EHash/Open-Hardware-Canaan-A851-A3210M/A851_HASH/README.txt

A851_HASH                                   	Software Version

BOM hash851-x26_V1_0_2_180625_BOM.csv

SCH	hash8-X26_V1.0.pdf			PDF

	A3210.SchDoc				Altium Designer 14.3.15

	CONNECTOR.SchDoc			Altium Designer 14.3.15

	total.SchDoc				Altium Designer 14.3.15

PCB	hash851-X26_V1_0_180425.brd		Allegro PCB Designer 16.6
