EHash/Open-Hardware-Canaan-A851-A3210M/A851_MM/README.txt

A851_MM                             		Software Version    

BOM	MM851_V1_0_2_180723_BOM.csv

SCH	MM851_SCH_V1_0_190311.pdf		PDF

	MM851_SCH_V1_0_190311.DSN		OrCAD Capture CIS 16.6

PCB	MM851_V1.0_180330.brd			Allegro PCB Designer 16.6
