EHash/Open-Hardware-Canaan-A851-A3210M/A851_mechanical/Structural drawing/README.txt

	Software

stp	creo

dxf	auto cad

pdf	pdf
