EHash/Open-Hardware-Canaan-A851-A3210M/A851_FC/V1_1/README.txt

A851FC	V1_1					Software Version

Bom	FC7_BOM_V1.1_160929.csv

SCH	fc.PDF				        PDF
	FC.SchDoc				Altium Designer 14.3.15

PCB	FC7_V1.1_160929.PcbDoc			Altium Designer 14.3.15
