EHash/Open-Hardware-Canaan-A851-A3210M/A851_PMU/ISL8120/README.txt

ISL8120 Right_board                                          			Software Version
BOM	PMU851_ISL8120_R_V1_0_4_190311_BOM (NTMFS4C05NT1G).csv
SCH	PMU851_ISL8120_R_SCH_V1_0_1_190311.pdf				        PDF
	pmu851_isl8120_r_sch_v1_0_1_190311.DSN					OrCAD Capture CIS 16.6
PCB	PMU851_IS_R_V1_0_180330.brd					       	Allegro PCB Designer 16.6
ISL8120 Left_Board
BOM	PMU851_ISL8120_L_V1_0_4_190311_BOM (NTMFS4C022NT1G).csv
SCH	PMU851_ISL8120_L_SCH_V1_0_1_190311.pdf				        PDF
	PMU851_ISL8120_L_SCH_V1_0_1_190311.DSN					OrCAD Capture CIS 16.6
PCB	PMU851_IS_L_V1_0_180330.brd					       	Allegro PCB Designer 16.6
