EHash/Open-Hardware-Canaan-A851-A3210M/A851_mechanical/Structural drawing/bah0103v2_0/bah0103v2_0.pdf

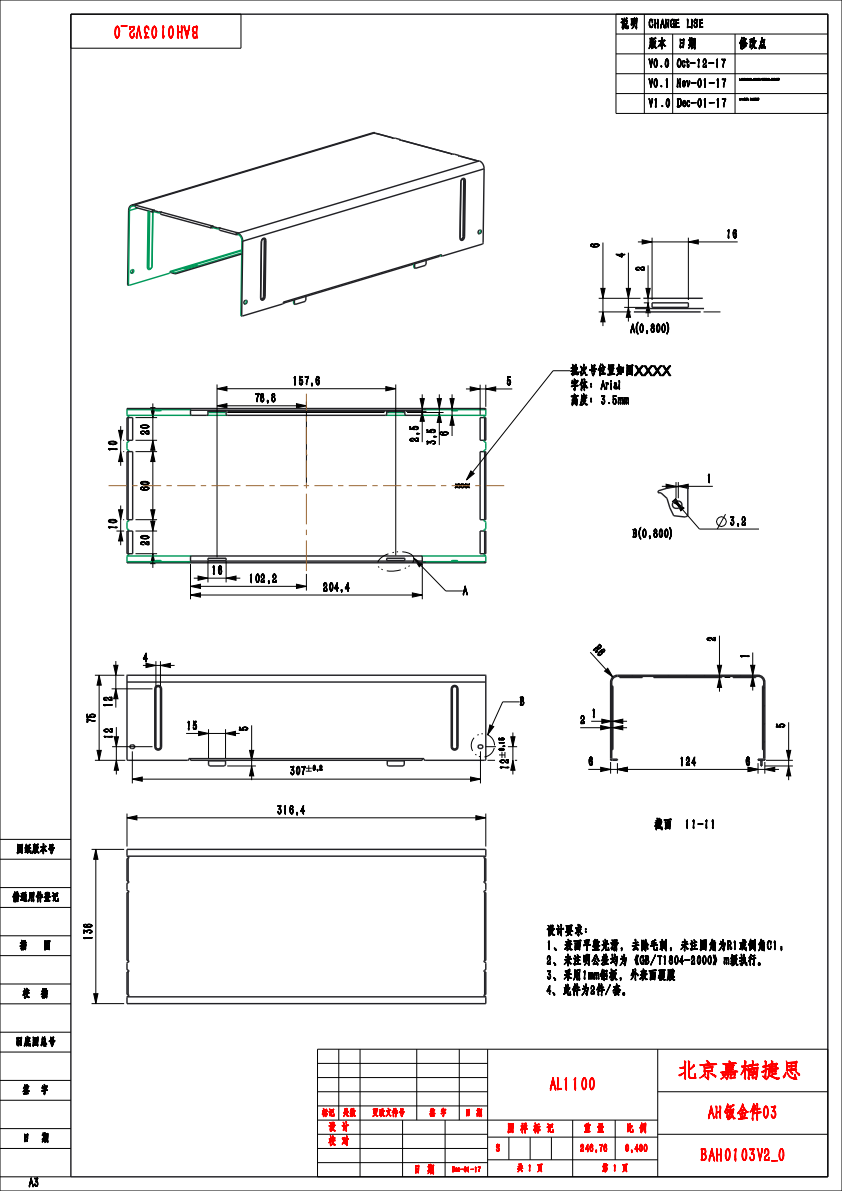
[picture p2: page 1]
图纸版本号; 借通用件登记; 旧底图总号; 北京嘉楠捷思; 更改文件号; AH钣金件03; BAH0103V2_0 S; Dec-01-17; 修改点; V1.0 Dec-01-17 1,V0.1转量产。（无图纸修改）; 设计要求： 1、表面平整光滑，去除毛刺，未注圆角为R1或倒角C1； 2、未注明公差均为《GB/T1804-2000》m级执行。 3、采用1mm铝板，外表面覆膜 4、此件为2件/套。; XXXX; 批次号位置如图XXXX 字体：Arial 高度：3.5mm

说明 CHANGE LISE
V0.0 Oct-12-17

V0.1 Nov-01-17 1,之前由于图纸问题，两侧加强筋，没有做成对称，本次做了调整
