EHash/Open-Hardware-Canaan-A851-A3210M/A851_mechanical/Structural drawing/bah0104v1_1/bah0104v1_1.pdf

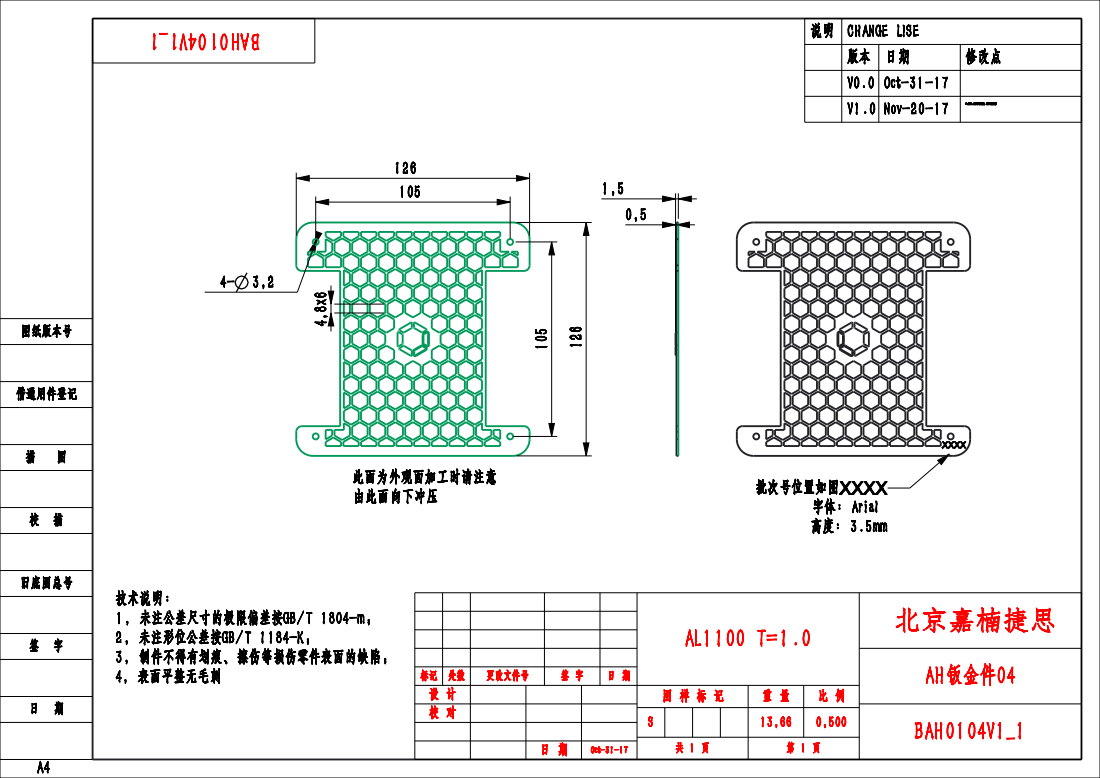
[picture p3: page 1]
图纸版本号; 借通用件登记; 旧底图总号; 北京嘉楠捷思; AH钣金件04 标记 处数; 更改文件号; BAH0104V1_1 S; Oct-31-17; 修改点; 技术说明： 1，未注公差尺寸的极限偏差按GB/T 1804-m； 2，未注形位公差按GB/T 1184-K； 3，制件不得有划痕、擦伤等损伤零件表面的缺陷； 4，表面平整无毛刺; XXXX; 此面为外观面加工时请注意; 由此面向下冲压; 批次号位置如图XXXX; 字体：Arial 高度：3.5mm

说明 CHANGE LISE
V0.0 Oct-31-17

V1.0 Nov-20-17 1,草绘，图层没有隐藏，本次隐藏起来
