EHash/Open-Hardware-Canaan-A851-A3210M/A851_mechanical/Structural drawing/bah0104v2_0/bah0104v2_0.pdf

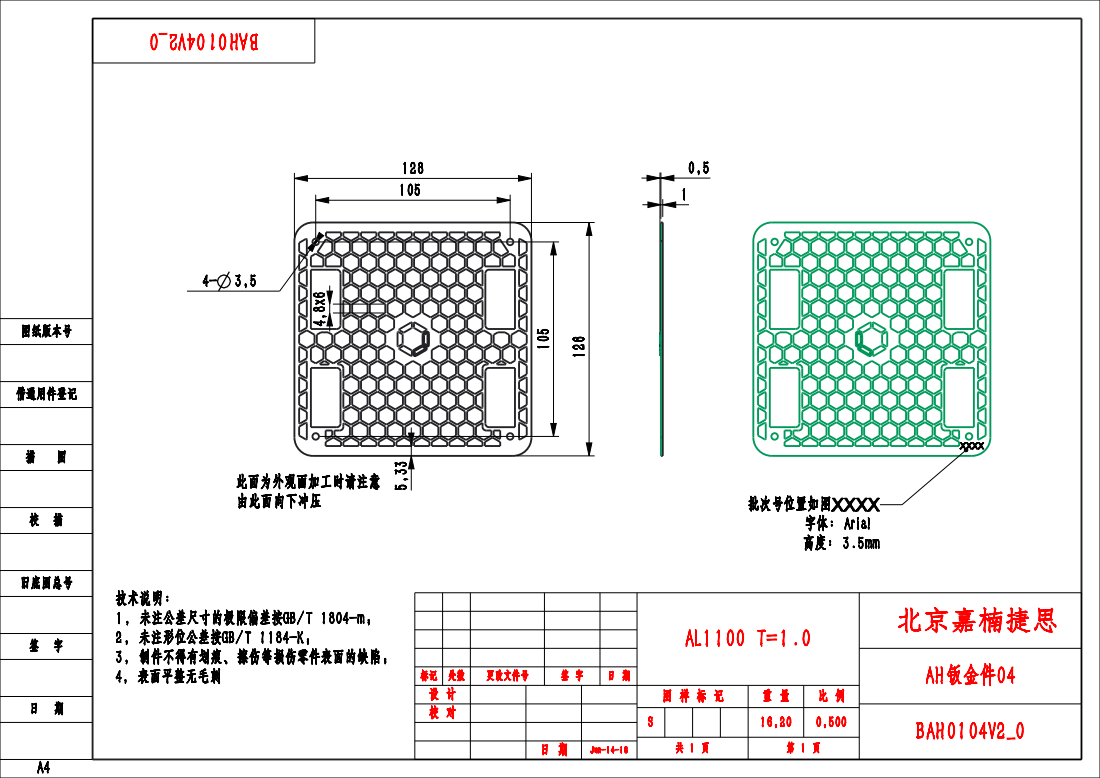
[picture p4: page 1]
图纸版本号; 借通用件登记; 旧底图总号; 北京嘉楠捷思; AH钣金件04 标记 处数; 更改文件号; BAH0104V2_0 S; Jun-14-18; 技术说明： 1，未注公差尺寸的极限偏差按GB/T 1804-m； 2，未注形位公差按GB/T 1184-K； 3，制件不得有划痕、擦伤等损伤零件表面的缺陷； 4，表面平整无毛刺; XXXX; 此面为外观面加工时请注意; 由此面向下冲压; 批次号位置如图XXXX; 字体：Arial 高度：3.5mm
