EHash/Open-Hardware-Canaan-A851-A3210M/A851_mechanical/Structural drawing/bah0201v3_2/bah0201v3_2.pdf

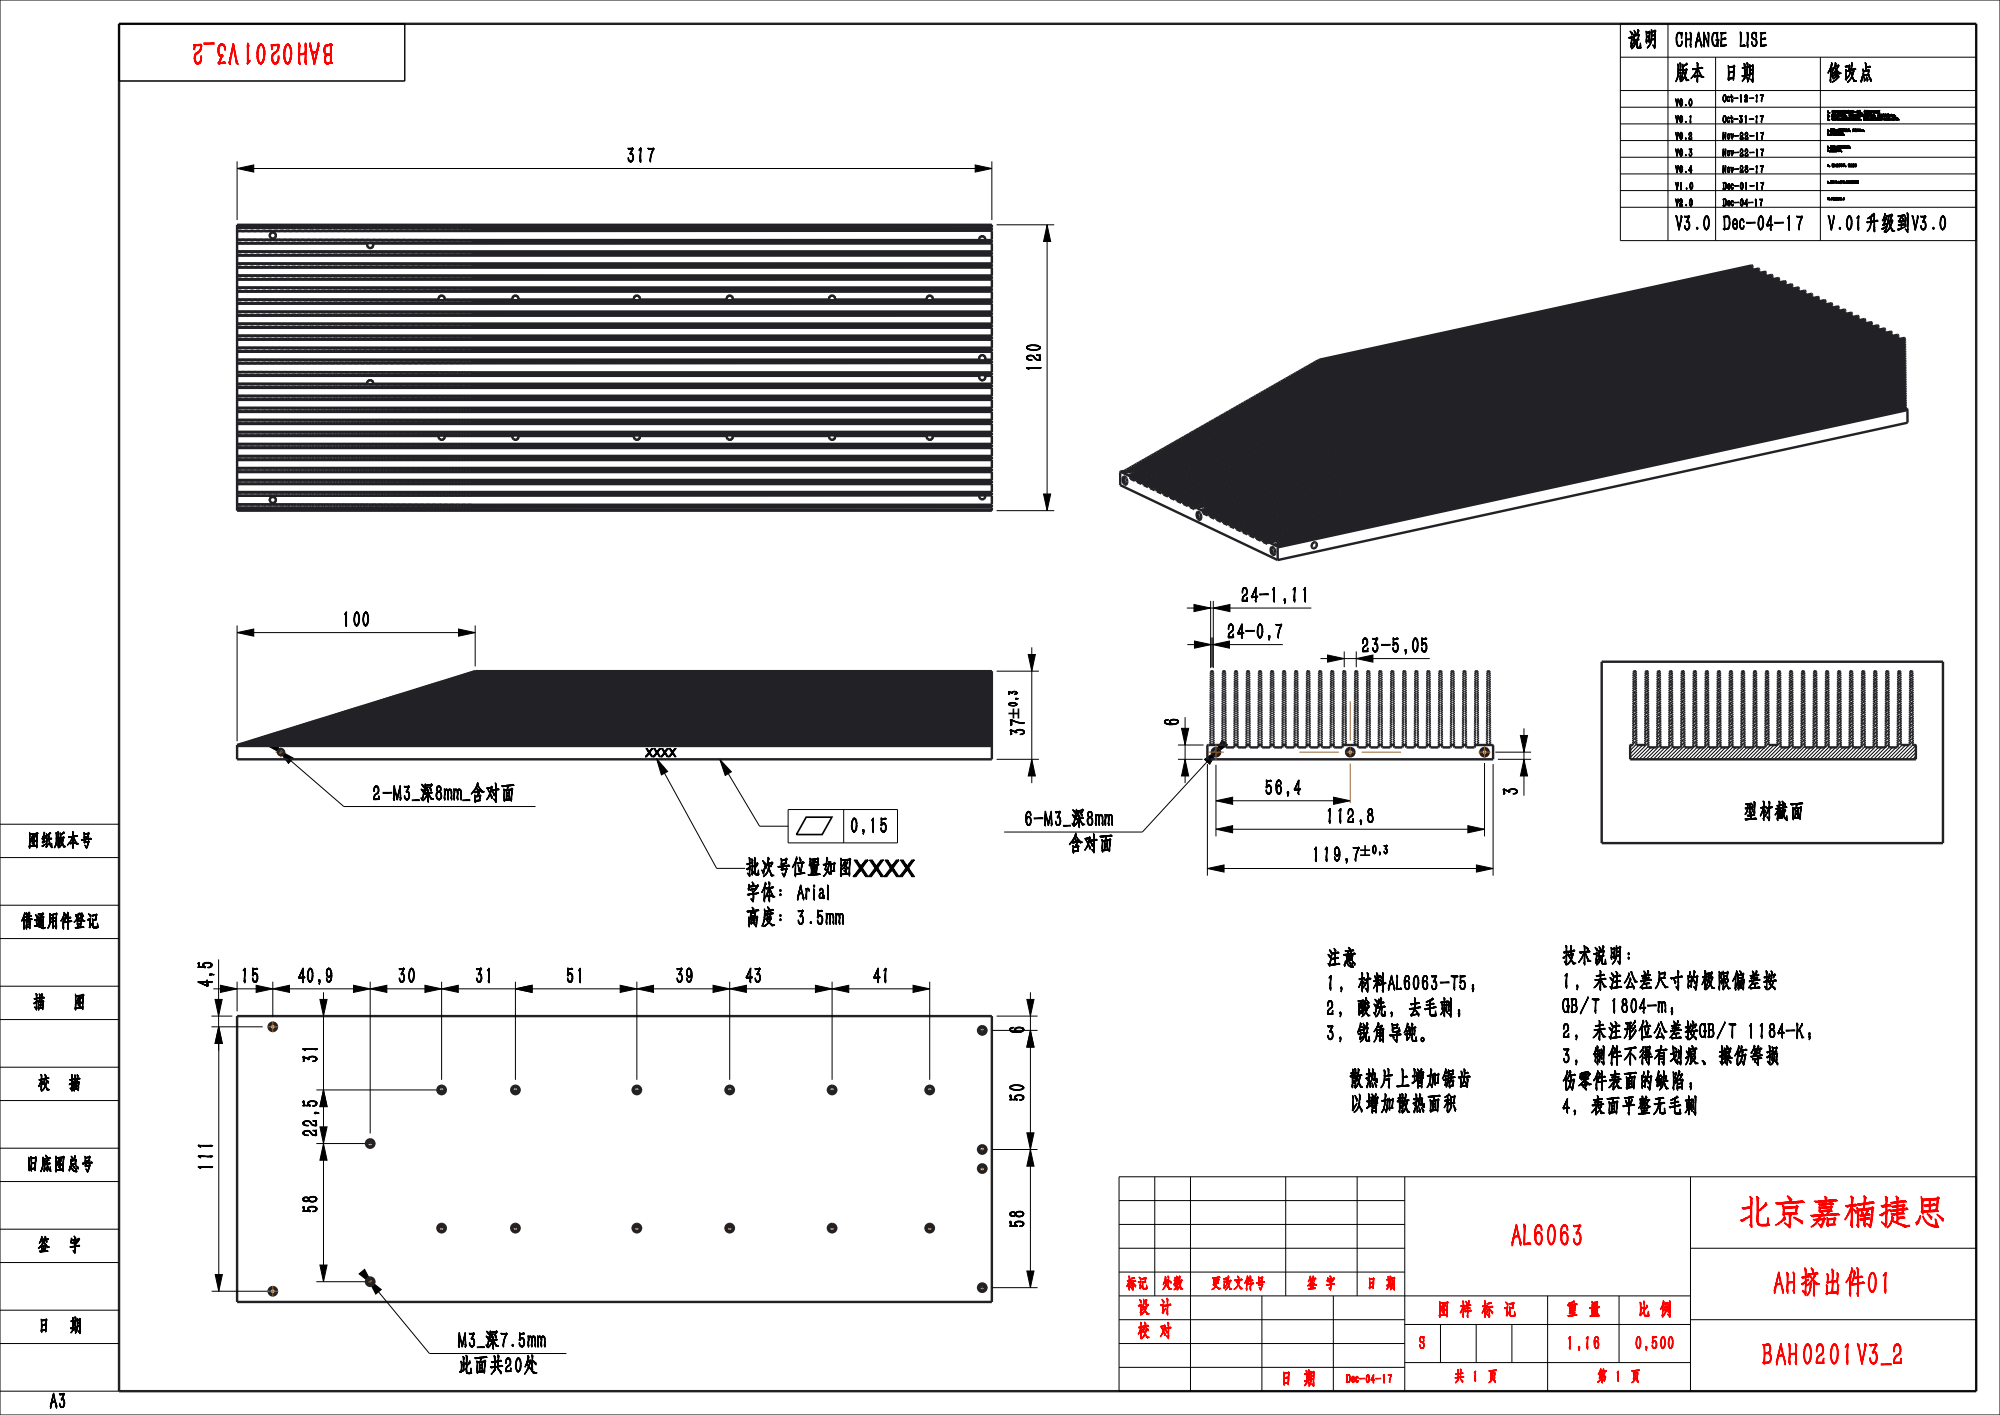
[picture p5: page 1]
图纸版本号; 借通用件登记; 旧底图总号; 6-M _深8mm 含对面; 2-M3_深8mm_含对面; M _深7.5mm 此面共20处; 修改点; Oct-12-17; Oct-31-17; 1，型材中间固定孔增加多一条筋，变成和A741相同 2，HASH板修改了，靠近PMU侧最边上的固定孔，向内移动了13mm； 3，增加了hash与散热片的固定孔，距离上面修改空的尺寸为22.5和30.; Nov-22-17; 1,根据hash板调整长度，变为260mm；; 2,修改固定孔位。; 1,根据hash板调整孔位；; 2,长度为317。; Nov-28-17; 1，增加热管位置，实验样品; Dec-01-17; 1,综合V0.1和V0.2的开孔位置; Dec-04-17; V0.3升级到V2.0; V3.0 Dec-04-17 V.01升级到V3.0; 北京嘉楠捷思; 更改文件号; AH挤出件01; BAH0201V3_2 S; 散热片上增加锯齿 以增加散热面积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
