EHash/Open-Hardware-Canaan-A851-A3210M/A851_mechanical/Structural drawing/bah0301v1_0/bah0301v1_0.pdf

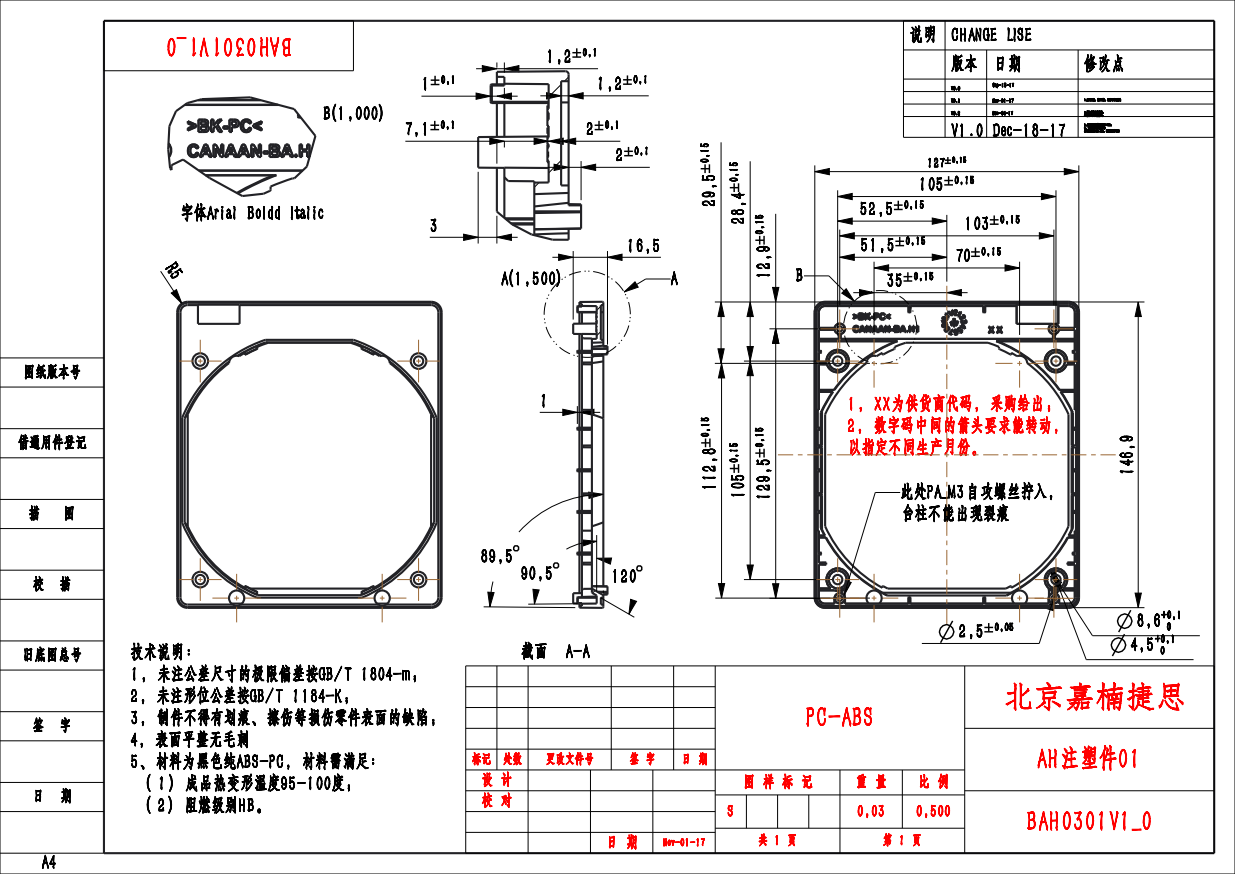
[picture p6: page 1]
图纸版本号; 借通用件登记; 旧底图总号; PC-ABS; 北京嘉楠捷思; 更改文件号; AH注塑件01; BAH0301V1_0 S; Nov-01-17; 修改点; Sep-15-17; 1,图纸细化，增加公差，去掉了草绘轨迹; Nov-04-17; 1,增加厂家识别代码；; 2,增加生产月份标识；; V1.0 Dec-18-17 1,自攻钉孔直径修改为2.5mm；; 2，将与bah0302固定的 柱子直径增加到4.9mm，避免安装后错位; 技术说明： 1，未注公差尺寸的极限偏差按GB/T 1804-m； 2，未注形位公差按GB/T 1184-K； 3，制件不得有划痕、擦伤等损伤零件表面的缺陷； 4，表面平整无毛刺 5、材料为黑色纯ABS-PC，材料需满足： （1）成品热变形温度95-100度； （2）阻燃级别HB。; 1，XX为供货商代码，采购给出； 2，数字码中间的箭头要求能转动， 以指定不同生产月份。; 此处PA_M3自攻螺丝拧入， 台柱不能出现裂痕

说明 CHANGE LISE

字体Arial Boldd Italic
