EHash/Open-Hardware-Canaan-A851-A3210M/A851_mechanical/Structural drawing/bah0303v1_0/bah0303v1_0.pdf

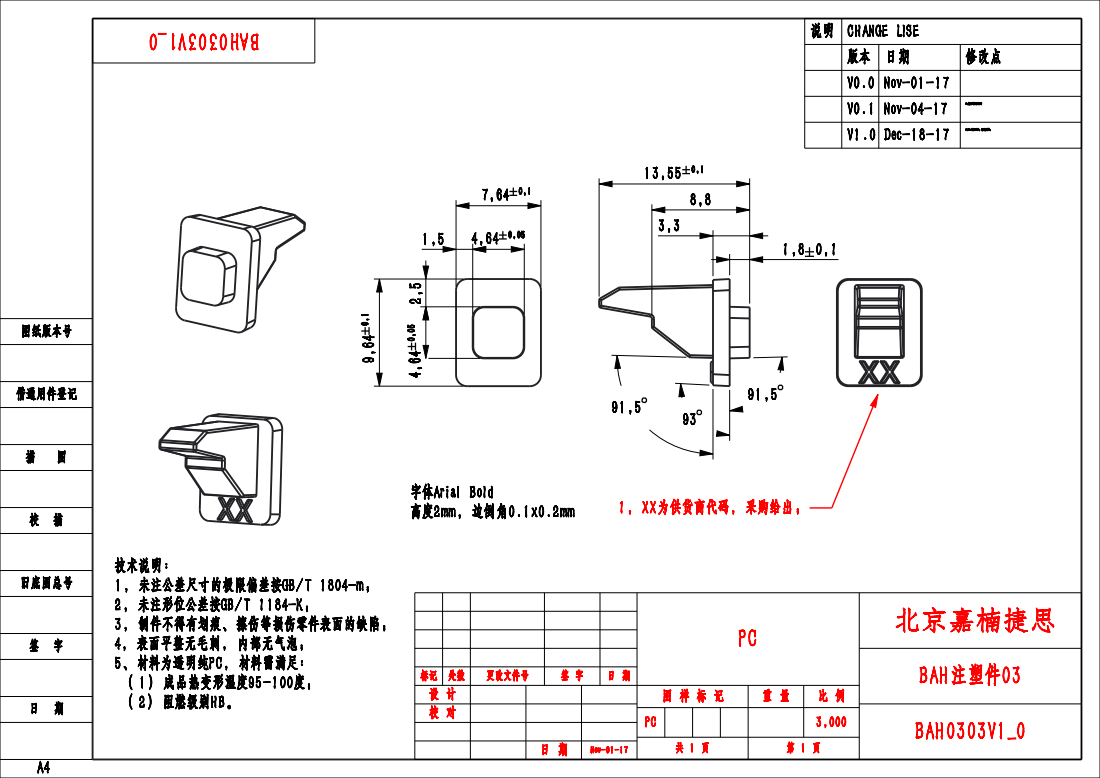
[picture p7: page 1]
图纸版本号; 借通用件登记; 旧底图总号; 北京嘉楠捷思; 更改文件号; BAH注塑件03; BAH0303V1_0 PC; Nov-01-17; 修改点; V1.0 Dec-18-17 1,V0.1转入量产，材质作调整。; 技术说明： 1，未注公差尺寸的极限偏差按GB/T 1804-m； 2，未注形位公差按GB/T 1184-K； 3，制件不得有划痕、擦伤等损伤零件表面的缺陷； 4，表面平整无毛刺, 内部无气泡； 5、材料为透明纯PC，材料需满足： （1）成品热变形温度95-100度； （2）阻燃级别HB。

说明 CHANGE LISE
V0.0 Nov-01-17
V0.1 Nov-04-17 1,增加厂家识别代码

1，XX为供货商代码，采购给出； 字体Arial Bold
高度2mm，边倒角0.1x0.2mm
