EHash/Open-Hardware-Canaan-A851-A3210M/A851_mechanical/Structural drawing/BO131001132V1_0/bo131001132v1_0.pdf

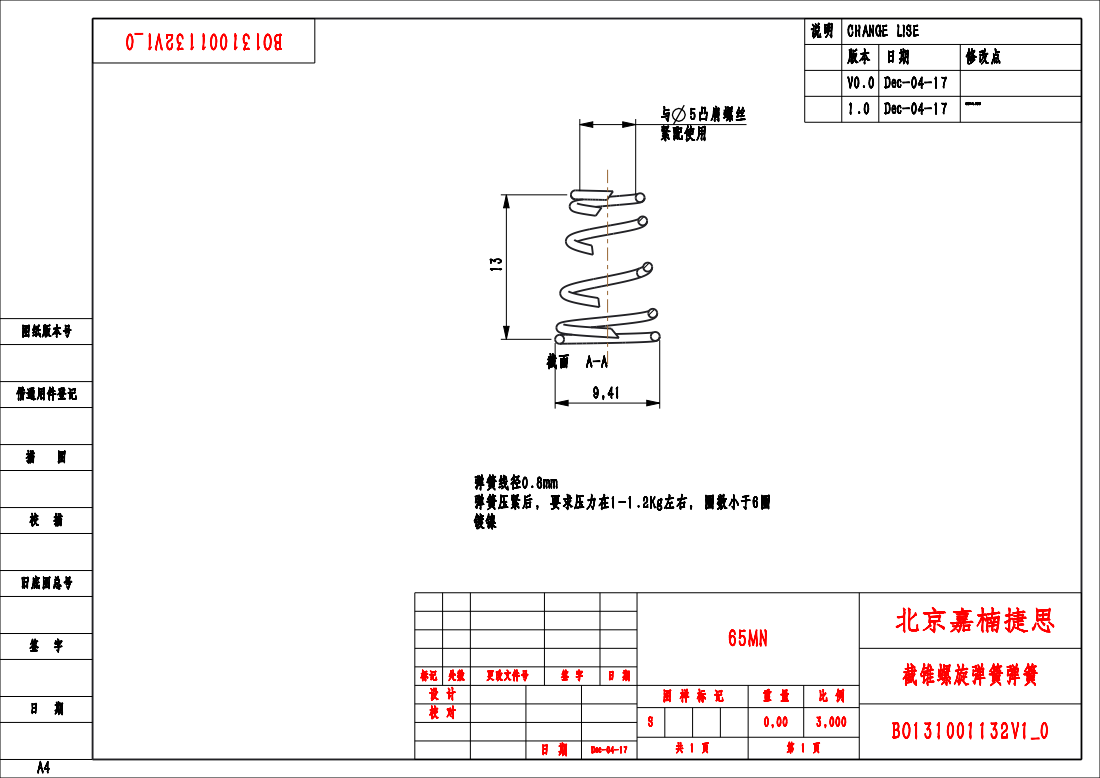
[picture p9: page 1]
图纸版本号; 借通用件登记; 旧底图总号; 凸肩螺丝; 紧配使用; 北京嘉楠捷思; 更改文件号; 截锥螺旋弹簧弹簧; Dec-04-17; 修改点; 弹簧线径0.8mm 弹簧压紧后，要求压力在1-1.2Kg左右，圈数小于6圈 镀镍

说明 CHANGE LISE
V0.0 Dec-04-17
1.0 Dec-04-17 沿用V0.0，无修改
