EHash/Open-Hardware-Canaan-A851-A3210M/A851_mechanical/Structural drawing/bah0102v2_0/bah0102v2_0.pdf

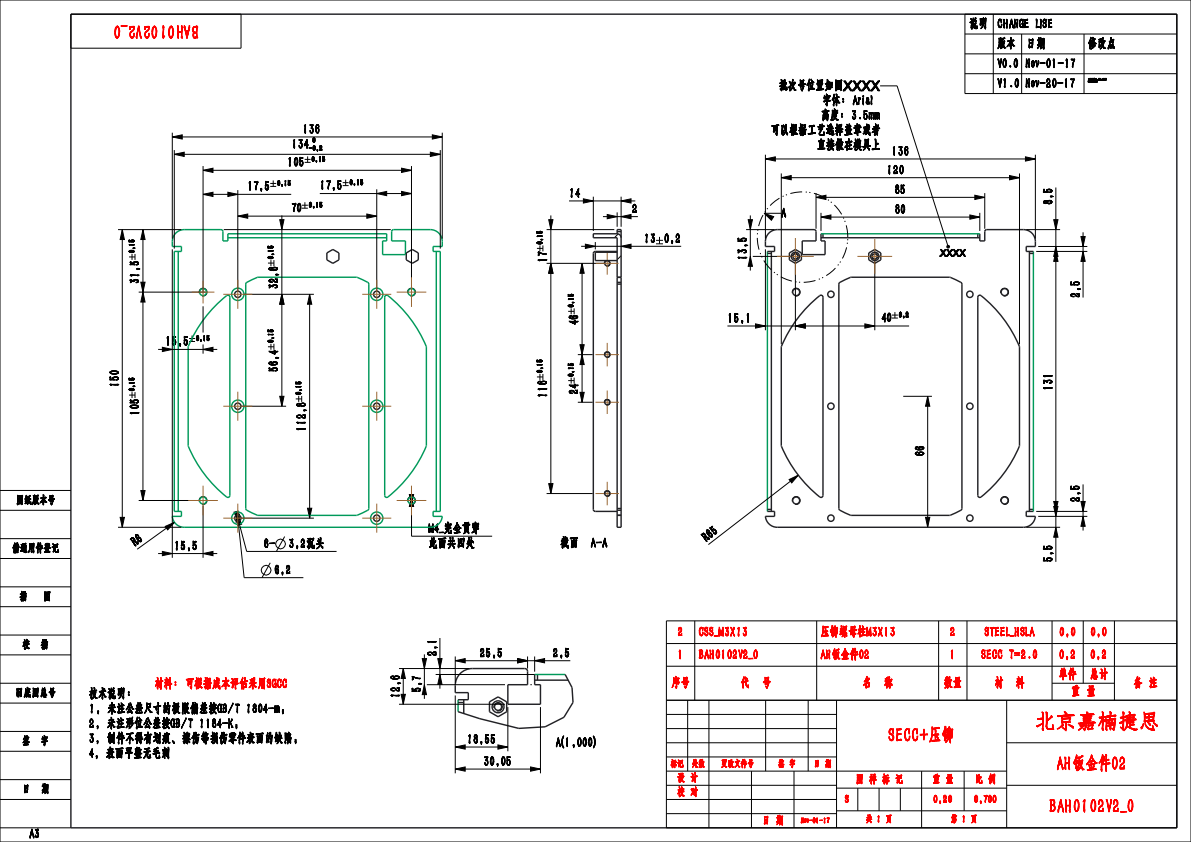
[picture p10: page 1]
图纸版本号; 借通用件登记; 旧底图总号; M _完全贯穿 此面共四处; SECC+压铆; 北京嘉楠捷思; 更改文件号; AH钣金件02; BAH0102V2_0 S; Nov-01-17; 1 BAH0102V2_0; SECC T=2.0; CSS_M3X13; 压铆螺母柱M3X13; STEEL_HSLA; 修改点; 2，高度未标注; 技术说明： 1，未注公差尺寸的极限偏差按GB/T 1804-m； 2，未注形位公差按GB/T 1184-K； 3，制件不得有划痕、擦伤等损伤零件表面的缺陷； 4，表面平整无毛刺; 材料：可根据成本评估采用SGCC; XXXX; 批次号位置如图XXXX 字体：Arial 高度：3.5mm 可以根据工艺选择盖章或者 直接做在模具上

说明 CHANGE LISE
V0.0 Nov-01-17

V1.0 Nov-20-17 1,螺柱参数以、名称、未修改
