EHash/Open-Hardware-Canaan-A851-A3210M/A851_mechanical/Structural drawing/bah0202v3_1/bah0202v3_1.pdf

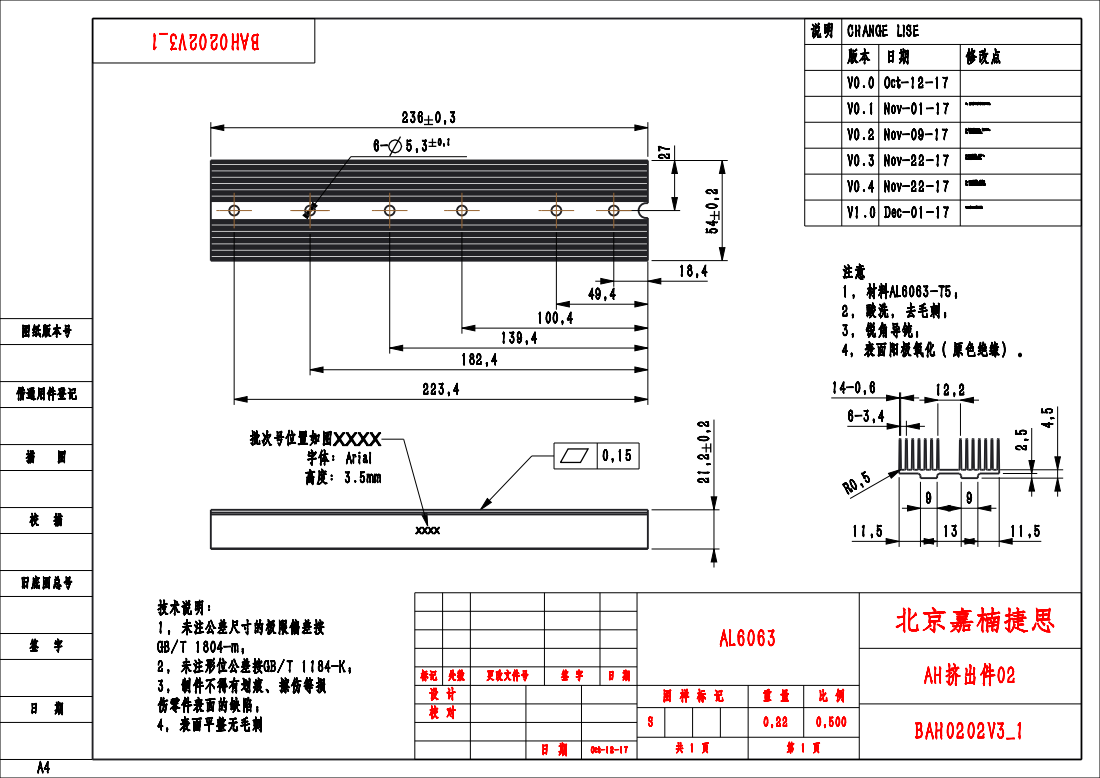
[picture p11: page 1]
图纸版本号; 借通用件登记; 旧底图总号; 北京嘉楠捷思; 更改文件号; AH挤出件02; BAH0202V3_1 S; Oct-12-17; 修改点; V0.1 Nov-01-17 1，箭头旁边的空移动了11mm。; V0.2 Nov-09-17 1,散热片变短9mm，增加缺口；; 2，并去掉冲压三角。; 2,散热片减少57mm。; 2，散热片长度增加57mm; 注意 1，材料AL6063-T5; 2，酸洗，去毛刺； 3，锐角导钝； 4，表面阳极氧化（原色绝缘）。; 技术说明： 1，未注公差尺寸的极限偏差按 GB/T 1804-m； 2，未注形位公差按GB/T 1184-K； 3，制件不得有划痕、擦伤等损 伤零件表面的缺陷； 4，表面平整无毛刺; XXXX; 批次号位置如图XXXX 字体：Arial 高度：3.5mm

说明 CHANGE LISE
V0.0 Oct-12-17

V0.3 Nov-22-17 1,hash板调整。方案一；
V0.4 Nov-22-17 1，hash板调整，方案二
V1.0 Dec-01-17 V0.2和V0.3综合开孔
