EHash/Open-Hardware-Canaan-A851-A3210M/A851_mechanical/Structural drawing/bah0203v1_0/bah0203v1_0.pdf

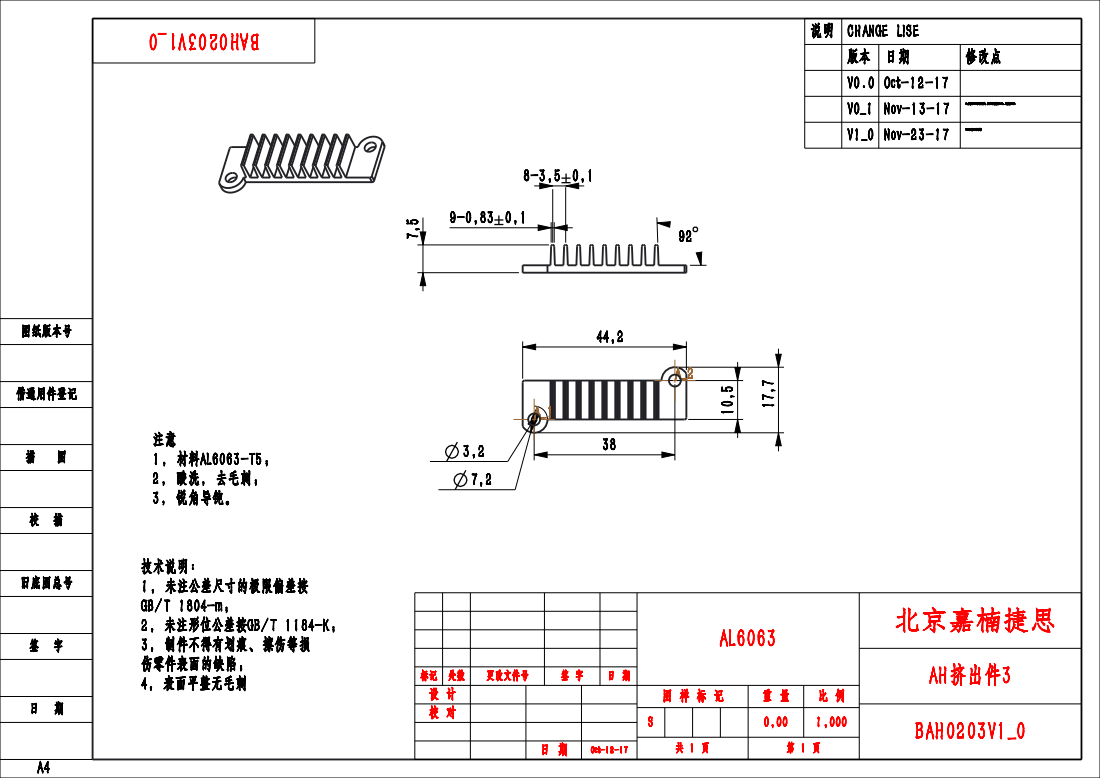
[picture p12: page 1]
图纸版本号; 借通用件登记; 旧底图总号; 北京嘉楠捷思; 更改文件号; AH挤出件3; BAH0203V1_0 S; Oct-12-17; 修改点; V0_1 Nov-13-17 1,根据加工工艺进行调整，孔距边右侧增加0.5；上侧增加1mm; V1_0 Nov-23-17 V0_1更新至量产版本; 技术说明： 1，未注公差尺寸的极限偏差按 GB/T 1804-m； 2，未注形位公差按GB/T 1184-K； 3，制件不得有划痕、擦伤等损 伤零件表面的缺陷； 4，表面平整无毛刺; 注意 1，材料AL6063-T5; 2，酸洗，去毛刺； 3，锐角导钝。

说明 CHANGE LISE
V0.0 Oct-12-17
