EHash/Open-Hardware-Canaan-A851-A3210M/A851_mechanical/Structural drawing/bah0302v1_0/bah0302v1_0.pdf

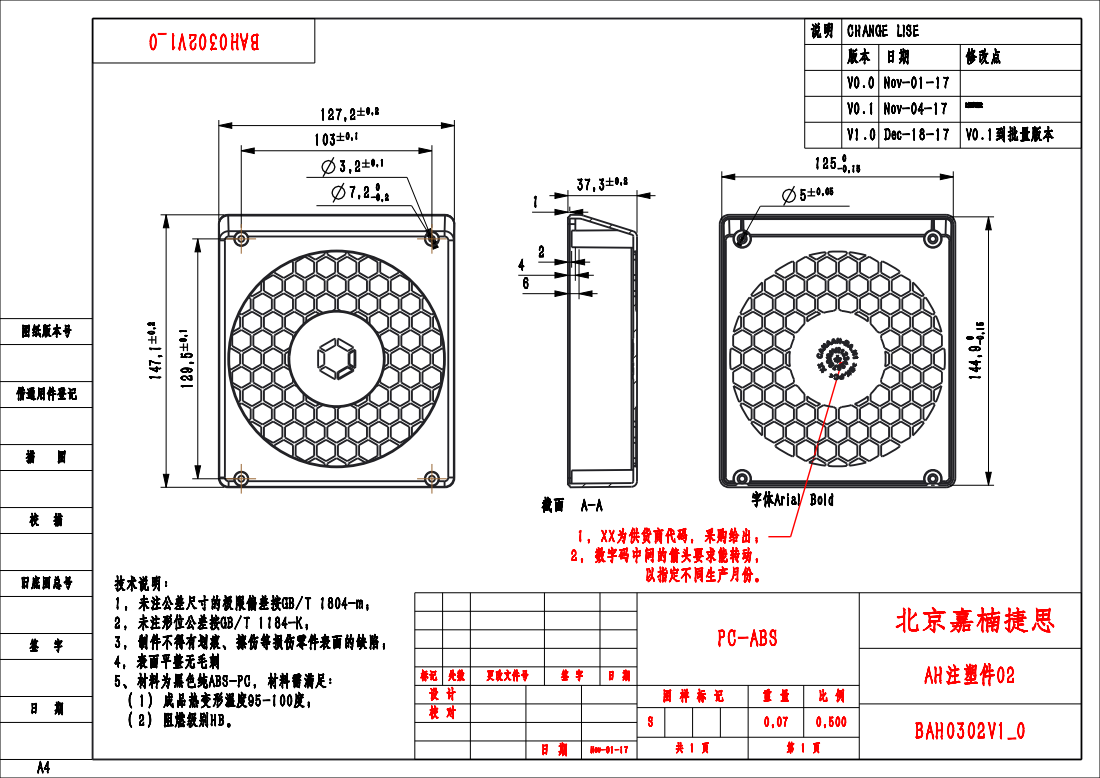
[picture p13: page 1]
图纸版本号; 借通用件登记; 旧底图总号; PC-ABS; 北京嘉楠捷思; 更改文件号; AH注塑件02; BAH0302V1_0 S; Nov-01-17; 说明 CHANGE LISE; 修改点; V0.0 Nov-01-17; V0.1 Nov-04-17 1,增加厂家识别代码；; 2,增加生产月份标识； V1.0 Dec-18-17 V0.1到批量版本; 技术说明： 1，未注公差尺寸的极限偏差按GB/T 1804-m； 2，未注形位公差按GB/T 1184-K； 3，制件不得有划痕、擦伤等损伤零件表面的缺陷； 4，表面平整无毛刺 5、材料为黑色纯ABS-PC，材料需满足： （1）成品热变形温度95-100度； （2）阻燃级别HB。; 字体Arial Bold A-A; 1，XX为供货商代码，采购给出； 2，数字码中间的箭头要求能转动， 以指定不同生产月份。
