EHash/Open-Hardware-Canaan-A851-A3210M/A851_HASH/BOM/HASH851-x26_V1.0.2_BOM.xls

hash851-x26_V1.0.2
Notes;
1) 电阻默认5%精度
2) 小于100nF的电容默认是25V/50V, COG/X7R类型; 大于100nF的电容默认是6.3V, X7R/X5R类型
序号 | 类型 | 位号 | 描述 | 值 | 厂家编号 | 厂家 | 封装 | 数量 | 备注
1 | 贴片电容 | C1_A0, C1_A1, C1_A2, C1_A3, C1_A4, C1_A5, C1_A6, C1_A7, C1_A8, C1_A9, C1_A10, C1_A11, C1_A12, C1_A13, C1_A14, C1_A15, C1_A16, C1_A17, C1_A18, C1_A19, C1_A20, C1_A21, C1_A22, C1_A23, C1_A24, C1_A25, C5, C6, C9 | MLCC,2.2uF,±20%,6.3V,X5R,C0402 | 2.2uF/6.3V_C0402 | CL05A225MQ | Samsung | C0402 | 29
2 | 贴片电容 | C2_A0, C2_A1, C2_A2, C2_A3, C2_A4, C2_A5, C2_A6, C2_A7, C2_A8, C2_A9, C2_A10, C2_A11, C2_A12, C2_A13, C2_A14, C2_A15, C2_A16, C2_A17, C2_A18, C2_A19, C2_A20, C2_A21, C2_A22, C2_A23, C2_A24, C2_A25 | MLCC,22uF,±20%,6.3V,X5R,C0603 | 22uF/6.3V_C0603 | CL10A226MQ | Samsung | C0603 | 26
3 | 贴片电容 | C7_A0, C7_A1, C7_A2, C7_A3, C7_A4, C7_A5, C7_A6, C7_A7, C7_A8, C7_A9, C7_A10, C7_A11, C7_A12, C7_A13, C7_A14, C7_A15, C7_A16, C7_A17, C7_A18, C7_A19, C7_A20, C7_A21, C7_A22, C7_A23, C7_A24, C7_A25, C8_A0, C8_A1, C8_A2, C8_A3, C8_A4, C8_A5, C8_A6, C8_A7, C8_A8, C8_A9, C8_A10, C8_A11, C8_A12, C8_A13, C8_A14, C8_A15, C8_A16, C8_A17, C8_A18, C8_A19, C8_A20, C8_A21, C8_A22, C8_A23, C8_A24, C8_A25 | MLCC,100nF,±20%,6.3V,X5R,C0402 | 100nF/6.3V_C0402 | CL05A104MQ | Samsung | C0402 | 52
4 | 贴片固态电容 | C4 | Surface Soild Cap,270uF,±20%,16V,ESR:8mΩ,6.3x9.9MM | 270uF/16V | 16SVPG270M | 松下 | C6666-100 | 1
5 | 贴片电阻 | R3_A0, R3_A1, R3_A2, R3_A3, R3_A4, R3_A5, R3_A6, R3_A7, R3_A8, R3_A9, R3_A10, R3_A11, R3_A12, R3_A13, R3_A14, R3_A15, R3_A16, R3_A17, R3_A18, R3_A19, R3_A20, R3_A21, R3_A22, R3_A23, R3_A24, R3_A25 | Resistor,0Ω,±5%,1/10W,R0603 | 0R | RC1608J000CS | Samsung | R0603 | 26
6 | 贴片电阻 | RJ1, RJ2, RJ3, RJ4, RJ5 | Resistor,0Ω,±5%,1/4W,R1206 | 0R | RC3216J000CS | Samsung | R1206 | 5
7 | 贴片电阻 | R1_A0, R1_A1, R1_A2, R1_A3, R1_A4, R1_A5, R1_A6, R1_A7, R1_A8, R1_A9, R1_A10, R1_A11, R1_A12, R1_A13, R1_A14, R1_A15, R1_A16, R1_A17, R1_A18, R1_A19, R1_A20, R1_A21, R1_A22, R1_A23, R1_A24, R1_A25 | Resistor,470Ω,±5%,1/16W,R0402 | 470R_R0402 | RC1005J471CS | Samsung | R0402 | 26
8 | 排阻 | RN1_A0, RN1_A1, RN1_A2, RN1_A3, RN1_A4, RN1_A5, RN1_A6, RN1_A7, RN1_A8, RN1_A9, RN1_A10, RN1_A11, RN1_A12, RN1_A13, RN1_A14, RN1_A15, RN1_A16, RN1_A17, RN1_A18, RN1_A19, RN1_A20, RN1_A21, RN1_A22, RN1_A23, RN1_A24, RN1_A25 | Resistor Array,10P8R,2K,±5%,1/16W,R0402 | 2K | CAV10P8RL202JT | SUP | RN0402-8-A | 26
9 | 铜台柱 | GND1，VCORE | 铜台柱，底座直径为10MM，高度15MM，内径3.5MM | BAH0501V2_0 | BAH0501V2_0 |  | PILLAR-10_2MM | 2 | 订制物料
10 | 表贴排母连接器 | J1 | 表贴排母连接器 2x7pin，2.0mm，SMD，双排带柱 | Header 7X2-2.0mm |  |  | head-idc-14-80-275-p2-smd | 1
11 | 有源晶振 | OSC | MEMS oscillators,25MHz,±25PPM,1.8V,2.5x2.0MM | SiT1602BI-12-18E-25MHz | SiT1602BI-12-18E-25MHz | SiTime | X4-2520-010 | 1
12 | 芯片 | U1_A0, U1_A1, U1_A2, U1_A3, U1_A4, U1_A5, U1_A6, U1_A7, U1_A8, U1_A9, U1_A10, U1_A11, U1_A12, U1_A13, U1_A14, U1_A15, U1_A16, U1_A17, U1_A18, U1_A19, U1_A20, U1_A21, U1_A22, U1_A23, U1_A24, U1_A25 | LDO,Vin:1.7-5.5V;Iout:300mA,Vout:0.75V,Vdrop:245mV/@1.85V,UTDFN-1x1 | NCP114AMX075TCG | NCP114AMX075TCG | ON | DFN4-065-0101-006-N | 26
13 | 芯片 | U2_A0, U2_A1, U2_A2, U2_A3, U2_A4, U2_A5, U2_A6, U2_A7, U2_A8, U2_A9, U2_A10, U2_A11, U2_A12, U2_A13, U2_A14, U2_A15, U2_A16, U2_A17, U2_A18, U2_A19, U2_A20, U2_A21, U2_A22, U2_A23, U2_A24, U2_A25 | LDO,Vin:1.6-5.5V;Iout:300mA,Vout:1.8V,Vdrop:320mV/@1.8V,UTDFN-1x1 | SGM2036-1.8YUDH4G/TR | SGM2036-1.8YUDH4G/TR | SGMICRO | DFN4-065-0101-006-N | 26
14 | 芯片 | U3 | Digital Isolators,3 groups 1.8V-5V translation,SOIC16 | ADUM130E0BRZ | ADUM130E0BRZ-RL7 | ADI | SOP16-50-157-69 | 1
15 | 芯片 | A8_A0,A8_A1,A8_A2,A8_A3,A8_A4,A8_A5,A8_A6,A8_A7,A8_A8,A8_A9,A8_A10,A8_A11,A8_A12,A8_A13,A8_A14,A8_A15,A8_A16,A8_A17,A8_A18,A8_A19,A8_A20,A8_A21,A8_A22,A8_A23,A8_A24,A8_A25 | A3210 | A3210 | A3210 | 嘉楠捷思 | DFN-A8-007 | 26
以下不焊接
1 | 贴片电容 | C3_A0, C3_A1, C3_A2, C3_A3, C3_A4, C3_A5, C3_A6, C3_A7, C3_A8, C3_A9, C3_A10, C3_A11, C3_A12, C3_A13, C3_A14, C3_A15, C3_A16, C3_A17, C3_A18, C3_A19, C3_A20, C3_A21, C3_A22, C3_A23, C3_A24, C3_A25 | 贴片电阻 0805封装 22uF/6.3V | 22uF/6.3V_C0805_NL |  |  | C0805 | 26
2 | 贴片电阻 | R2_A0, R2_A1, R2_A2, R2_A3, R2_A4, R2_A5, R2_A6, R2_A7, R2_A8, R2_A9, R2_A10, R2_A11, R2_A12, R2_A13, R2_A14, R2_A15, R2_A16, R2_A17, R2_A18, R2_A19, R2_A20, R2_A21, R2_A22, R2_A23, R2_A24, R2_A25 | 贴片电阻 0603封装 1K | NL_1K |  |  | R0603 | 26
3 | 贴片电阻 | R4_A0, R4_A1, R4_A2, R4_A3, R4_A4, R4_A5, R4_A6, R4_A7, R4_A8, R4_A9, R4_A10, R4_A11, R4_A12, R4_A13, R4_A14, R4_A15, R4_A16, R4_A17, R4_A18, R4_A19, R4_A20, R4_A21, R4_A22, R4_A23, R4_A24, R4_A25 | 贴片电阻 0402封装 1K | NL_1K |  |  | R0402 | 26
