EHash/Open-Hardware-Canaan-A851-A3210M/A851_MM/BOM/MM851_V1.0.2_BOM.xls

MM851_V1.0.2_BOM
Notes;
1) 电阻默认5%精度
2) 小于100nF的电容默认是25V/50V, COG/X7R类型; 大于100nF的电容默认是6.3V, X7R/X5R类型
序号 | 类型 | 位号 | 描述 | 值 | 厂家编号 | 厂家 | 封装 | 数量 | 备注
1 | 贴片陶瓷电容 | C1,C2,C3,C6,C7,C9,C11,C12,C13,C14,C15,C16,C17,C18,C22,C23,C24,C25,C26,C27,C28,C30,C32,C33,C35,C36,C39,C42,C43,C49,C50,C55,C56 | MLCC,100nF,±10%,25V,X5R,C0402 | 100nF/25V | CL05A104KA | Samsung | C0402 | 33
2 | 贴片陶瓷电容 | C4,C5,C8,C10,C19,C20,C21 | MLCC,4.7uF,±20%,6.3V,X5R,C0603 | 4.7uF/6.3V | CL10A475MQ | Samsung | C0603 | 7
3 | 贴片陶瓷电容 | C31,C38 | MLCC,22uF,±20%,16V,X5R,C1206 | 22uF/16V | CL31A226MO | Samsung | C1206 | 2
4 | 贴片陶瓷电容 | C34 | MLCC,330pF,±5%,50V,C0G,0402 | 330pF/50V | CL05C331JB | Samsung | C0402 | 1
5 | 贴片陶瓷电容 | C46,C47,C53,C59 | MLCC,22uF,±20%,6.3V,X5R,C0603 | 22uF/6.3V | CL10A226MQ | Samsung | C0603 | 4
6 | 贴片陶瓷电容 | C48,C54 | MLCC,10pF,±5%,50V,C0G,0402 | 10pF/50V | CL05C100JB | Samsung | C0402 | 2
7 | 贴片陶瓷电容 | C51,C57 | MLCC,10uF,±20%,16V,X5R,C0805 | 10uF/16V | CL21A106MO | Samsung | C0805 | 2
8 | 双排2.0直插针 | DATA1,DATA2 | 双排直插针，2.0mm | CON16x2 |  |  | HEAD2X16-79 | 2
9 | 贴片双二极管 | D1,D2 | Series-pair Switching Diodes,VR:70V,IF:200mA,PD:350mW,SOT23 | BAV99 | BAV99 | Nexperia | SOT23-3-43 | 2
10 | 肖特基二极管 | D4,D6 | Schottky Rectifier Diodes,VR:40V,IF:3.0A,VF:0.5V,IR:0.5mA,DO-214AC | APD340VR | APD340VRTR-G1 | DIODES | D2010-89 | 2
11 | 贴片肖特基二极管 | D7 | Schottky diode,VR:20V,IF:500mA,IR:0.03@VR=10V,SOD523 | PMEG2005EB | PMEG2005EB,115 | Nexperia | SOD523-2-28 | 1
12 | 风扇插座 | FAN1 | 4pin 插座， 直角安装，2.5mm | CON4 | 25003-4WAP | 红星 | HEAD4-98-240-H | 1
13 | 贴片磁珠 | FB1 | 0402 磁珠 600R@100MHz,300mA | BLM15AG601SN1 | BLM15AG601SN1 | MURATA | FB0402 | 1
14 | 贴片磁珠 | FB2,FB3 | 1206 磁珠 120R@100MHz,3A | BLM31PG121SN1 | BLM31PG121SN1 | MURATA | FB1206 | 2
15 | 自恢复保险丝 | F2 | 1812 自恢复保险丝 | MF-MSMF110-2 | MF-MSMF110-2 | BOURNS | F1812 | 1
16 | 直角插座 | IIC1,IIC2 | 5PIN带壳直角插座 | CON5 | A2547-WR-5P | CJTCONN | head5-100 | 2
17 | 三色发光二极管 | LED1 | 共阳极三色LED | LED RGB SMD |  | 科达 | LED3528RGB | 1
18 | 贴片发光二极管 | LED2,LED4 | 0603 贴片发光二极管 绿色 | GREEN | LTST-C193KGKT-5A | LITEON | LED0603 | 2
19 | 贴片发光二极管 | LED3 | 0603 贴片发光二极管 黄色 | YELLOW | LTST-C193KSKT-5A | LITEON | LED0603 | 1
20 | 贴片电感 | L1 | Power?Choke?Coil,4.7uH,±20%,DRC:35mΩ,Idc:5.5A,6.95x6.6x2.8MM | 4.7uH | PCMB063T-4R7MS | CYNTEC | PL0606-027 | 1
21 | 贴片电感 | L2,L3 | Metal Composite Inductor,2.2uH,±20%,2.5A,80mΩ,2.5x2.0x1.0MM | 2.2uH | CIGT252010LM2R2MNE | Samsung | pl0303-017 | 2
22 | 自恢复保险丝 | PS1,PS2 | 0805，自恢复保险丝 | MF-PSMF010X-2 | MF-PSMF010X-2 | BOURNS | F0805 | 2
23 | 贴片三极管 | Q1 | 贴片NPN三极管，SOT-23 | NMBT3904 | NMBT3904LT1 | NXP | SOT23-3-43 | 1
24 | 贴片电阻 | R1,R8,R9,R10,R11,R21,R26,R31,R34 | Resistor,4.7KΩ,±5%,1/16W,R0402 | 4.7K | RC1005J472CS | Samsung | R0402 | 9
25 | 贴片电阻 | R4,R6,R7,R12,R42 | Resistor,220Ω,±5%,1/16W,R0402 | 220R | RC1005J221CS | Samsung | R0402 | 5
26 | 贴片电阻 | R5,R19,R25,R29,R30,R35,R36,R37,R38 | Resistor,100Ω,±5%,1/16W,R0402 | 100R | RC1005J101CS | Samsung | R0402 | 9
27 | 贴片电阻 | R13 | Resistor,51Ω,±5%,1/16W,R0402 | 51R | RC1005J510CS | Samsung | R0402 | 1
28 | 贴片电阻 | R14,R15,R16,R17 | Resistor,2KΩ,±5%,1/16W,R0402 | 2K | RC1005J202CS | Samsung | R0402 | 4
29 | 贴片电阻 | R18,R27,R28 | Resistor,1.8KΩ,±5%,1/16W,R0402 | 1.8K | RC1005J182CS | Samsung | R0402 | 3
30 | 贴片电阻 | R22 | Resistor,1KΩ,±5%,1/16W,R0402 | 1K | RC1005J102CS | Samsung | R0402 | 1
31 | 贴片电阻 | R23,R33 | Resistor,270Ω,±5%,1/16W,R0402 | 270R | RC1005J271CS | Samsung | R0402 | 2
32 | 贴片电阻 | R24,R43,R46,R49 | Resistor,10KΩ,±5%,1/16W,R0402 | 10K | RC1005J103CS | Samsung | R0402 | 4
33 | 贴片电阻 | R32 | Resistor,510Ω,±5%,1/16W,R0402 | 510R | RC1005J511CS | Samsung | R0402 | 1
34 | 贴片电阻 | R39 | Resistor,0Ω,±5%,1/16W,R0402 | 0R | RC1005J000CS | Samsung | R0402 | 1
35 | 贴片电阻 | R44 | Resistor,75KΩ,±1%,1/16W,R0402 | 75K/1% | RC1005F753CS | Samsung | R0402 | 1
36 | 贴片电阻 | R45,R48,R51 | Resistor,24KΩ,±1%,1/16W,R0402 | 24K/1% | RC1005F243CS | Samsung | R0402 | 3
37 | 贴片电阻 | R47 | Resistor,30KΩ,±1%,1/16W,R0402 | 30K/1% | RC1005F303CS | Samsung | R0402 | 1
38 | 贴片电阻 | R50 | Resistor,12KΩ,±1%,1/16W,R0402 | 12K/1% | RC1005F123CS | Samsung | R0402 | 1
39 | 瞬间稳态二极管 | TVS1,TVS3 | TVS,Uni-Directional,VRWM:5V,VC:9.2V,IPPM:43.5A,SMA | SMAJ5.0A | SMAJ5.0A | Diodes | D2010-89 | 2
40 | 瞬间稳态二极管 | TVS2 | TVS,Uni-Directional,VRWM:15V,VC:24.4V,IPPM:16.4A,SMA | SMAJ15A | SMAJ15A | Diodes | D2010-89 | 1
41 | 集成电路 | U1 | FPGA, Spartan-6,LAB:1879,RAM:958464,LFBGA484 | XC6SLX25-2FTG256C | XC6SLX25-2FTG256C | XILINX | BGA256-100-1717-021 | 1
42 | 集成电路 | U2 | Digital Temperature Sensor,I2C/SMBus,SOT563 | TMP102AIDRLR | TMP102AIDRLR | TI | SOT563-6-24 | 1
43 | 集成电路 | U4 | Bidirectional I2C Isolators,SOIC8 | ISO1540DR | ISO1540DR | TI | SOP8-50-157-70 | 1
44 | 集成电路 | U5 | Serial Flash,16M-bit,133MHz,SPI,SOIC8 | W25Q16JVSSIQ | W25Q16JVSSIQ | Winbond | SOP8-50-210-85 | 1
45 | 集成电路 | U6,U7,U8 | RT6212A/B, 2A, 4.5V-18V, 500kHz, Buck | RT6212AHGJ6F | RT6212AHGJ6F | RICHTEK | SOT23-6-49 | 3
46 | 贴片晶振 | Y1 | MEMS oscillators,25MHz,±25PPM,1.8V,2.5x2.0MM | SiT1602BI-12-18E-25MHz | SiT1602BI-12-18E-25MHz | SiTime | X4-2520-010 | 1
以下器件不焊接
1 | 直插单排针 | CON1 | 2.54mm 2pin 直插单排针 | +12VIN_NL |  |  | head2-100 | 1
2 | 贴片陶瓷电容 | C37 | 贴片陶瓷电容 | 100nF/16V_NL |  |  | C0402 | 1
3 | 贴片陶瓷电容 | C45,C52,C58 | 贴片陶瓷电容 | 100nF/25V/NL |  |  | C0402 | 3
4 | 贴片陶瓷电容 | C29,C40,C41,C44 | MLCC,22uF,±20%,16V,X5R,C1206 | 22uF/16V | CL31A226MO | Samsung | C1206 | 4
5 | 直插单排针 | DEBUGPORT1 | 2.54mm 10pin 直插单排针 | CON10_NL |  |  | HEAD10-100 | 1
6 | 肖特基二极管 | D3,D5 | 肖特基二极管 | SS34_NL | SS34 | FAIRCHILD | D3224-105 | 2
7 | ESD Pattern | E1,E2 | ESD Pattern | ESD Pattern |  |  | ESD | 2
8 | 自恢复保险丝 | F1 | 1206 自恢复保险丝 | 200mA_NL | MF-NSMF020-2 | BOURNS | F1206 | 1
9 | 直插单排针 | JTAG1 | 2.54mm 6pin 直插单排针 | head6-100_NL |  |  | head6-100 | 1
10 | 直插单排针 | LCD1 | 2.54mm 4pin 直插单排针 | CON4_NL |  |  | head4-100 | 1
11 | 贴片电阻 | R2,R3 | 贴片电阻 | NC |  |  | R0402 | 2
12 | 贴片电阻 | R20 | 贴片电阻 | 0R/NL |  |  | R1206 | 1
13 | 贴片电阻 | R40,R41 | 贴片电阻 | 820R_NL |  |  | R0402 | 2
14 | 贴片按键 | SW1 | 2 Pin 按钮,4.3mm | KEY_NL | DTSM-31N | 圆达实业 | sw2-0635-x-v | 1
