EHash/Open-Hardware-Canaan-A851-A3210M/A851_FC/V1_1/BOM/FC7_V1.1_BOM.xls

FC7_BOM_V1.1
Notes:
元器件总数3种
序号 | 类型 | 位号 | 描述 | 值 | 厂家编号 | 厂家 | 封装 | 数量 | 备注
1 | 风扇插头 | FAN_OUT | 4pin插头直插安装 | A2543UV0-4P-DL | A2543WV0-4P-DL(1) |  | FAN | 1
2 | 风扇插座 | FAN_IN | 4pin插座，插头直插安装 | CI224P1VK0 | CI224P1VK0(2) | CviLux | XH-4AW | 1
