EHash/Open-Hardware-Canaan-A851-A3210M/A851_PMU/ISL8120/BOM/Left_board/PMU851_ISL8120_L_V1.0.4_BOM.xls

PMU851_ISL8120_L_V1.0.4_BOM
Notes;
1) 电阻默认5%精度
2) 小于100nF的电容默认是25V/50V, COG/X7R类型; 大于100nF的电容默认是6.3V, X7R/X5R类型
序号 | 类型 | 位号 | 描述 | 值 | 厂家编号 | 厂家 | 封装 | 数量 | 备注
1 | 直插固态电容 | C1,C2,C4,C15,C16,C34,C35,C40,C41,C42,C53,C54,C72,C73 | Solid Cap,270uF,±20%,16V,ESR:10mΩ,8x8MM | 270uF/16V | ORZ271M1CCC0808-JC | Lelon | ce-138-315-315 | 14
2 | 陶瓷电容 | C8,C10,C11,C17,C20,C28,C29,C31,C36,C37,C46,C47,C48,C55,C56,C67,C68,C69,C74,C75,C207 | MLCC,22uF,±20%,16V,X5R,C1206 | 22uF/16V | CL31A226MO | Samsung | C1206 | 21
3 | 陶瓷电容 | C12,C33,C50,C71 | MLCC,470nF,±10%,16V,X5R,C0402 | 470nF/16V | CL05A474KO | Samsung | C0402 | 4
4 | 陶瓷电容 | C13,C51,C78 | MLCC,2.2uF,±20%,10V,X5R,C0603 | 2.2uF/10V | CL10A225MP | Samsung | C0603 | 3
5 | 陶瓷电容 | C14,C52,C88,C94,C96 | MLCC,10uF,±20%,10V,X5R,C0603 | 10uF/10V | CL10A106MP | Samsung | C0603 | 5
6 | 陶瓷电容 | C19,C59 | MLCC,10nF,±10%,16V,X7R,C0402 | 10nF/16V | CL05B103KO | Samsung | C0402 | 2
7 | 陶瓷电容 | C21,C57 | MLCC,4.7uF,±20%,16V,X5R,C0603 | 4.7uF/16V | CL10A475MO | Samsung | C0603 | 2
8 | 陶瓷电容 | C22,C25,C60,C63 | MLCC,1nF,±10%,50V,X7R,C0402 | 1nF/50V | CL05B102KB | Samsung | C0402 | 4
9 | 陶瓷电容 | C23,C61 | MLCC,150pF,±5%,50V,C0G,C0402 | 150pF/50V | CL05C151JB | Samsung | C0402 | 2
10 | 陶瓷电容 | C24,C62 | MLCC,2.2nF,±5%,50V,X7R,C0402 | 2.2nF/50V | CL05B222JB | Samsung | C0402 | 2
11 | 陶瓷电容 | C26,C64 | MLCC,15nF,±10%,50V,X7R,C0603 | 15nF/25V | CL10B153KA | Samsung | C0603 | 2
12 | 陶瓷电容 | C27,C65,C205 | MLCC,100pF,±5%,50V,C0G,C0402 | 100pF/50V | CL05C101JB | Samsung | C0402 | 3
13 | 陶瓷电容 | C32,C70,C77,C79,C80,C81,C82,C83,C84,C85,C86 | MLCC,100nF,±10%,25V,X5R,C0402 | 100nF/25V | CL05A104KA | Samsung | C0402 | 11
14 | 陶瓷电容 | C93,C95 | MLCC,1uF,±20%,25V,X5R,C0603 | 1uF/25V | CL10A105MA | Samsung | C0603 | 2
15 | 直插铝电解电容 | C208 | Aluminum Electrolytic Cap,100uF,±20%,25V,ESR:400mΩ,6.3x11MM | 100uF/25V | 25YXF100MEFC6.3x11 | Rubycon | DCC-98-248-236 | 1
16 | 贴片发光二极管 | D1,D2 | LED with bi-Color,RED&GREEN双色LED | LTST-S326KGJRKT | LTST-S326KGJRKT | LITEON | LED_S326KGJRKT_P03 | 2
17 | 肖特基二极管 | D28,D29,D30 | Schottky Diodes,VR:20V,IF:1A,PD:200mW,SOD-323 | NSR1020MW2 | NSR1020MW2 | ON | SOD323-2-43S | 3
18 | PCIe电源插座 | J1,J2,J3,J4 | 6Pin PCIe电源插座 | HDR3x2 | CP-01406150 | CvLux | HDR_3x2_P | 4
19 | 双排双塑直插针 | J5,J6 | 插针,2.0mm，双排双塑2X7 | CON14A |  |  | head2x7-79b | 2
20 | 双排弯角插座 | J7 | 90度插座,2.0mm，双排2X16 | CON_2X16 |  |  | head2x16-79b | 1
21 | 线圈电感 | L1,L2,L3,L4 | Inductor,0.68±20%uH,1.6±7%mΩ,Isat:33A,11.15x10x3.8mm | PIME104T-R68MS1R607 | PIME104T-R68MS1R607 | Cyntec | ind_10x10_4 | 4
22 | 贴片电感 | L6 | Inductor,33uH±20%,DCRmax:244mΩ,Isat:1.5A,5x5x4.0mm | SWPA5040S330MT | SWPA5040S330MT | Sunlord | PL0505-045 | 1
23 | 贴片MOS管 | Q3,Q6,Q9,Q12 | Power N MOS,VDS:30V,ID:60A,RDS:1.7mΩ,VSON-CLIP | NTMFS4C022NT1G | NTMFS4C022NT1G | ON | SOT669_TOSHIBA | 4
24 | 贴片MOS管 | Q1,Q2,Q4,Q5,Q7,Q8,Q10,Q11 | Power N MOS,VDS:30V,ID:30A,RDS:2.4mΩ,VSON-CLIP | CSD17576Q5B | CSD17576Q5B | TI | SON-CSD16321Q5-39 | 8
25 | 贴片MOS管 | Q13,Q14 | N MOS,VDS:30V,ID:560mA,RDS:1Ω@4.0V,SOT23 | NTR4003NT1G | NTR4003NT1G | ON | SOT23-3-43 | 2
26 | 贴片热敏电阻 | RT1,RT2 | NTC Resistor,10KΩ,±5%,B=3500,R0603 | CMFA103J3500HANT | CMFA103J3500HANT | 风华 | R0603 | 2
27 | 贴片电阻 | R1,R26 | Resistor,2.2Ω,±5%,1/10W,R0603 | 2.2R | RC1608J2R2CS | Samsung | R0603 | 2
28 | 贴片电阻 | R2,R6,R27,R30,R87,R88,R89,R92,R93,R94 | Resistor,0Ω,±5%,1/16W,R0402 | 0R | RC1005J000CS | Samsung | R0402 | 10
29 | 贴片电阻 | R3,R23,R28,R48 | Resistor,732Ω,±1%,1/16W,R0402 | 732R/1% | RC1005F7320CS | Samsung | R0402 | 4
30 | 贴片电阻 | R5,R31 | Resistor,15KΩ,±1%,1/16W,R0402 | 15K/1% | RC1005F153CS | Samsung | R0402 | 2
31 | 贴片电阻 | R7,R25,R33,R50 | Resistor,2KΩ,±5%,1/16W,R0402 | 2K | RC1005J202CS | Samsung | R0402 | 4
32 | 贴片电阻 | R8,R10,R19,R21,R34,R35,R44,R46 | Resistor,0Ω,±5%,1/10W,R0603 | 0R | RC1608J000CS | Samsung | R0603 | 8
33 | 贴片电阻 | R9,R32 | Resistor,5.23KΩ,±1%,1/16W,R0402 | 5.23K/1% | RC1005F5231CS | Samsung | R0402 | 2
34 | 贴片电阻 | R12,R37 | Resistor,10KΩ,±1%,1/16W,R0402 | 10K/1% | RC1005F103CS | Samsung | R0402 | 2
35 | 贴片电阻 | R14,R39 | Resistor,45.3Ω,±1%,1/16W,R0402 | 45.3R/1% | RC1005F45R3CS | Samsung | R0402 | 2
36 | 贴片电阻 | R15,R40 | Resistor,1KΩ,±1%,1/16W,R0402 | 1K/1% | RC1005F102CS | Samsung | R0402 | 2
37 | 贴片电阻 | R16,R41 | Resistor,1.24KΩ,±1%,1/10W,R0603 | 1.24K/1% | RC1608F1241CS | Samsung | R0603 | 2
38 | 贴片电阻 | R17,R42 | Resistor,82.5Ω,±1%,1/16W,R0402 | 82.5R/1% | RC1005F82R5CS | Samsung | R0402 | 2
39 | 贴片电阻 | R18,R81 | Resistor,187KΩ,±1%,1/16W,R0402 | 187K/1% | RC1005F1873CS | Samsung | R0402 | 2
40 | 贴片电阻 | R24,R49,R67,R68 | Resistor,10KΩ,±5%,1/16W,R0402 | 10K | RC1005J103CS | Samsung | R0402 | 4
41 | 贴片电阻 | R11,R13,R36,R38 | Resistor,13.7KΩ,±1%,1/16W,R0402 | 13.7K/1% | RC1005F1372CS | Samsung | R0402 | 4
42 | 贴片电阻 | R51,R52 | Resistor,4.7KΩ,±5%,1/16W,R0402 | 4.7K | RC1005J472CS | Samsung | R0402 | 2
43 | 贴片电阻 | R53,R54,R55,R56 | Resistor,220Ω,±5%,1/16W,R0402 | 220R | RC1005J221CS | Samsung | R0402 | 4
44 | 贴片电阻 | R57,R58 | Resistor,4.53KΩ,±1%,1/16W,R0402 | 4.53K/1% | RC1005F4531CS | Samsung | R0402 | 2
45 | 贴片电阻 | R61 | Resistor,4.7KΩ,±1%,1/16W,R0402 | 4.7K/1% | RC1005F472CS | Samsung | R0402 | 1
46 | 贴片电阻 | R62 | Resistor,2.8KΩ,±1%,1/16W,R0402 | 2.8K/1% | RC1005F2801CS | Samsung | R0402 | 1
47 | 贴片电阻 | R65,R66 | Resistor,820Ω,±1%,1/16W,R0402 | 820R/1% | RC1005F821CS | Samsung | R0402 | 2
48 | 贴片电阻 | R69,R73,R74 | Resistor,20KΩ,±1%,1/16W,R0402 | 20K/1% | RC1005F203CS | Samsung | R0402 | 3
49 | 贴片电阻 | R70 | Resistor,5.62KΩ,±1%,1/16W,R0402 | 5.62K/1% | RC1005F5621CS | Samsung | R0402 | 1
50 | 贴片电阻 | R71,R72 | Resistor,52.3KΩ,±1%,1/16W,R0402 | 52.3K/1% | RC1005F5232CS | Samsung | R0402 | 2
51 | 贴片电阻 | R75,R76 | Resistor,47KΩ,±5%,1/16W,R0402 | 47K | RC1005J473CS | Samsung | R0402 | 2
52 | 贴片电阻 | R198 | Resistor,180Ω,±5%,1/16W,R0402 | 180R | RC1005J181CS | Samsung | R0402 | 1
53 | 贴片电阻 | R201 | Resistor,0.33Ω,±5%,1/3W,R1206 | 0.33R | RUT3216JR330CS | Samsung | R1206 | 1
54 | 贴片电阻 | R203 | Resistor,75KΩ,±1%,1/16W,R0402 | 75K/1% | RC1005F753CS | Samsung | R0402 | 1
55 | 贴片电阻 | R204 | Resistor,6.65KΩ,±1%,1/16W,R0402 | 6.65K/1% | RC1005F6651CS | Samsung | R0402 | 1
56 | 瞬间稳态二极管 | TVS1 | TVS,Uni-Directional,VRWM:16V,VC:26V,IPPM:57.7A,SMC | SMCJ16A | SMCJ16A | Diodes | D3224-105 | 1
57 | 瞬间稳态二极管 | TVS5,TVS8 | TVS,Uni-Directional,VRWM:5V,VC:9.2V,IPPM:43.5A,SMA | SMAJ5.0A | SMAJ5.0A | Diodes | D2010-89 | 2
58 | 集成电路 | U1,U2 | Dual/n-Phase Buck PWM Controller with Integrated | ISL8120IRZ-TR5779 | ISL8120IRZ-TR5779 | intersil | QFN32-050-0505-010-N | 2
59 | 集成电路 | U3 | Dual-Channel, I2C Adjustable,Sink/Source Current DAC, 8 uSOP | DS4412U+ | DS4412U+ | MAXIM | SOP8-26-120-43 | 1
60 | 集成电路 | U4 | LDO,Vin: 24V,Iout 150mA,Vdrop:100mV,SOT23-5 | AP2204K-ADJTRG1 | AP2204K-ADJTRG1 | BCD Semiconductor Manufacturing Limited | SOT25-5-57 | 1
61 | 集成电路 | U7 | MCU, 32-bit M0+,32KB Flash,8KB SRAM,QFN32 | LPC824M201JHI33 | LPC824M201JHI33 | NXP | QFN32-050-0505-010-N | 1
62 | 集成电路 | U9,U10 | LDO,Vin: 20V,Vout: 2.5V,Iout 1A,Vdrop: 1.2V,SOT-223 | NCP1117ST25T3G | NCP1117ST25T3G | ON | SOT223-4-71 | 2
63 | 集成电路 | U15 | Boost/Buck DCDC,Vin:40V,Iout:1.5A,100KHz, | MC34063AD | MC34063AD | MOTOROLA/ON Semi | SO-8 | 1
以下物料不焊接
1 |  | C18,C38,C58,C76 |  | 4.7nF/50V/NL |  |  | C0603 | 4
2 | 贴片电阻 | R4,R22,R29 |  | 1R/NL |  |  | R0603 | 3
3 | 贴片电阻 | R20 |  | 0R/NL |  |  | R0402 | 1
4 | 贴片电阻 | R47 |  | 1R/NL |  | Samsung | R0603 | 1
5 | 贴片电阻 | R63,R64,R77,R78,R205,R206,R207,R208 | Resister | 10K/NL |  | Samsung | R0402 | 8
6 | 贴片电阻 | R79,R80 |  | 0R/NL |  | Samsung | R0402 | 2
7 | 陶瓷电容 | C5,C6,C7,C9,C30,C43,C44,C45,C49,C66 | MLCC,22uF,±20%,16V,X5R,C1206 | 22uF/16V | CL31A226MO | Samsung | C1206 | 10
