EHash/Open-Hardware-Canaan-A851-A3210M/A851_mechanical/Structural drawing/bah0102v2_0/bah0102v2_0_asm.stp

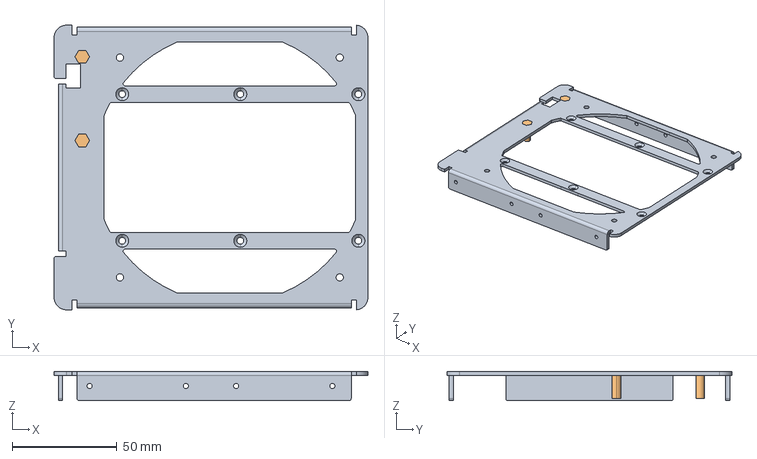
[picture p14: CAD file, 2019-05-07]
A851_mechanical/Structural drawing/bah0102v2_0/bah0102v2_0_asm.stp
150.0 x 136.0 x 14.0 mm
BAH0102V2_0
CSS_M3X13 x 2
