EHash/Open-Hardware-Canaan-A851-A3210M/A851_mechanical/Structural drawing/bah0103v2_0/bah0103v2_0.stp

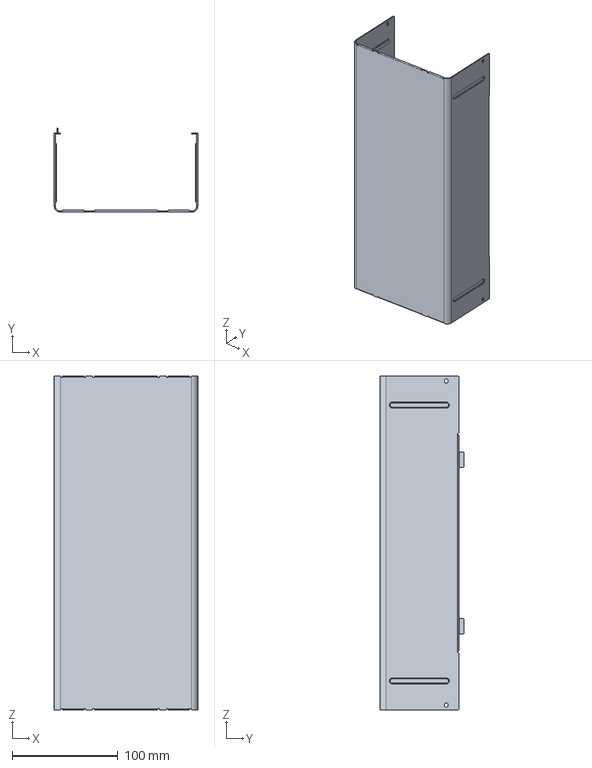
[picture p16: CAD file, 2019-05-07]
A851_mechanical/Structural drawing/bah0103v2_0/bah0103v2_0.stp
136.0 x 80.0 x 316.4 mm
