EHash/Open-Hardware-Canaan-A851-A3210M/A851_mechanical/Structural drawing/bah0104v1_1/bah0104v1_1.stp

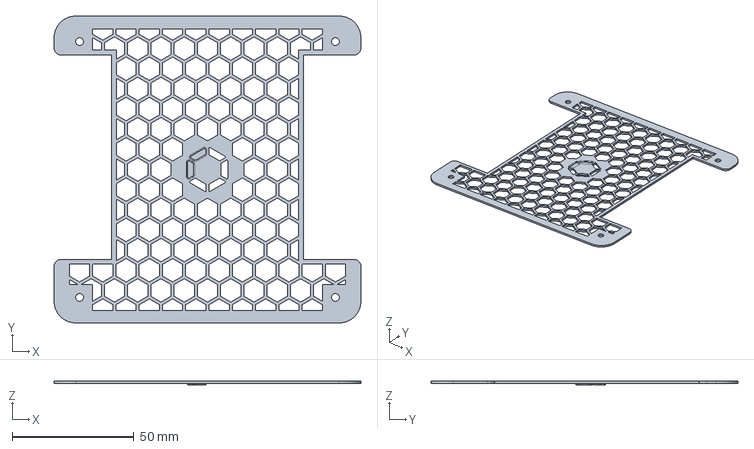
[picture p17: CAD file, 2019-05-07]
A851_mechanical/Structural drawing/bah0104v1_1/bah0104v1_1.stp
126.0 x 126.0 x 1.50 mm
