EHash/Open-Hardware-Canaan-A851-A3210M/A851_mechanical/Structural drawing/bah0104v2_0/bah0104v2_0.stp

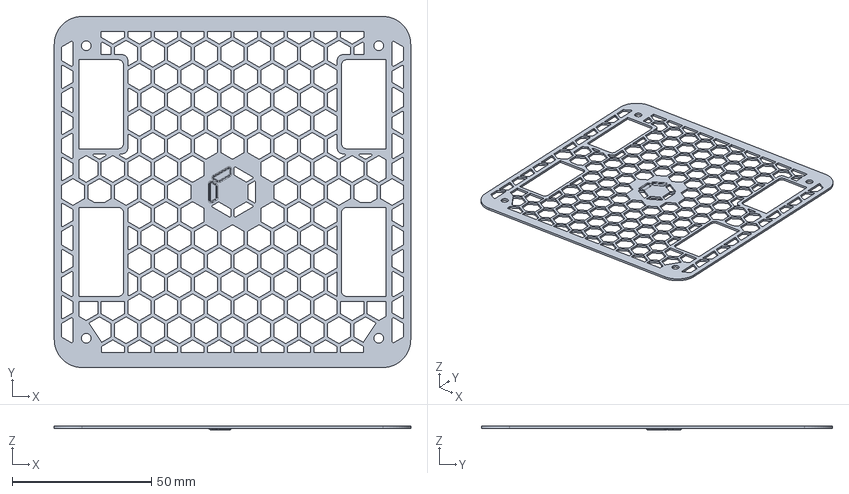
[picture p18: CAD file, 2019-05-07]
A851_mechanical/Structural drawing/bah0104v2_0/bah0104v2_0.stp
128.0 x 126.0 x 1.50 mm
