EHash/Open-Hardware-Canaan-A851-A3210M/A851_mechanical/Structural drawing/bah0202v3_1/bah0202v3_1.stp

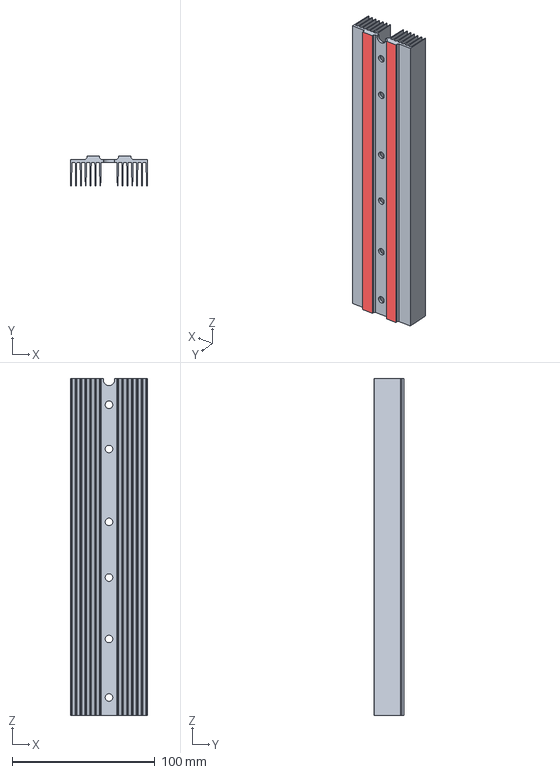
[picture p19: CAD file, 2019-05-07]
A851_mechanical/Structural drawing/bah0202v3_1/bah0202v3_1.stp
54.0 x 21.2 x 236.0 mm
