EHash/Open-Hardware-Canaan-A851-A3210M/A851_mechanical/Structural drawing/bah0203v1_0/bah0203v1_0.stp

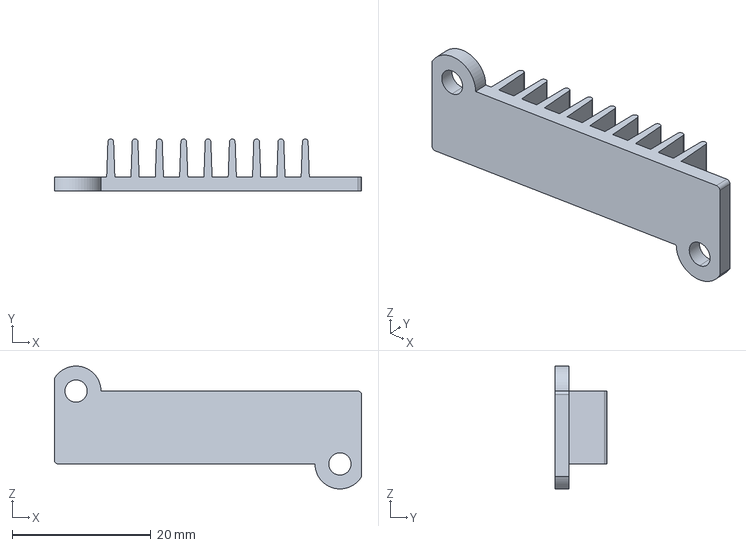
[picture p20: CAD file, 2019-05-07]
A851_mechanical/Structural drawing/bah0203v1_0/bah0203v1_0.stp
44.2 x 7.50 x 17.7 mm
