EHash/Open-Hardware-Canaan-A851-A3210M/A851_mechanical/Structural drawing/bah0301v1_0/bah0301v1_0.stp

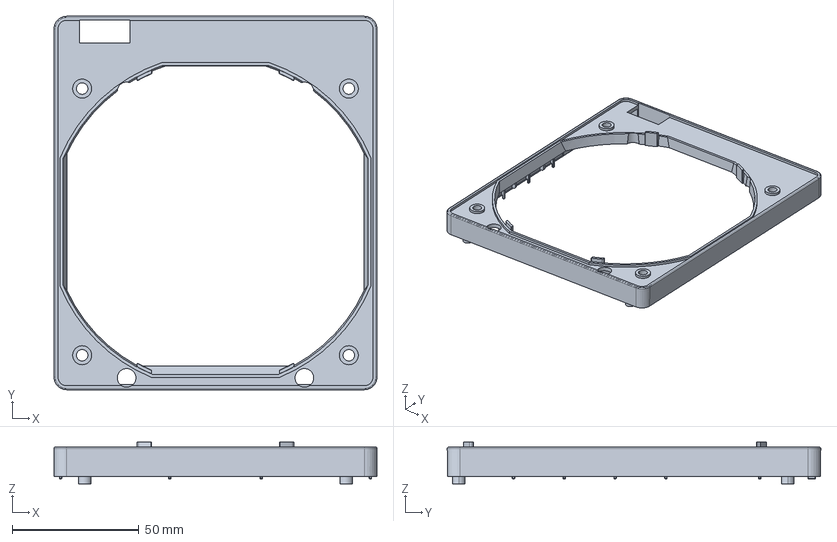
[picture p21: CAD file, 2019-05-07]
A851_mechanical/Structural drawing/bah0301v1_0/bah0301v1_0.stp
127.2 x 147.1 x 16.5 mm
