EHash/Open-Hardware-Canaan-A851-A3210M/A851_mechanical/Structural drawing/bah0302v1_0/bah0302v1_0.stp

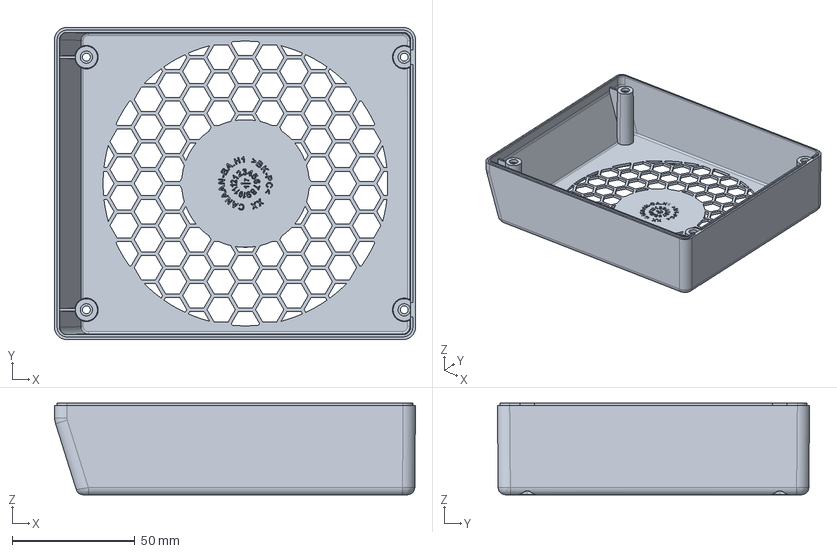
[picture p22: CAD file, 2019-05-07]
A851_mechanical/Structural drawing/bah0302v1_0/bah0302v1_0.stp
147.1 x 127.2 x 37.3 mm
