EHash/Open-Hardware-Canaan-A851-A3210M/A851_mechanical/Structural drawing/bah0303v1_0/bah0303v1_0.stp

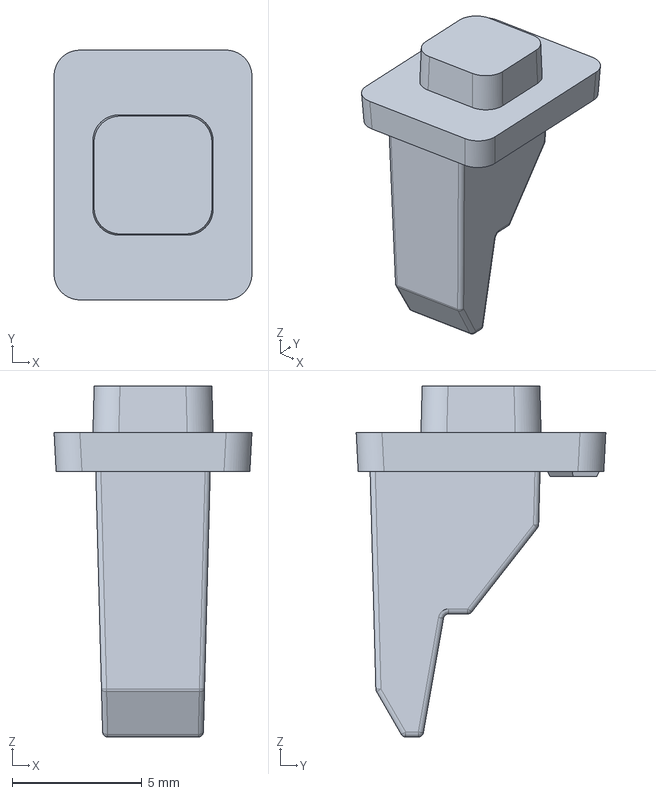
[picture p23: CAD file, 2019-05-07]
A851_mechanical/Structural drawing/bah0303v1_0/bah0303v1_0.stp
7.64 x 9.64 x 13.6 mm
