EHash/Open-Hardware-Canaan-A851-A3210M/A851_mechanical/Structural drawing/BO131001131V1_0/bo131001131v1_0.stp

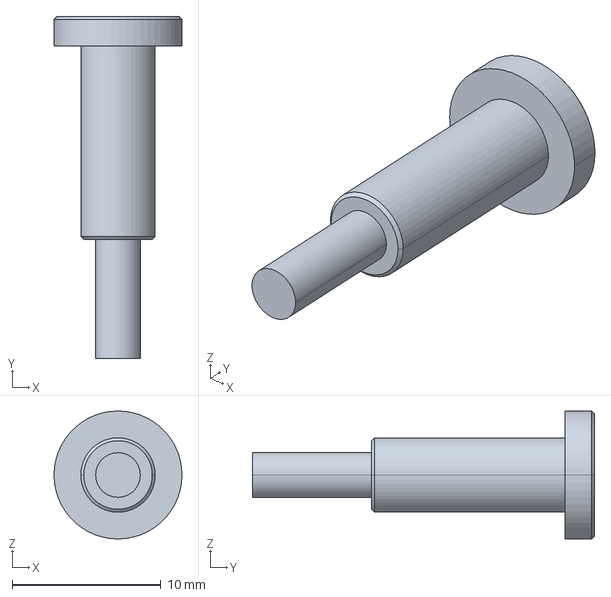
[picture p25: CAD file, 2019-05-07]
A851_mechanical/Structural drawing/BO131001131V1_0/bo131001131v1_0.stp
8.60 x 23.0 x 8.60 mm
