EHash/Open-Hardware-Canaan-A851-A3210M/A851_mechanical/Structural drawing/BO131001132V1_0/bo131001132v1_0.stp

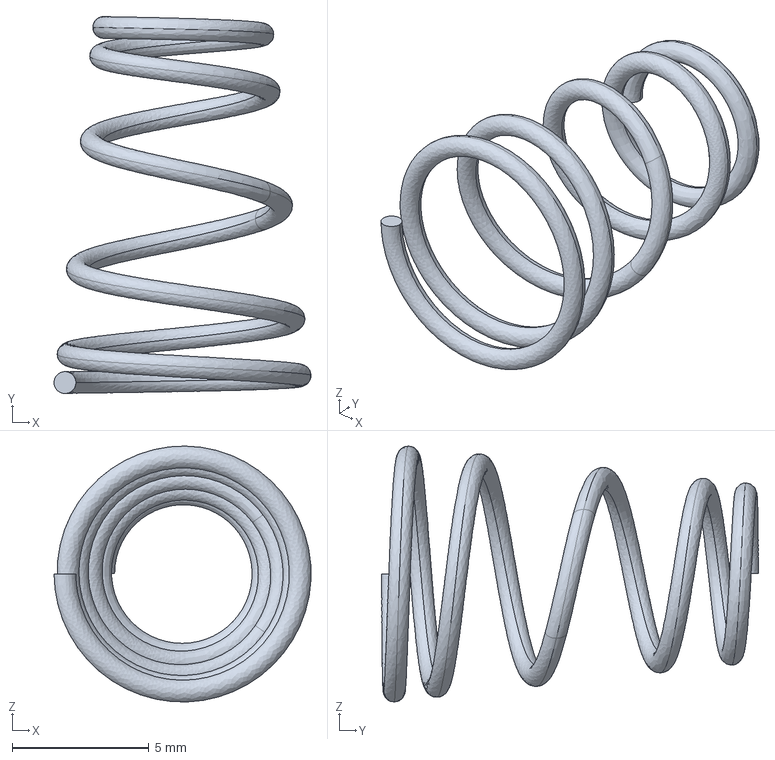
[picture p26: CAD file, 2019-05-07]
A851_mechanical/Structural drawing/BO131001132V1_0/bo131001132v1_0.stp
9.41 x 13.8 x 9.37 mm
