EHash/Open-Hardware-Canaan-A851-A3210M/A851_mechanical/Structural drawing/bah0601v1_0/BAH0601V1_0.pdf

# Unit : mm

260士5

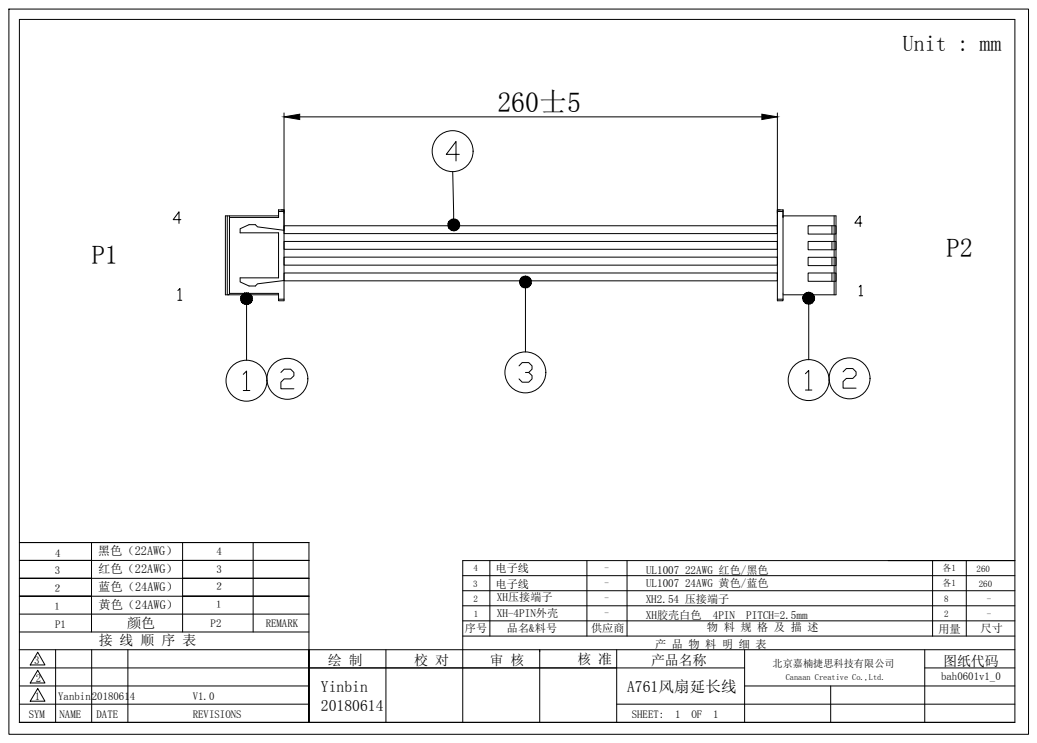
[picture p27: page 1]
电子线; UL1007 22AWG 红色/黑色; UL1007 24AWG 黄色/蓝色; 供应商; 蓝色（24AWG）; 红色（22AWG）; 黑色（22AWG）

2 | XH压接端子 | - | XH2.54 压接端子 | 8 | -
1 | | - | XH胶壳白色　4PIN PITCH=2.5mm | 2 | -

黄色（24AWG） | １ | | XH-4PIN外壳 １
P1 | 颜色 | P2 | REMARK

3 | | | | 绘 制 | 校 对 | 审 核 | 核 准 | 产品名称 | 北京嘉楠捷思科技有限公司 Canaan Creative Co.,Ltd. | 图纸代码
2 | | | | Yinbin 20180614 | | | | A761风扇延长线 | | bah0601v1_0
1 | Yanbin20180614 | | V1.0
SYM | NAME | DATE | REVISIONS | | | | | SHEET: 1 OF 1
