EHash/Open-Hardware-Canaan-A851-A3210M/A851_HASH/SCH/hash8-X26_V1.0.pdf

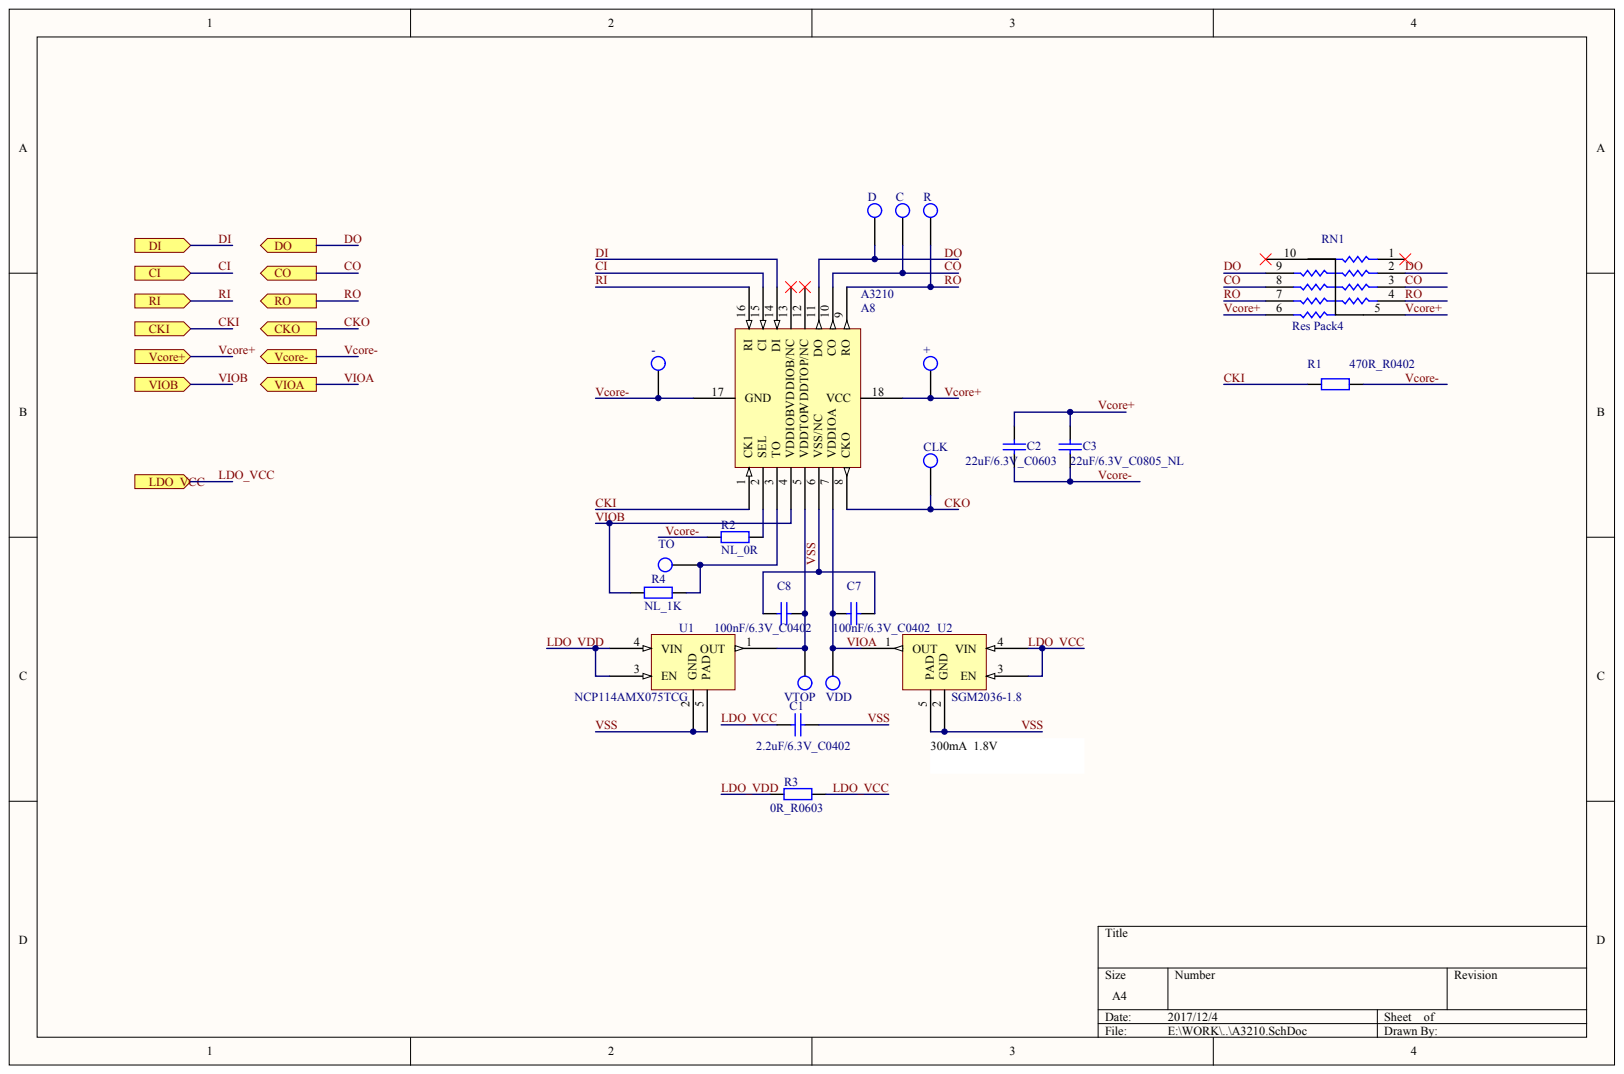
[picture p28: page 1]

CKO 8 RO 9 CO 10 DO 11 VDDTOP/NC 12 VDDIOB/NC 13 DI 14 CI 15 RI 16 GND 17 VCC 18

VIOB

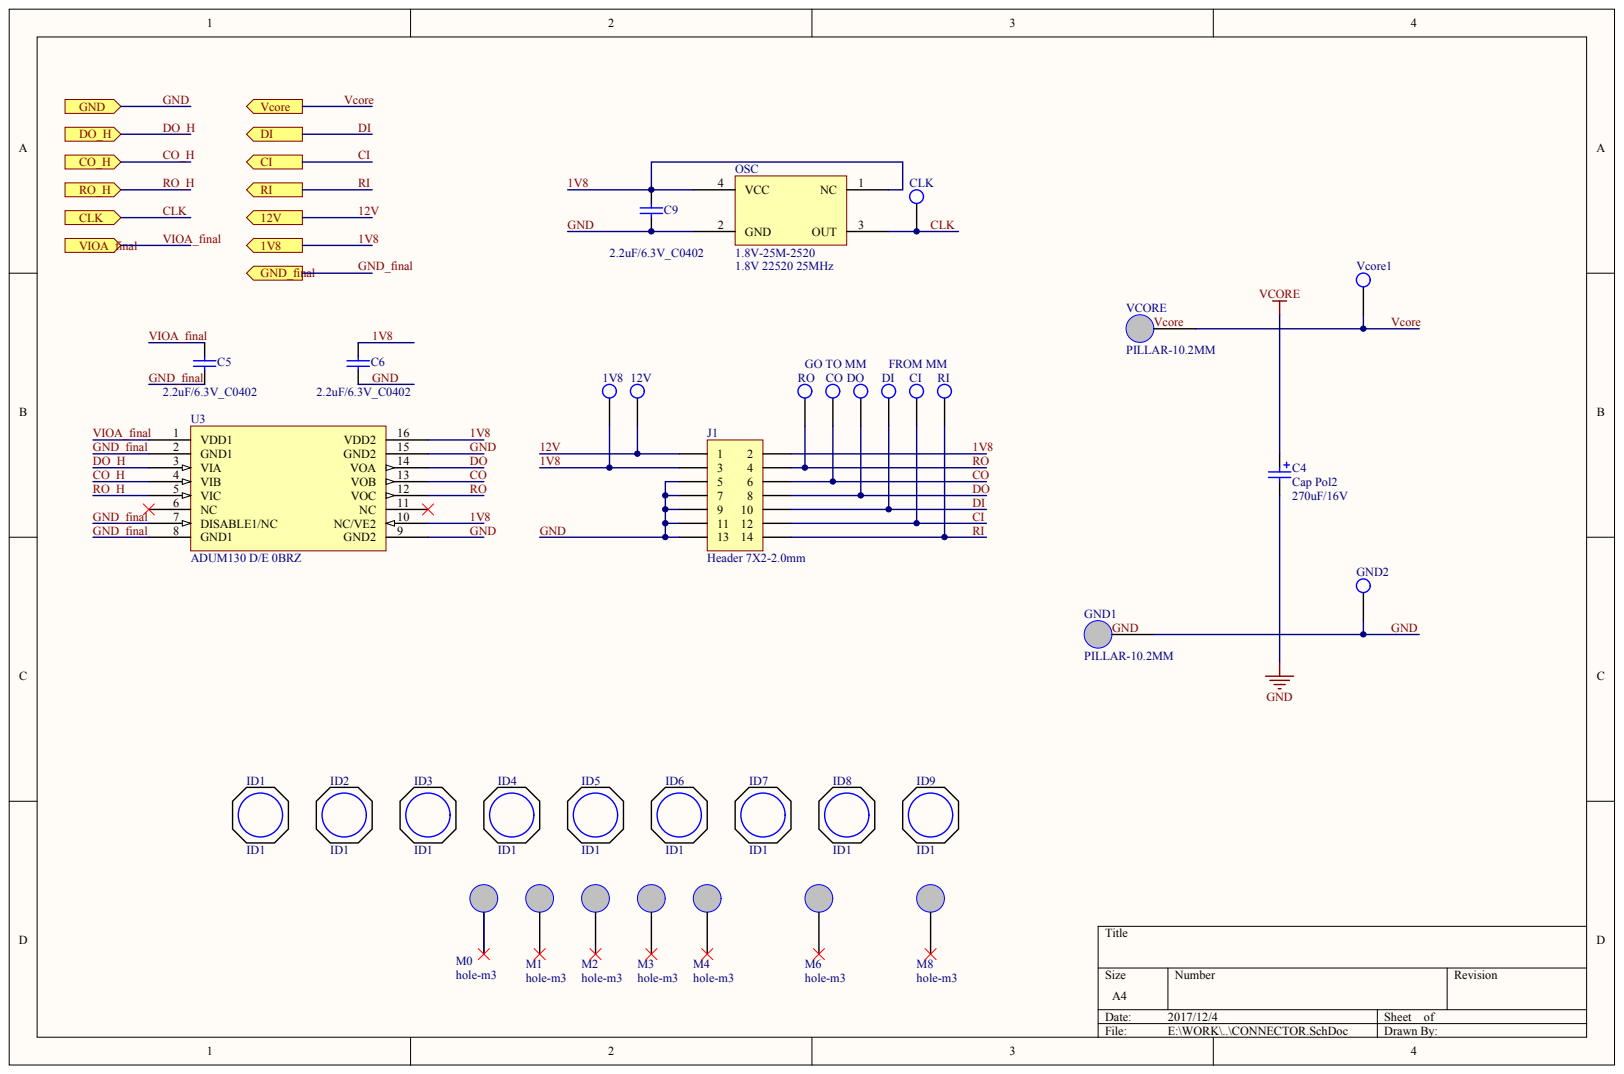
[picture p29: page 2]

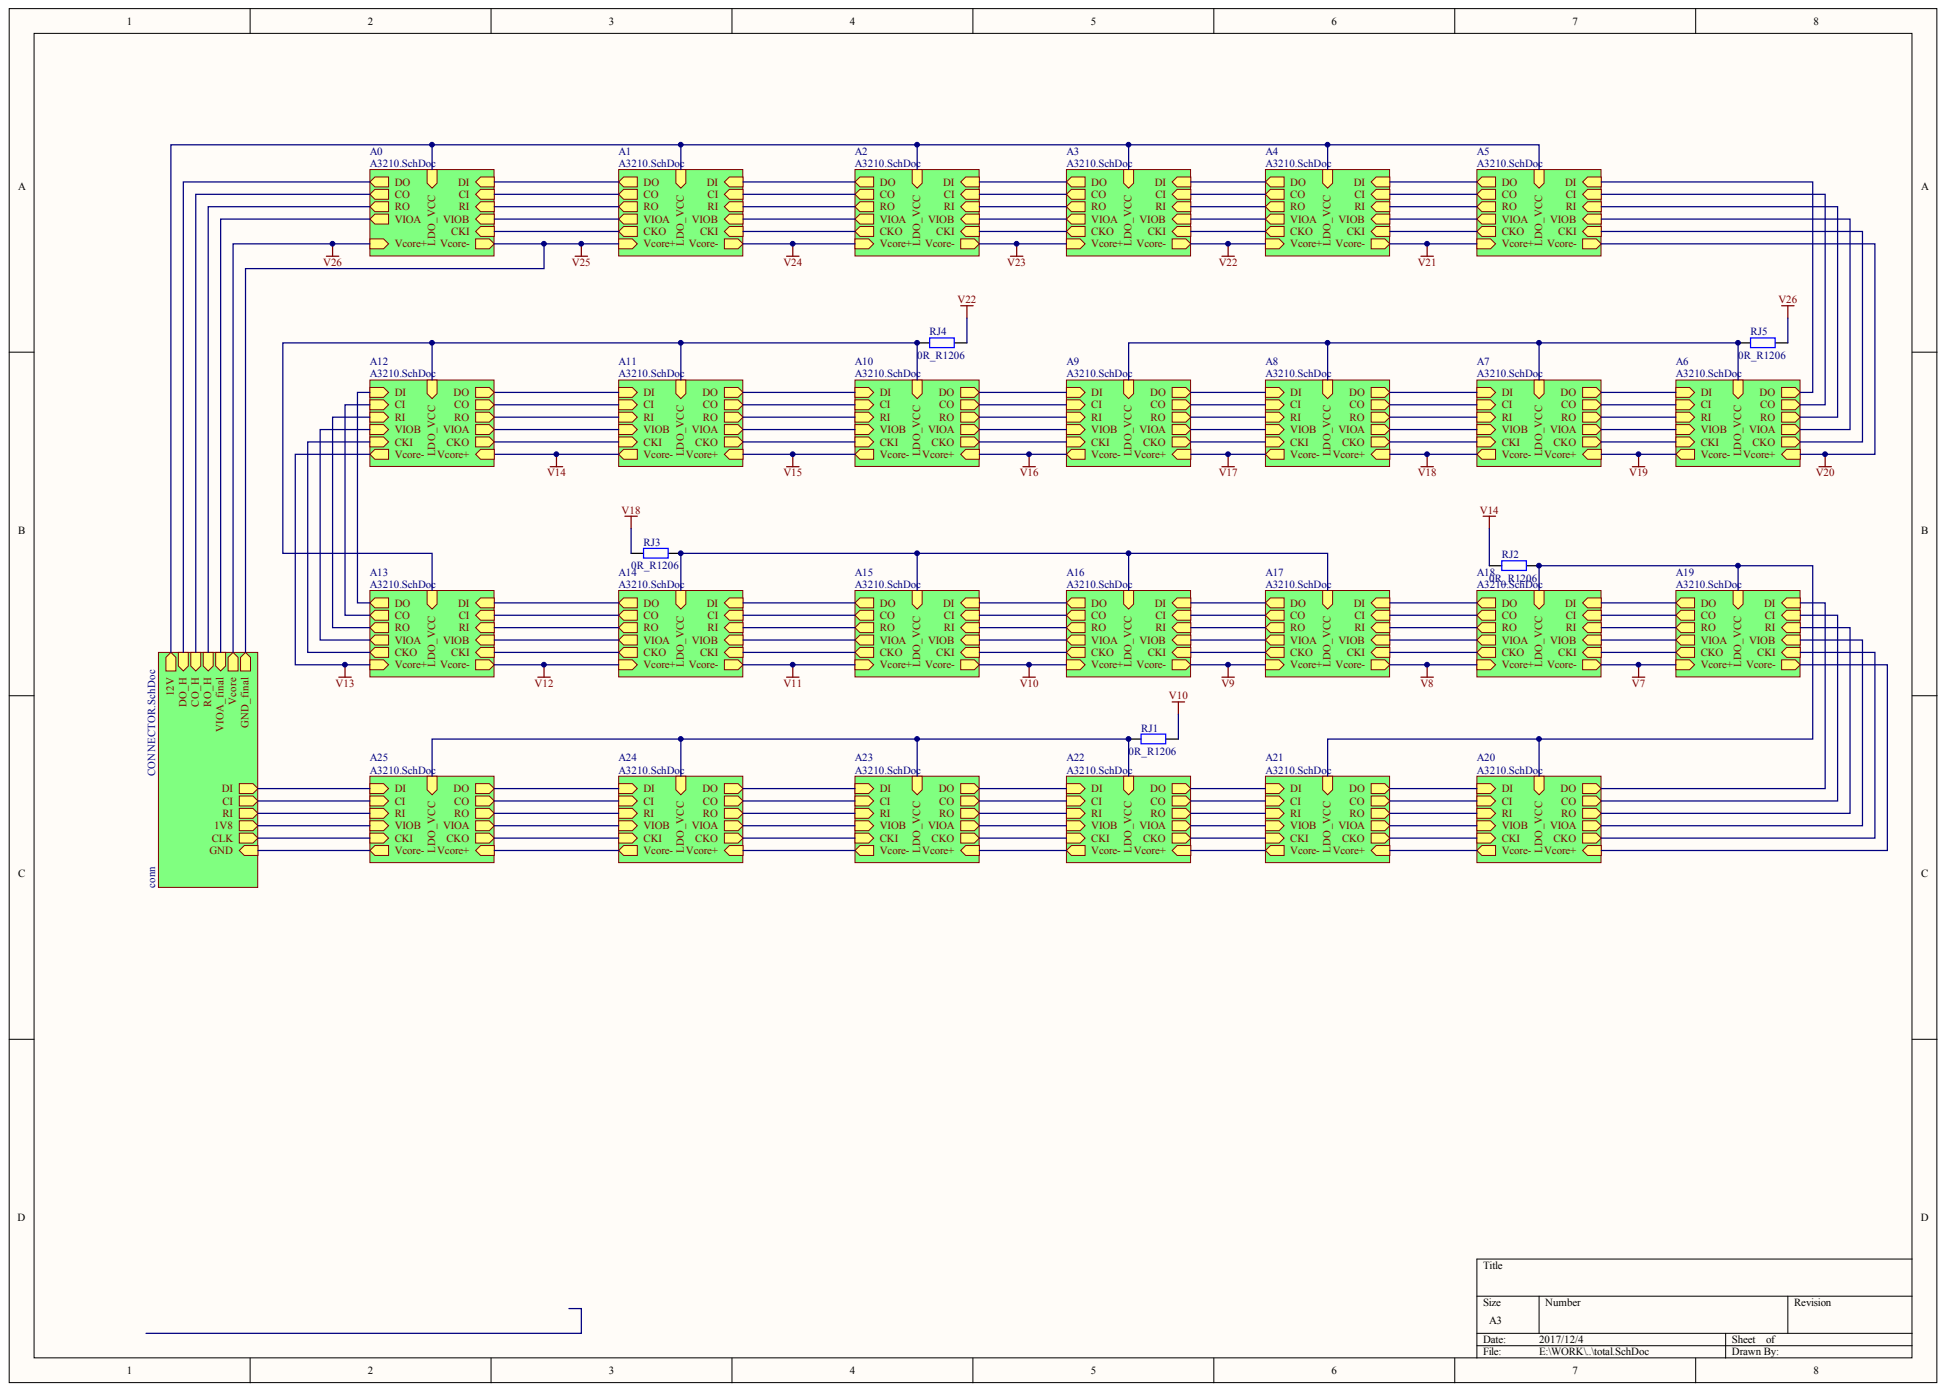
[picture p30: page 3]

A0 A3210.SchDoc | A1 A3210.SchDoc | A2 A3210.SchDoc | A3 A3210.SchDoc | A4 A3210.SchDoc | A5 A3210.SchDoc

DO CO VIOA RO | DI CI VIOB LDO_VCC RI CKI | | DO DI CO CI VIOA VIOB LDO_VCC RO RI CKO CKI Vcore+ Vcore- | | DO DI CO CI VIOA VIOB LDO_VCC RO RI CKO CKI Vcore+ Vcore- | DO DI CO CI VIOA VIOB LDO_VCC RO RI CKO CKI Vcore+ Vcore- | DO DI CO CI VIOA VIOB LDO_VCC RO RI CKO CKI Vcore+ Vcore- | DO DI CO CI VIOA VIOB LDO_VCC RO RI CKO CKI Vcore+ Vcore-

CI CO
VIOB VIOA LDO_VCC
RI RO

CKI CKO
Vcore-Vcore+

CO CI
VIOA VIOB LDO_VCC
RO RI

CKO CKI

DI CI RI 1V8 CLK GND | | Vcore+ Vcore- | Vcore+ Vcore-
