EHash/Open-Hardware-Canaan-A851-A3210M/A851_MM/SCH/MM851_SCH_V1_0_190311.pdf

1.8V

1.8V

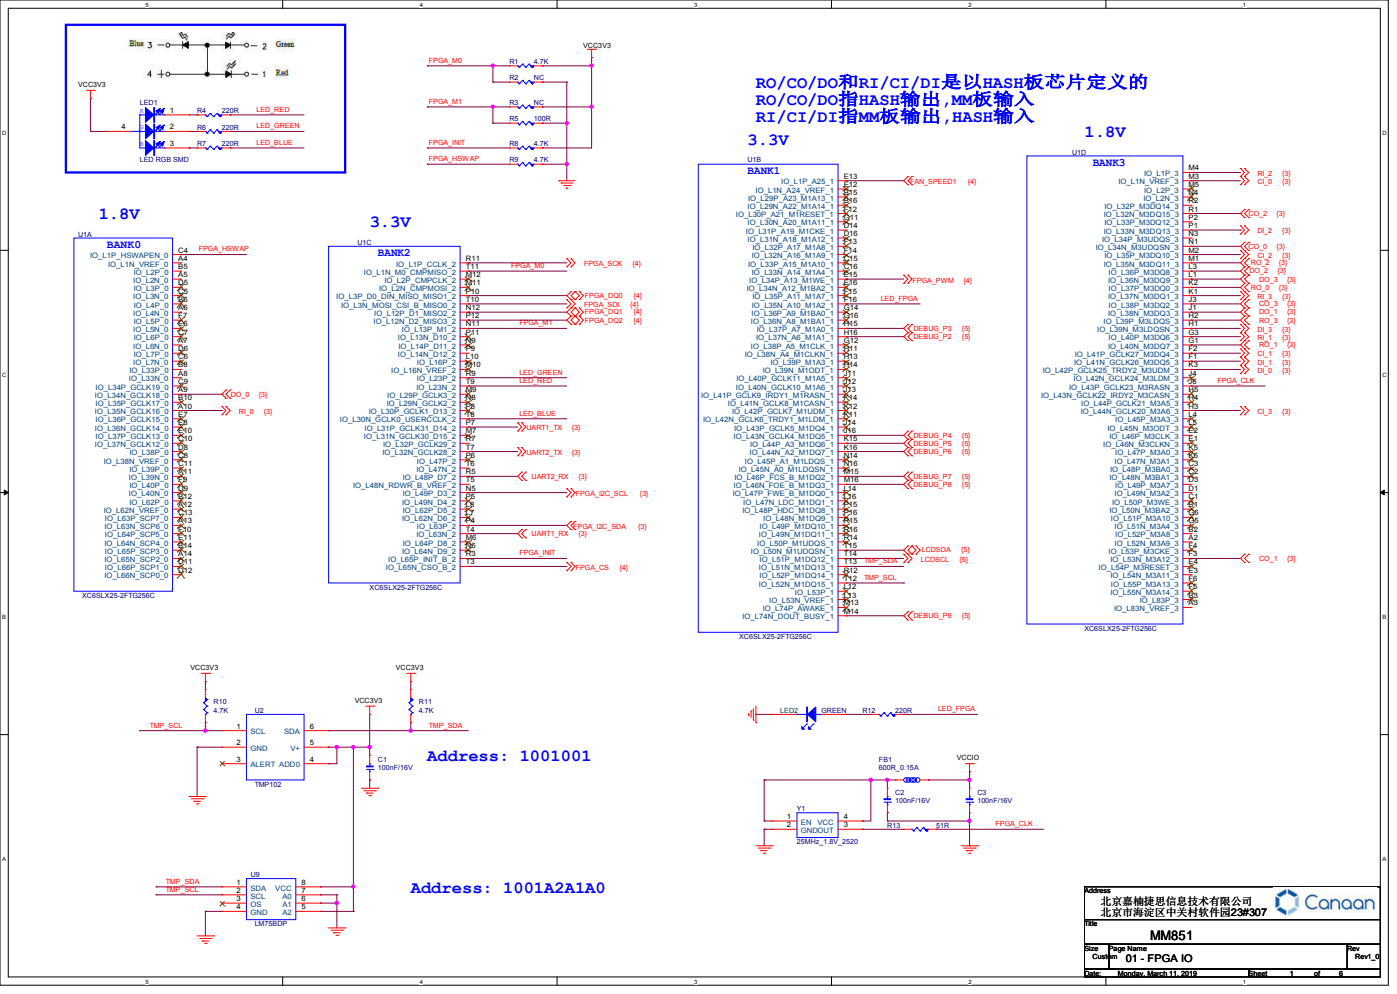
[picture p31: page 1]

RO/CO/DO和RI/CI/DI是以HASH板芯片定义的
RO/CO/DO指HASH输出,MM板输入
RI/CI/DI指MM板输出,HASH输入

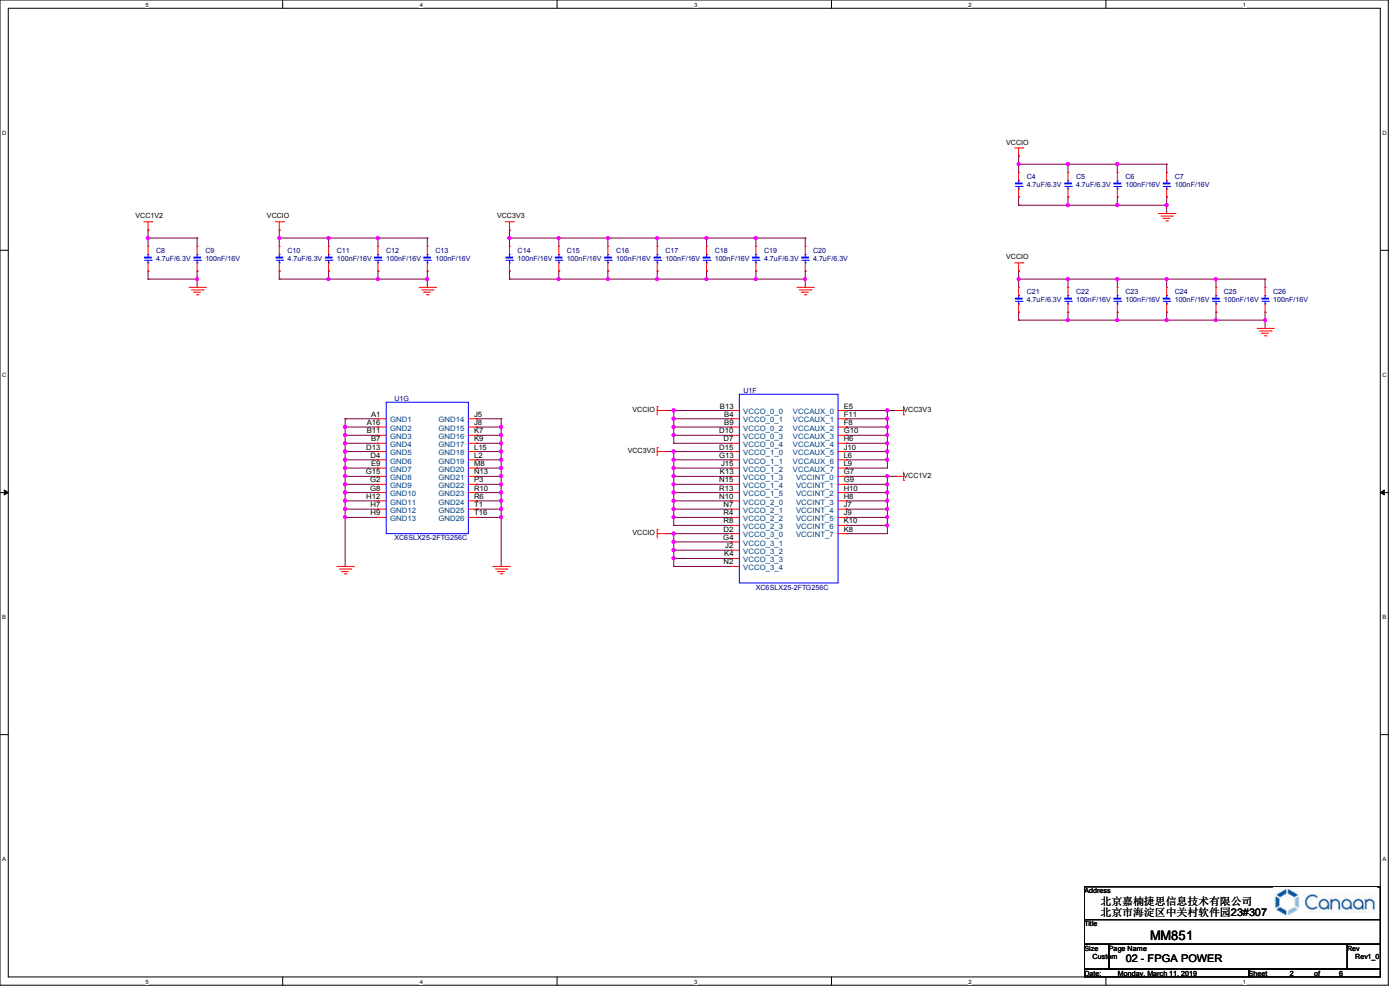
[picture p32: page 2]

# IIC

# IO Header & UART & POWER

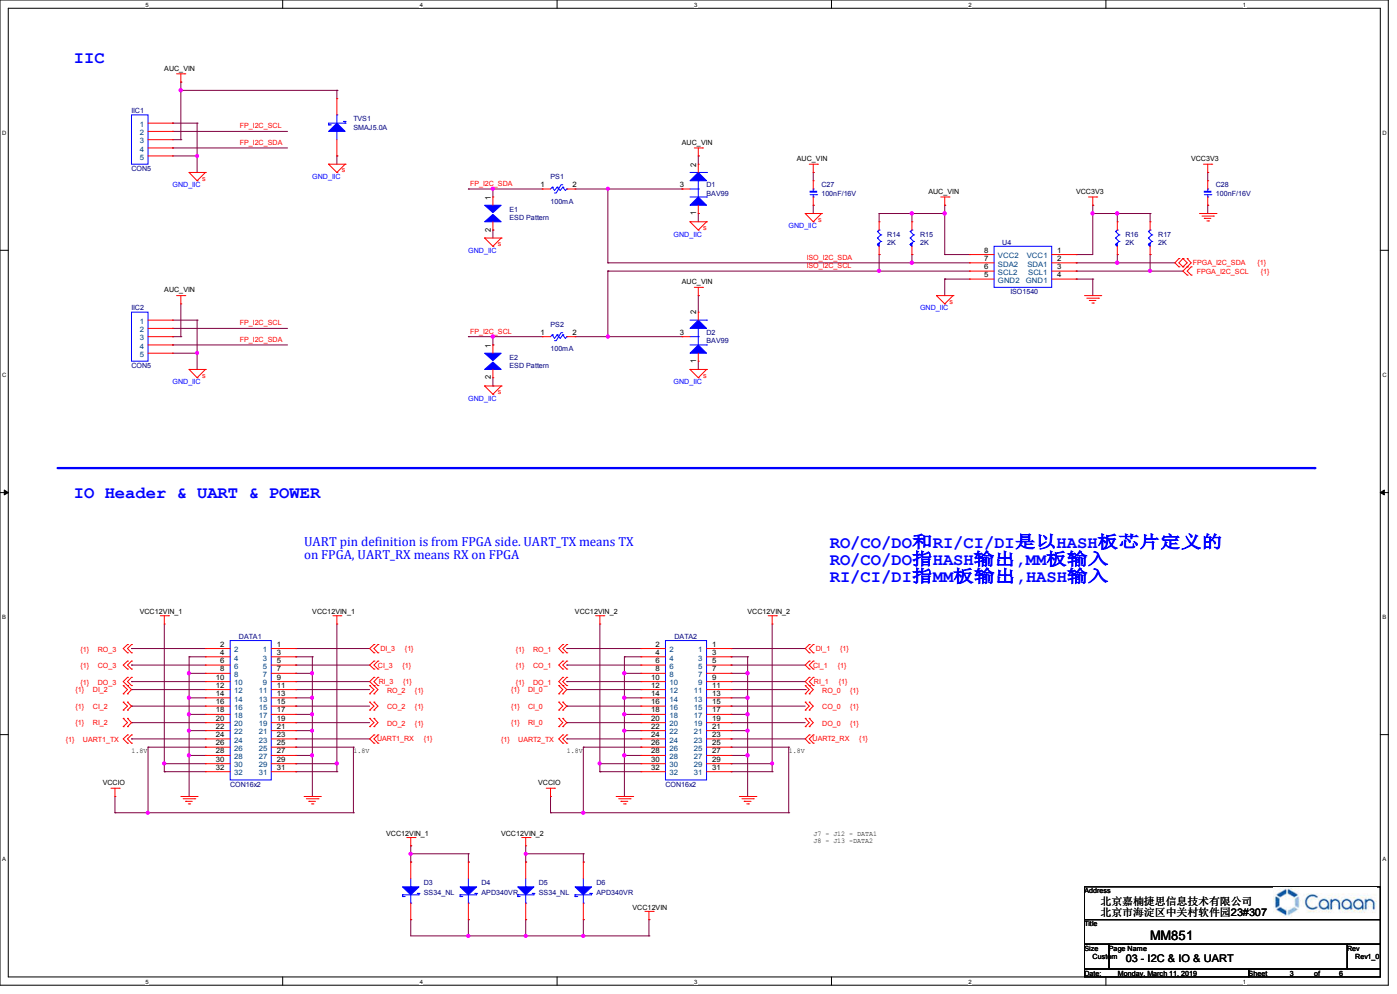
[picture p33: page 3]

UART pin definition is from FPGA side. UART_TX means TX
on FPGA, UART_RX means RX on FPGA

RO/CO/DO和RI/CI/DI是以HASH板芯片定义的
RO/CO/DO指HASH输出,MM板输入
RI/CI/DI指MM板输出,HASH输入

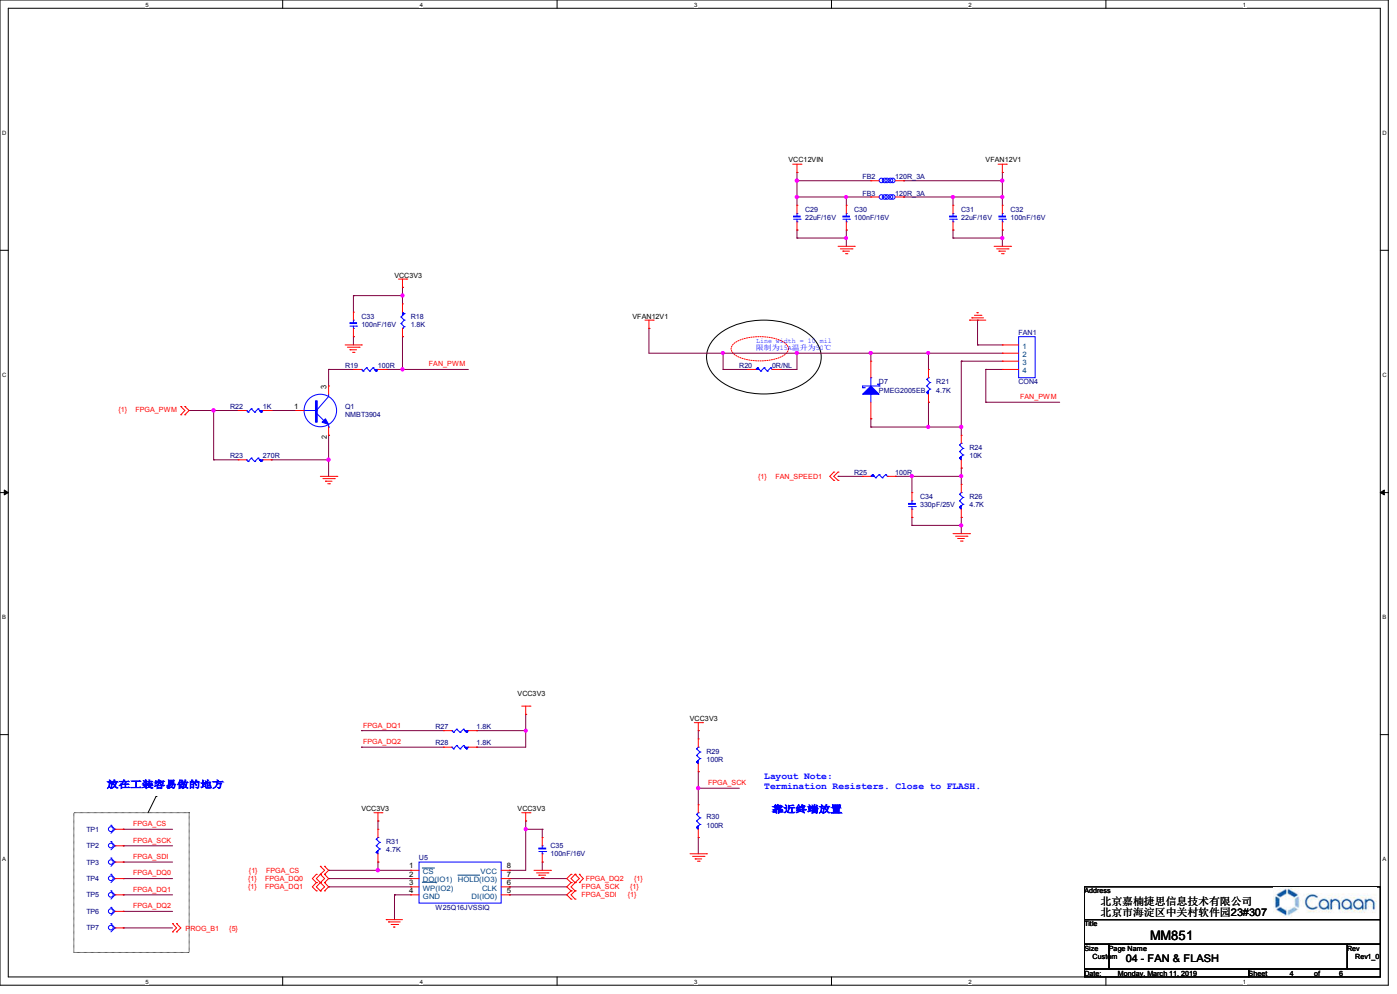
[picture p34: page 4]

Layout Note:
Termination Resisters. Close to FLASH.

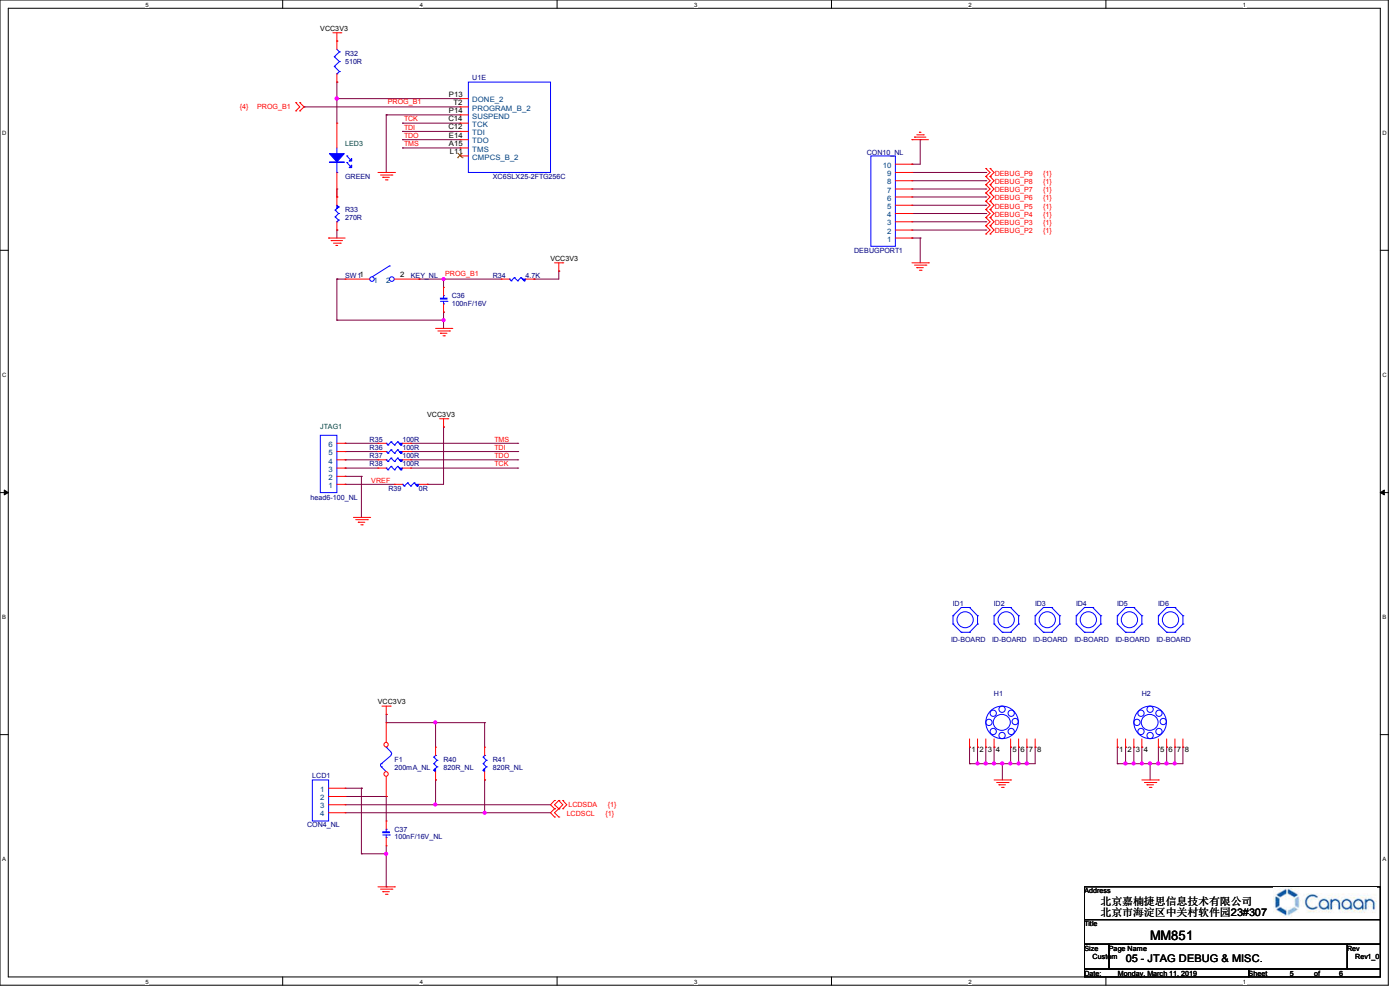
[picture p35: page 5]

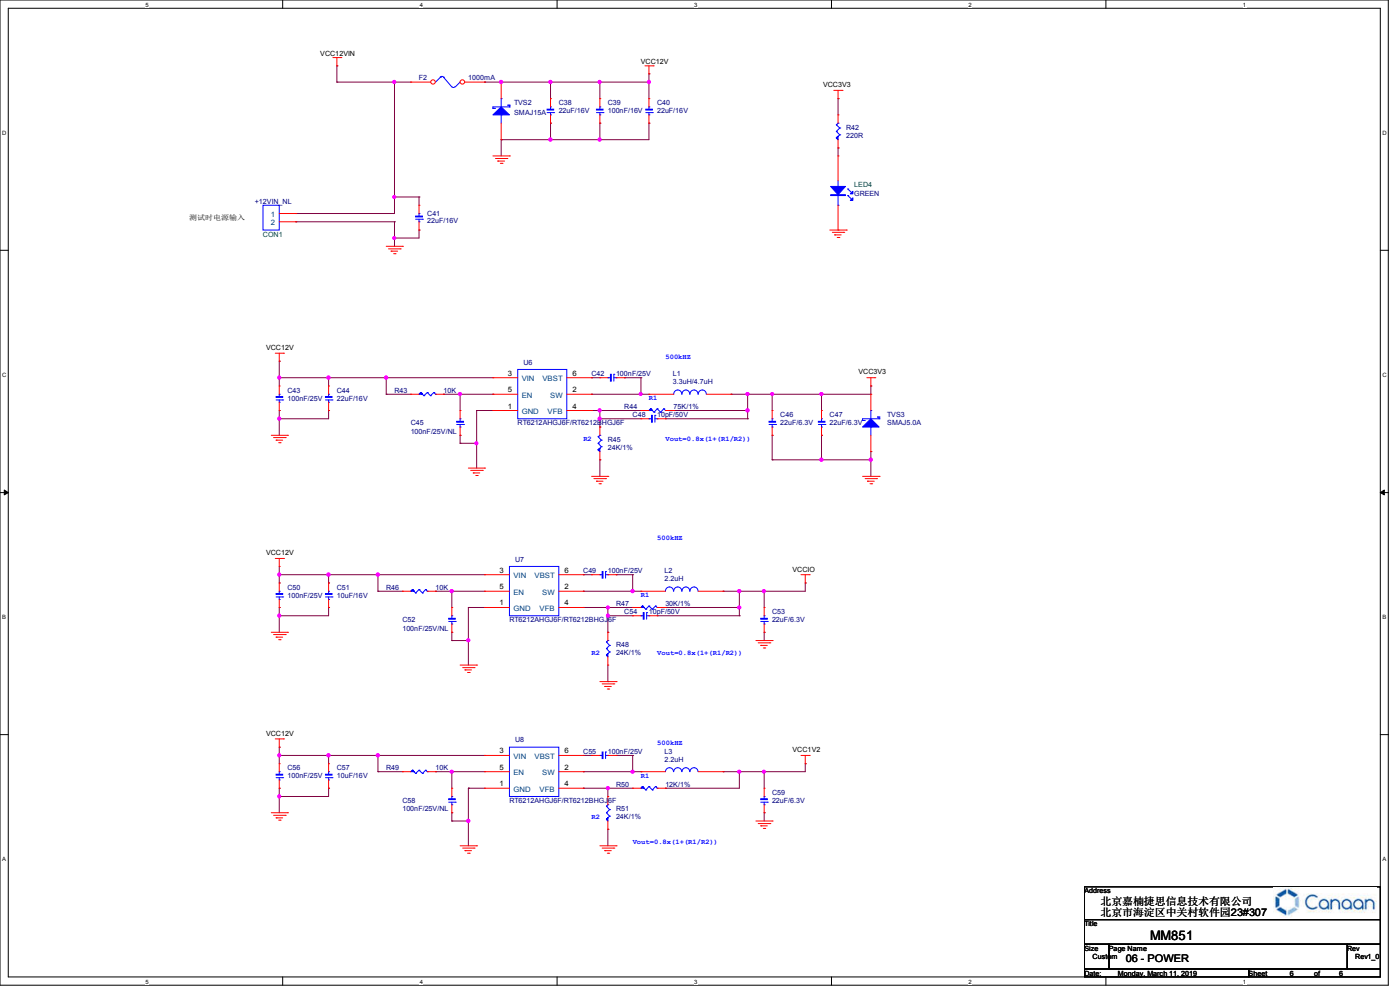
[picture p36: page 6]
