EHash/Open-Hardware-Canaan-A851-A3210M/A851_PMU/ISL8120/SCH/Left_board/PMU851_ISL8120_L_SCH_V1_0_1_190311.pdf

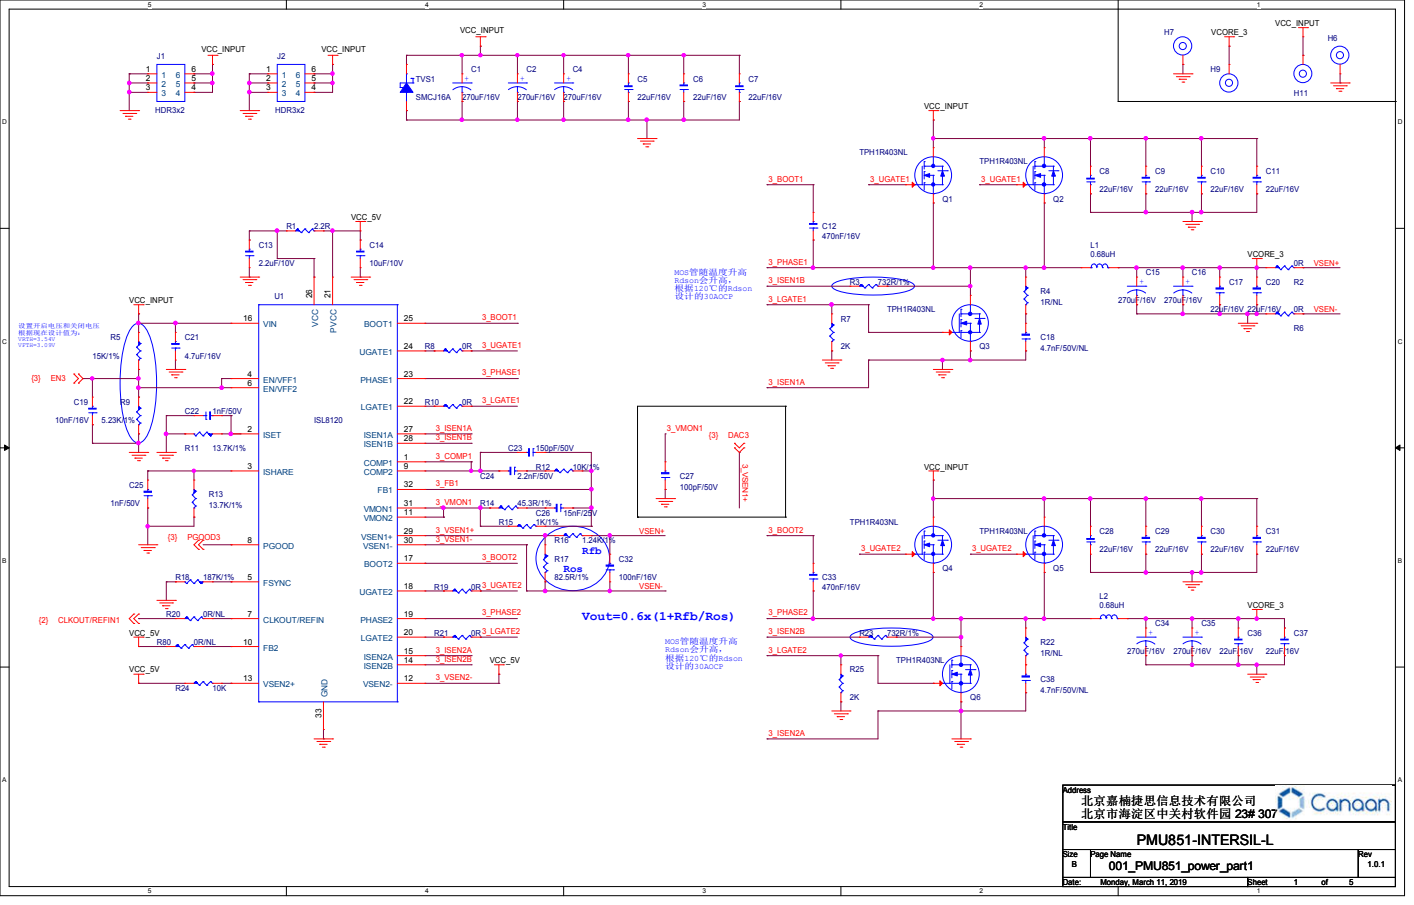
[picture p37: page 1]

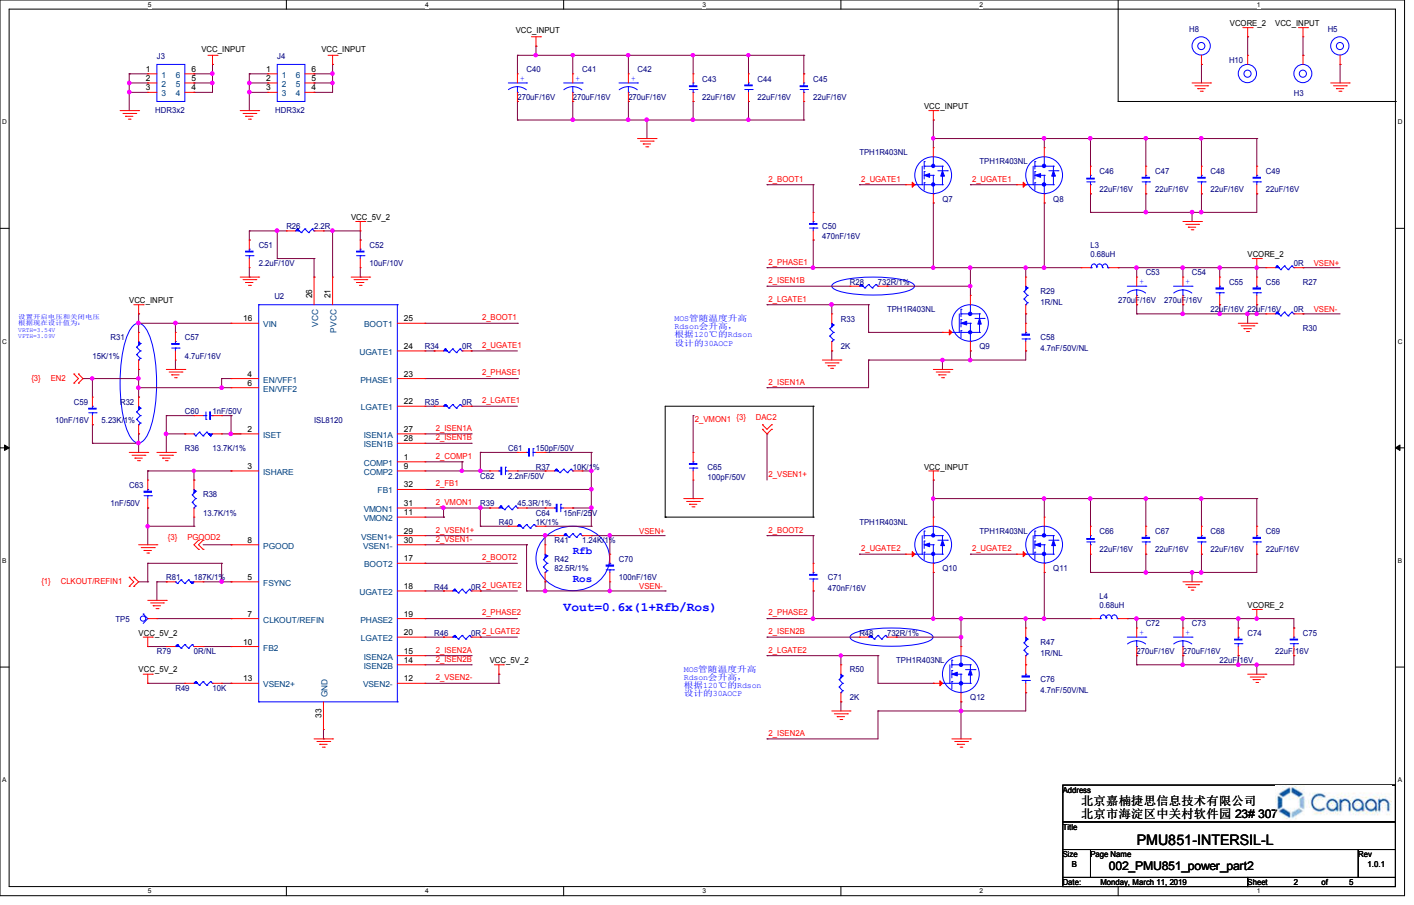
[picture p38: page 2]

## 单片机下载

### Ifs=(0.607V/Rfs)x(15/1.974)

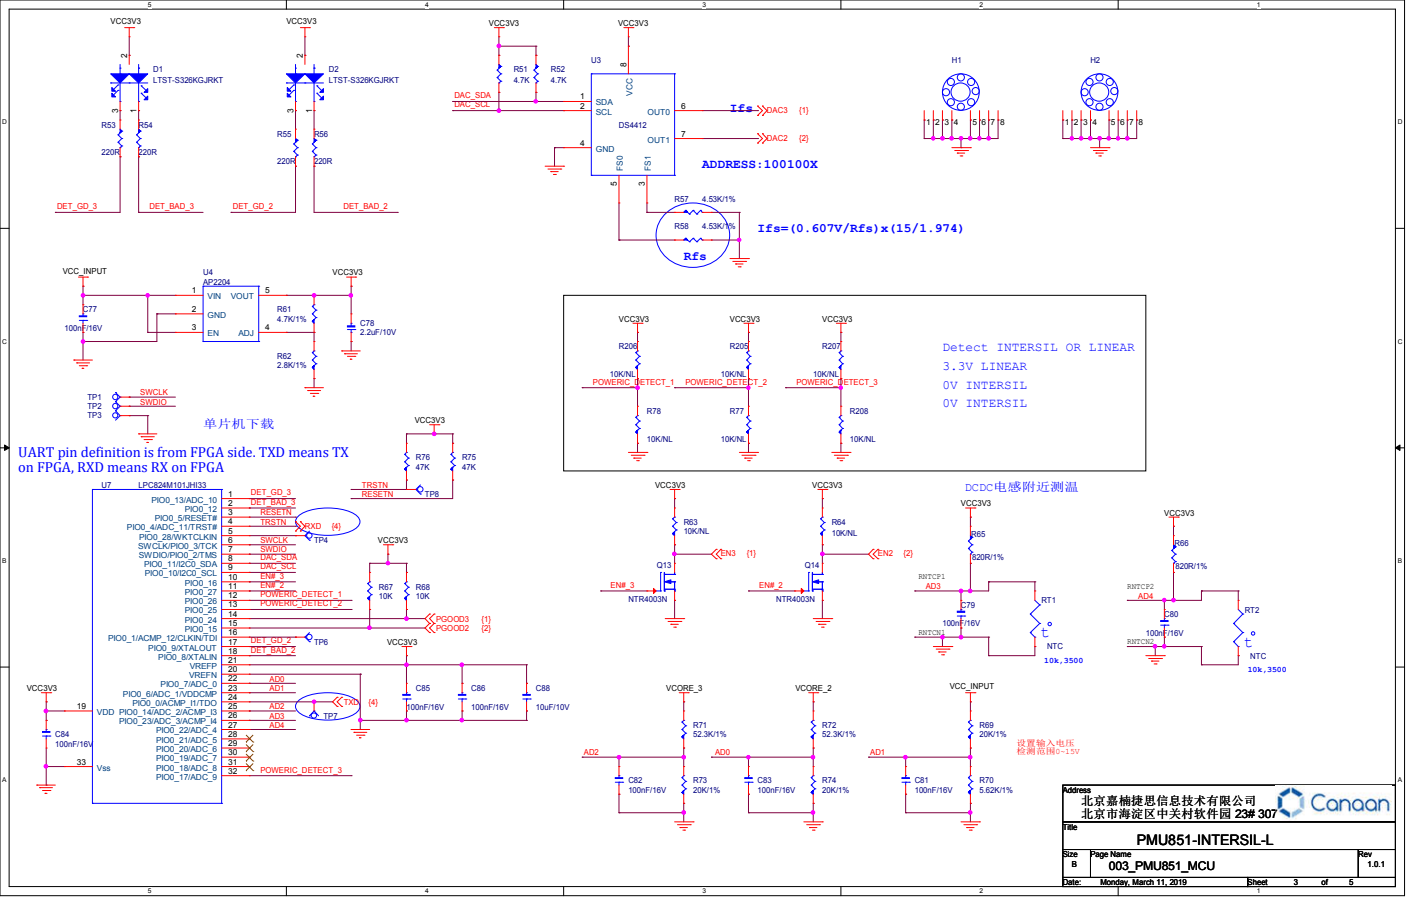
[picture p39: page 3]

Detect INTERSIL OR LINEAR
3.3V LINEAR
0V INTERSIL

UART pin definition is from FPGA side. TXD means TX
on FPGA, RXD means RX on FPGA

# 已经与MM板线序核对完成， 不能进行线序修改！

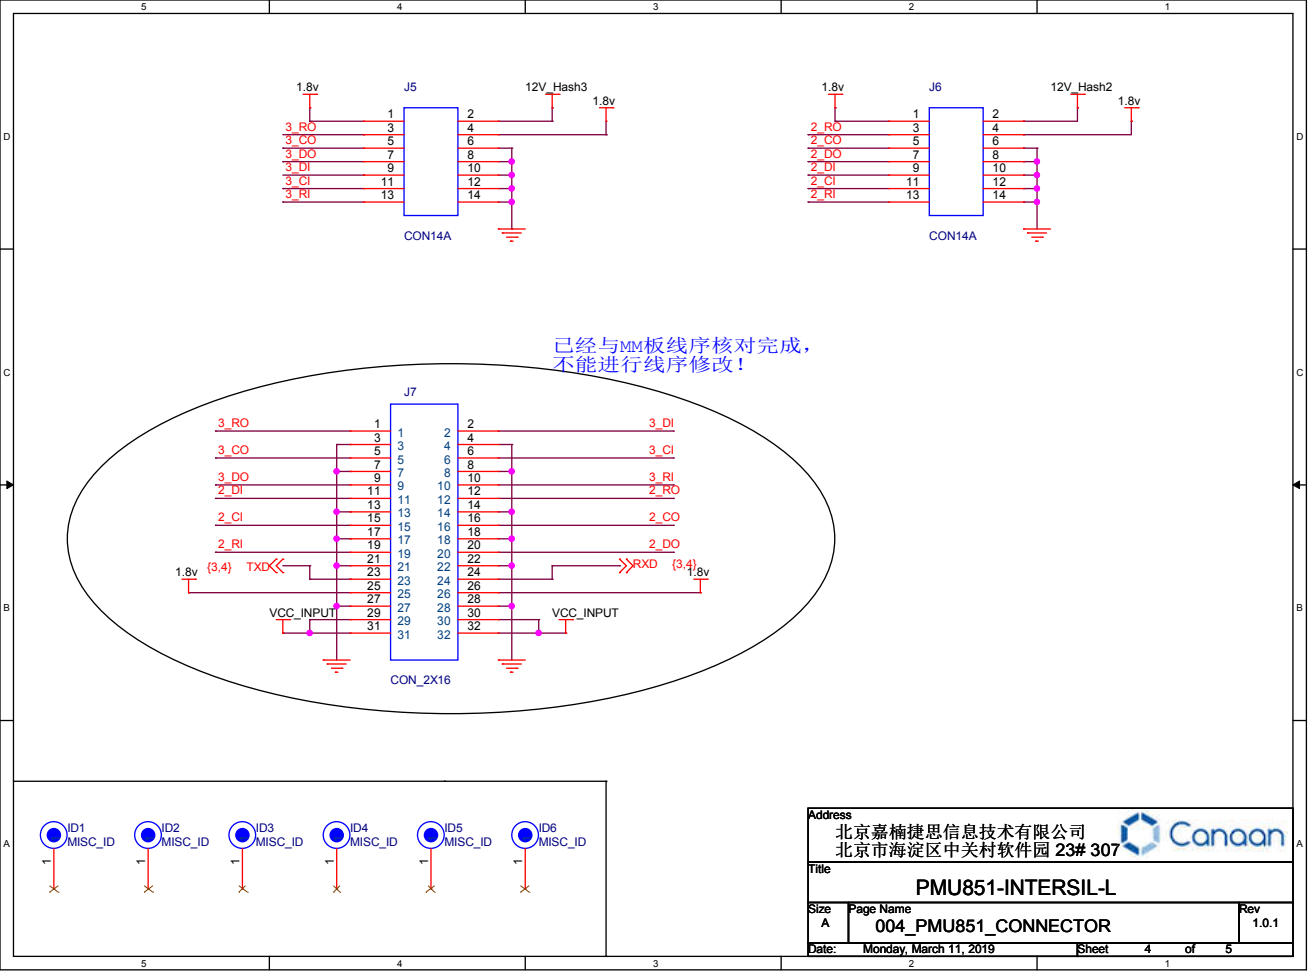
[picture p40: page 4]
VCC_INPUT; 12V_Hash3; 12V_Hash2; TXD; RXD; Title; Size; Page Name; Rev; Date:; Sheet; Address; PMU851-INTERSIL-L; Monday, March 11, 2019; 北京嘉楠捷思信息技术有限公司 北京市海淀区中关村软件园 23# 307; 004_PMU851_CONNECTOR; CON14A; CON_2X16

ID1 MISC_ID | ID2 MISC_ID | ID3 MISC_ID | ID4 MISC_ID | ID5 MISC_ID | ID6 MISC_ID

+15.34V R2

R1

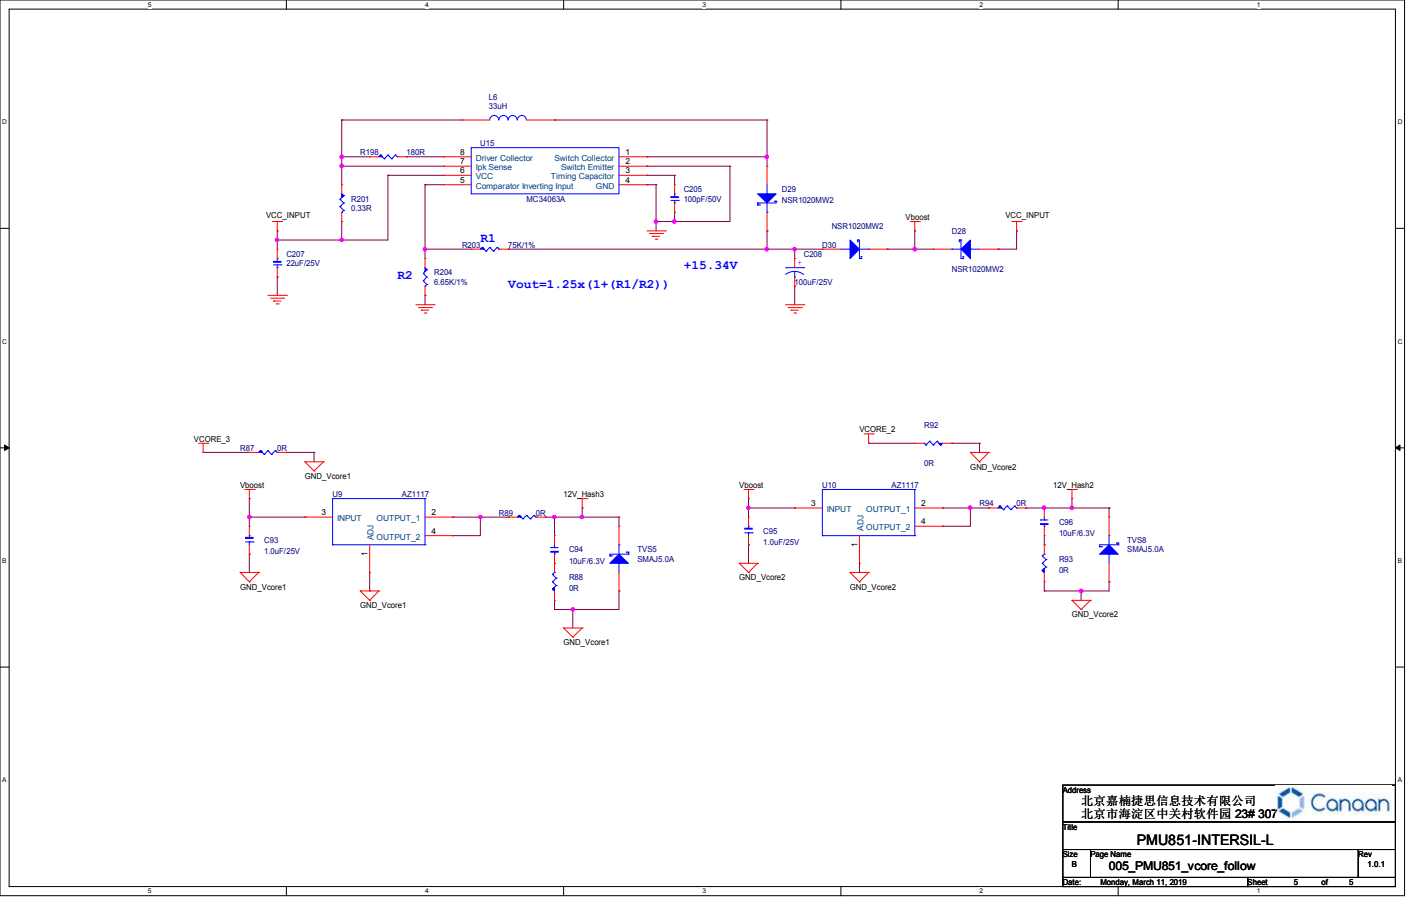
[picture p41: page 5]
