EHash/Open-Hardware-Canaan-A851-A3210M/A851_PMU/ISL8120/SCH/Right_board/pmu851_isl8120_r_sch_v1_0_1_190311.pdf

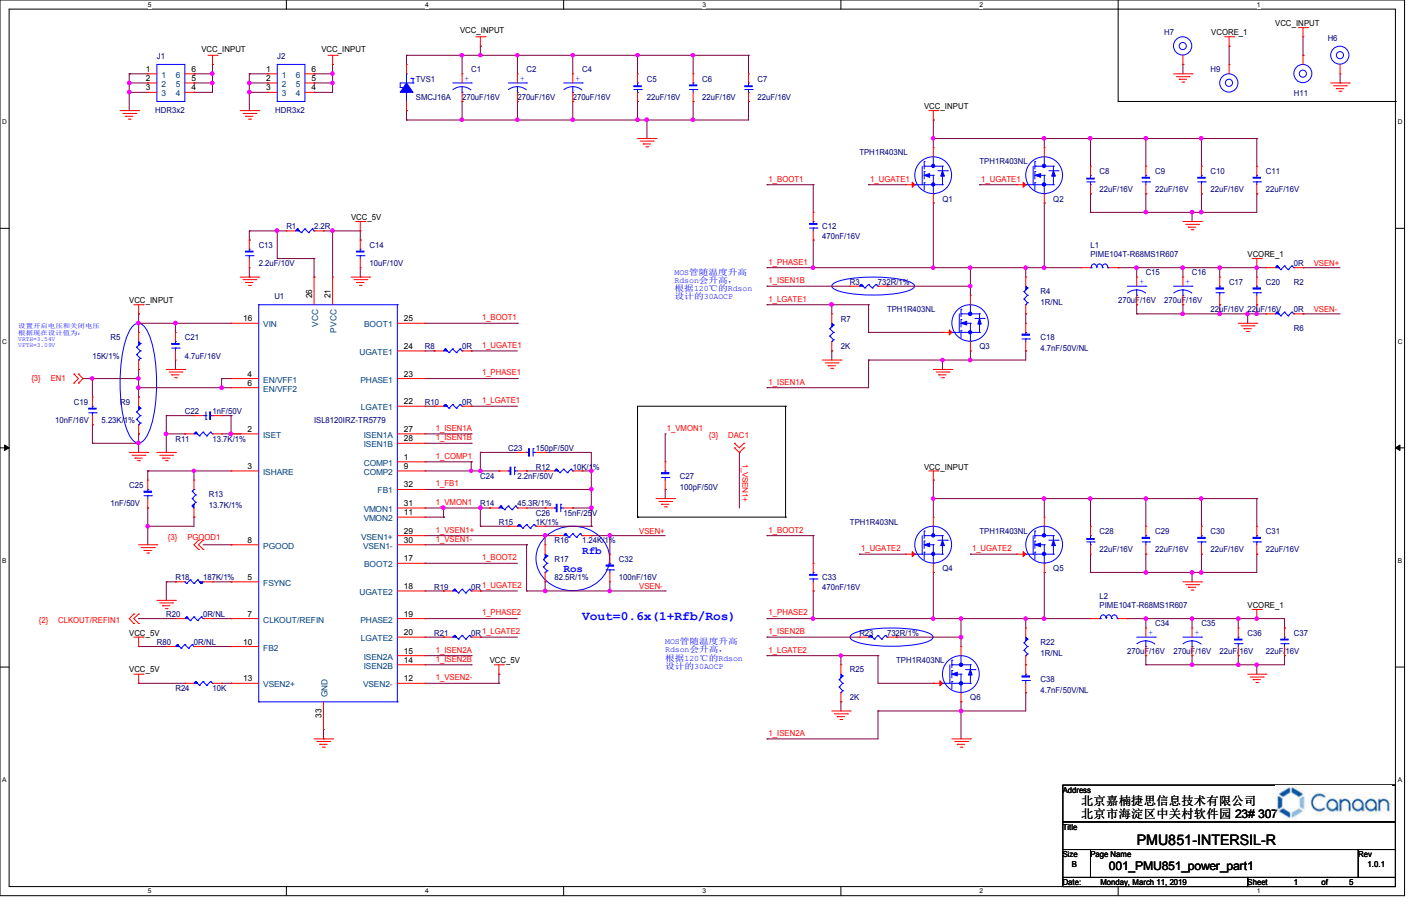
[picture p42: page 1]

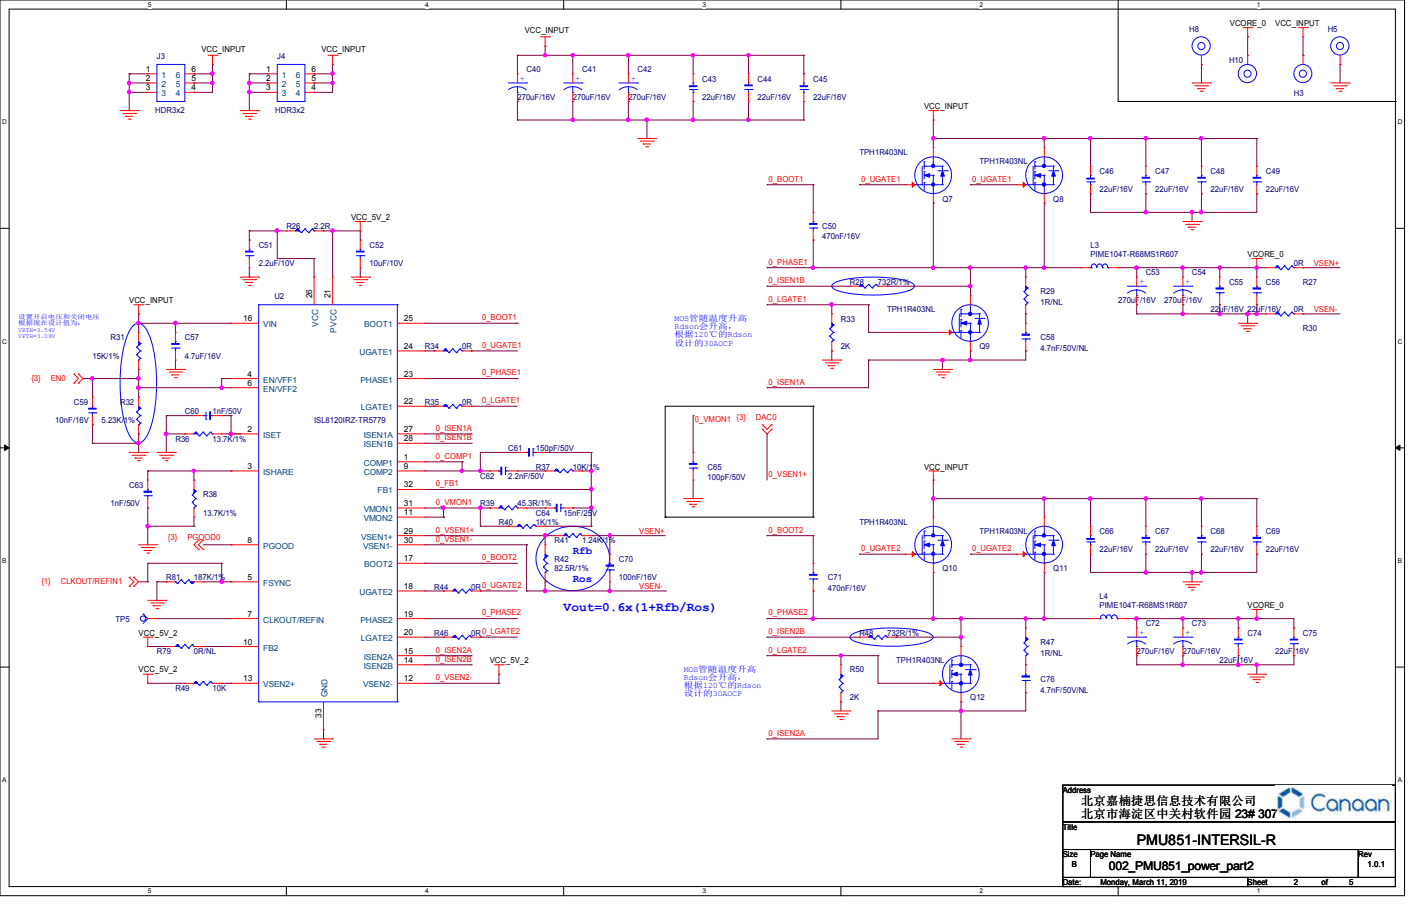
[picture p43: page 2]

## 单片机下载

### Ifs=(0.607V/Rfs)x(15/1.974)

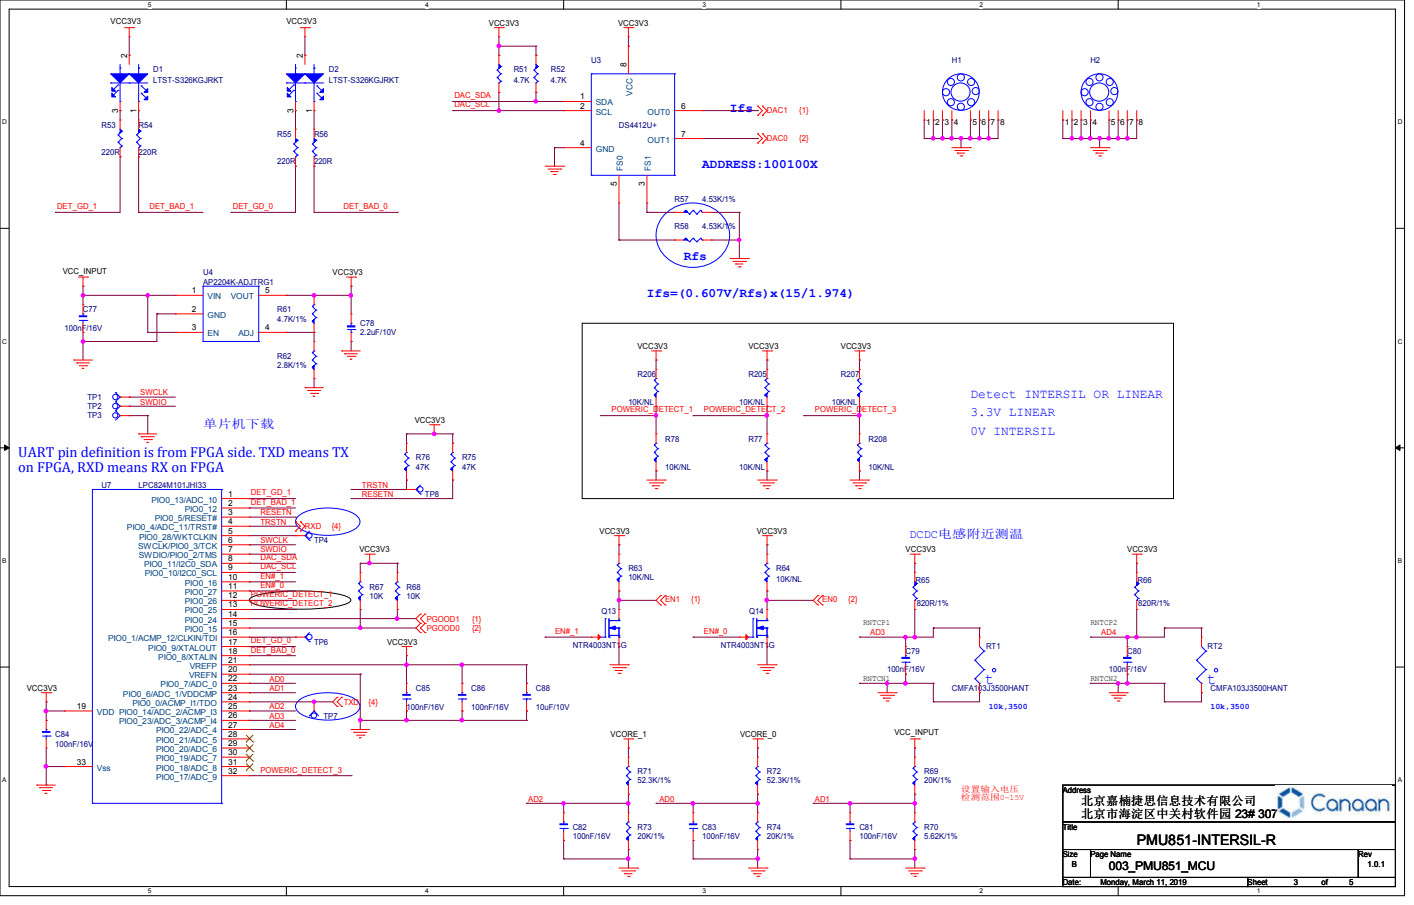
[picture p44: page 3]

Detect INTERSIL OR LINEAR
3.3V LINEAR
0V INTERSIL

UART pin definition is from FPGA side. TXD means TX
on FPGA, RXD means RX on FPGA

# 已经与MM板线序核对完成， 不能进行线序修改！

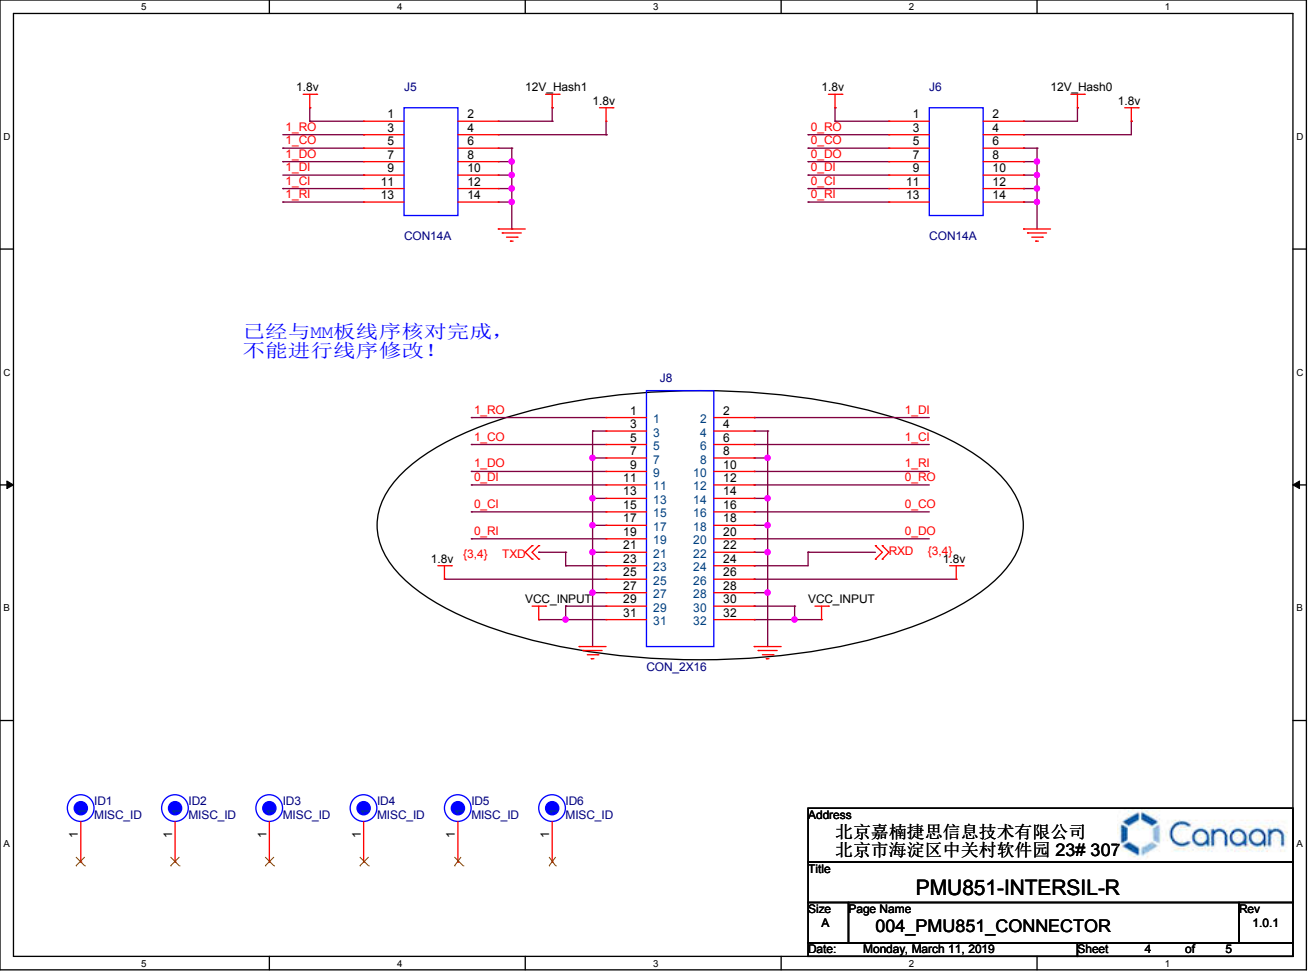
[picture p45: page 4]
12V_Hash1; 12V_Hash0; VCC_INPUT; TXD; RXD; Title; Size; Page Name; Rev; Date:; Sheet; Address; PMU851-INTERSIL-R; Monday, March 11, 2019; 北京嘉楠捷思信息技术有限公司 北京市海淀区中关村软件园 23# 307; 004_PMU851_CONNECTOR; CON14A; MISC_ID; CON_2X16

+15.34V R2 | Vout=1.25x(1+(R1/R2))

R1

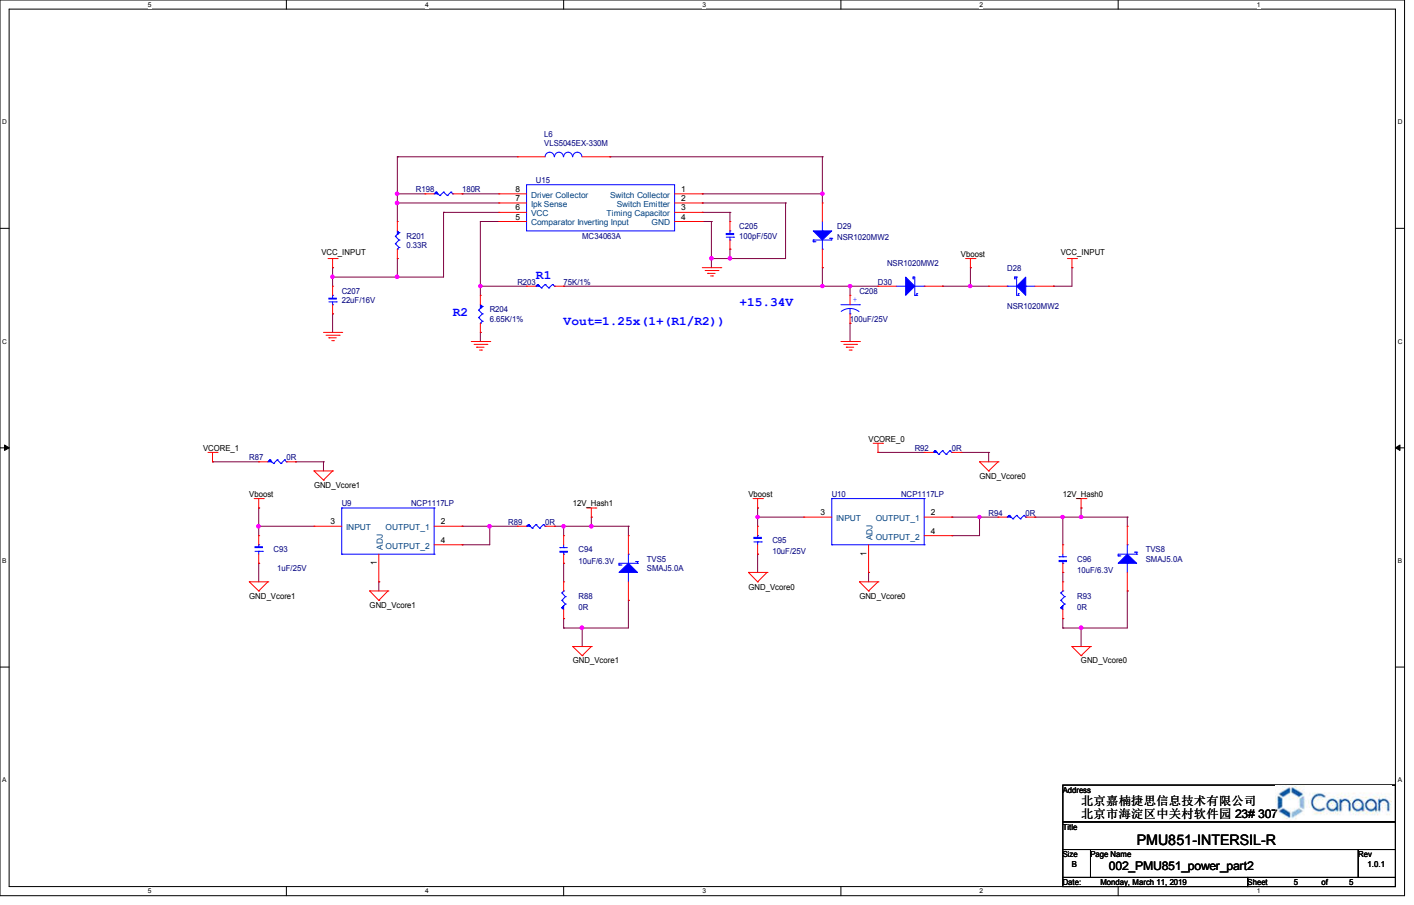
[picture p46: page 5]
