EHash/Open-Hardware-Canaan-A851-A3210M/A851_mechanical/Structural drawing/bah0807v1_1/AvalonMiner 8XX 纸箱图纸 2018-06-04 字体Alireon_（转曲）.pdf

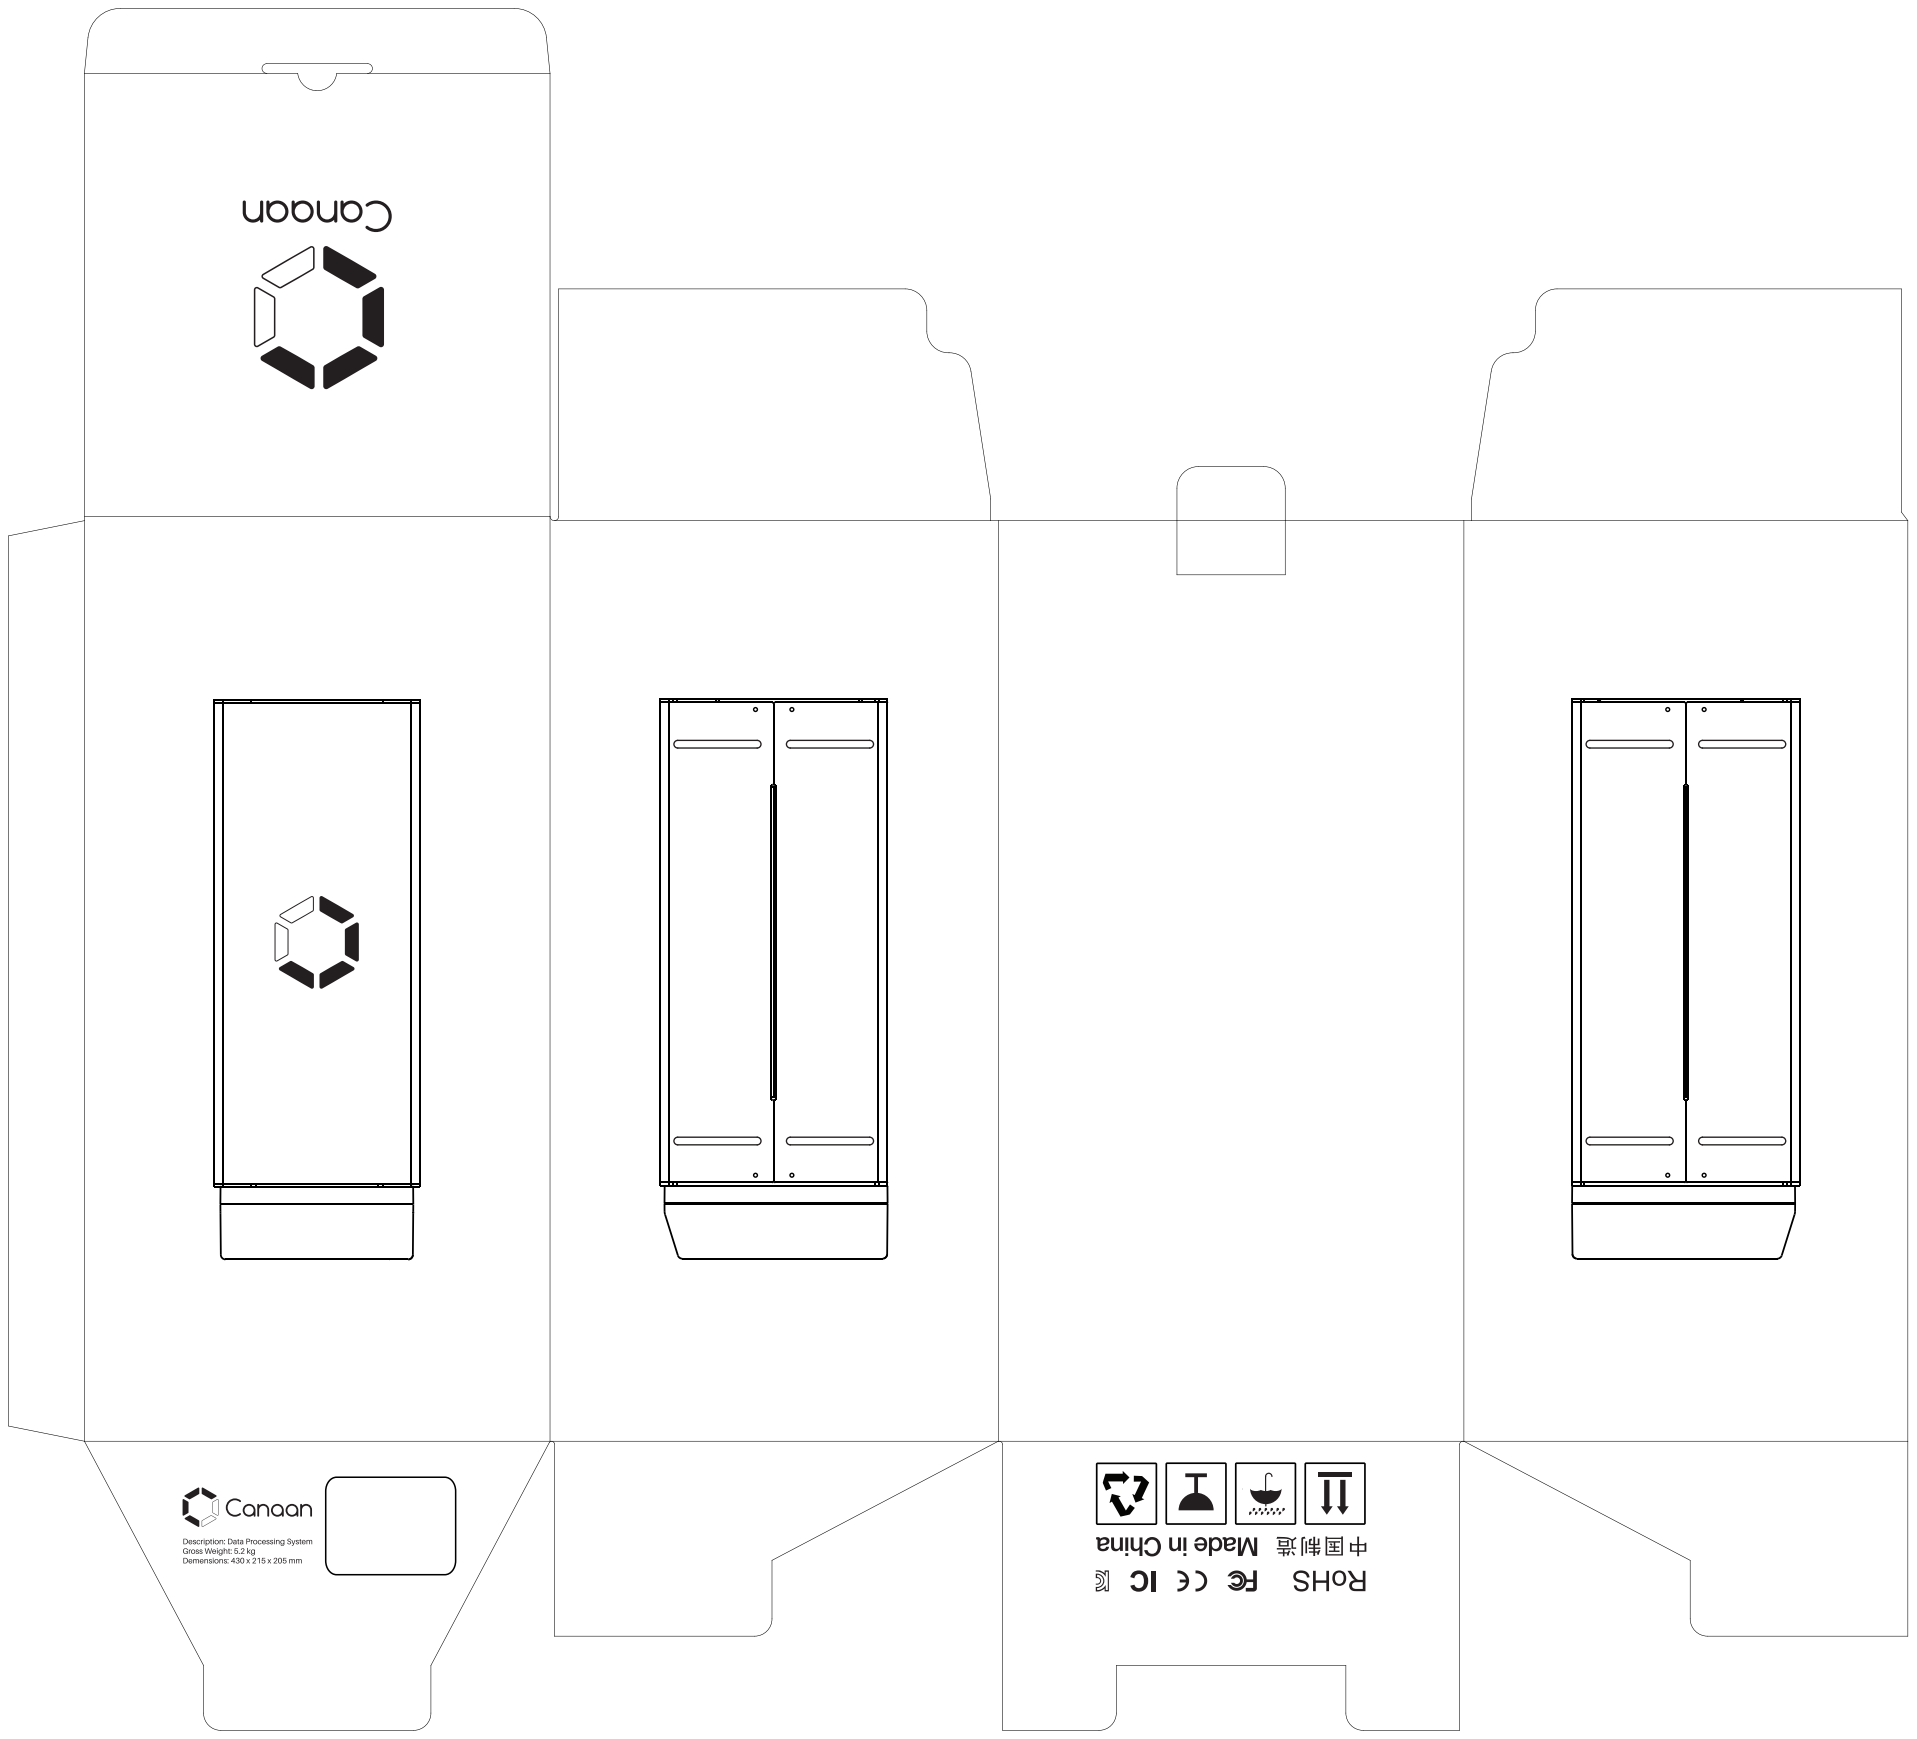
[picture p47: page 1]
