EHash/Open-Hardware-Canaan-A851-A3210M/A851_mechanical/Structural drawing/bah0808v1_4/BAH0808V1_4_(转曲).pdf

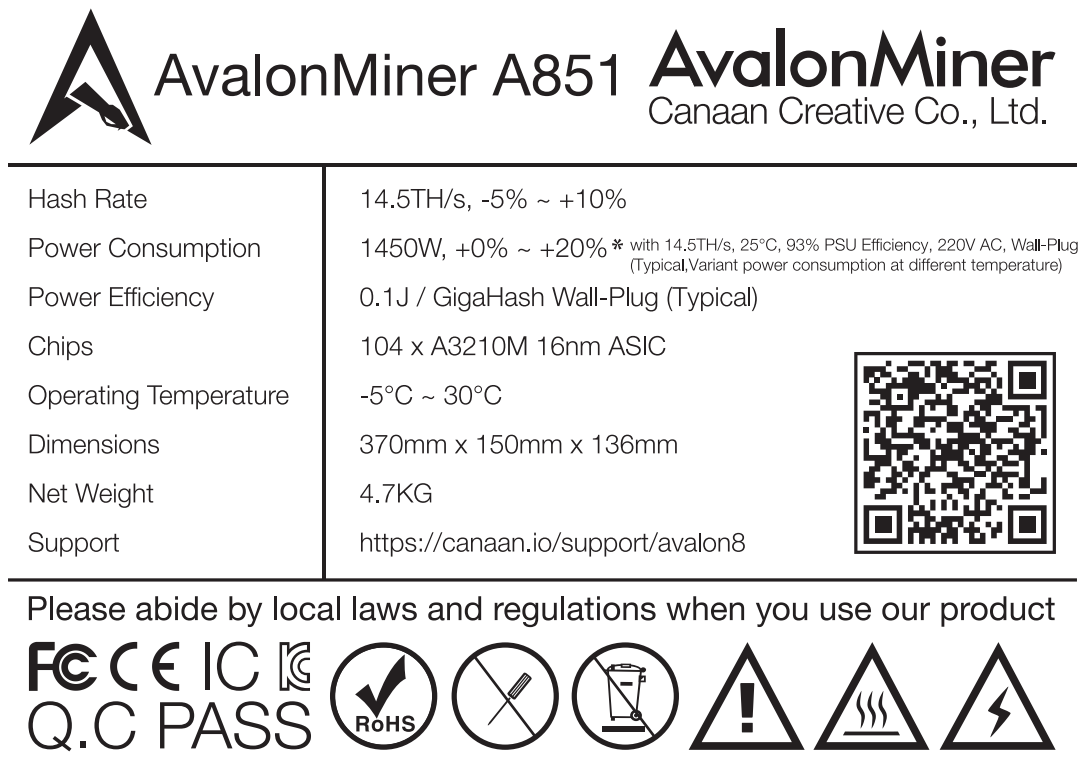
[picture p48: page 1]
Q.C PASS
