EHash/Open-Hardware-Canaan-A851-A3210M/A851_mechanical/Structural drawing/bah0809v1_1/AvalonMiner 851 纸箱条形码 2018-06-14 字体Alireon_（转曲）.pdf

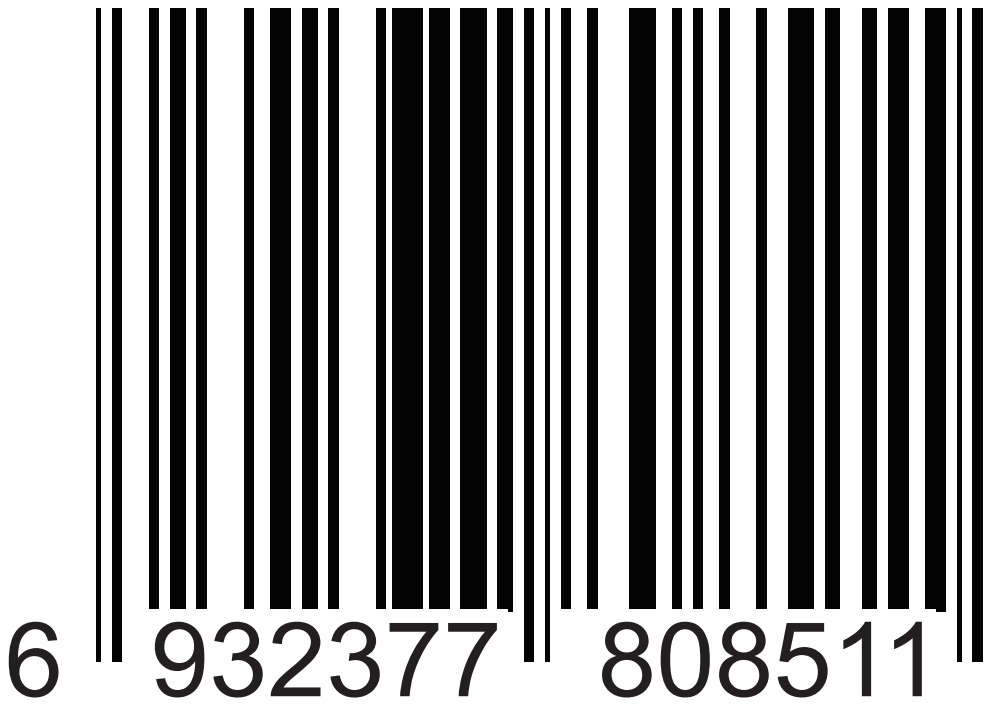
[picture p49: page 1]
