EHash/Open-Hardware-Canaan-A851-A3210M/A851_mechanical/Structural drawing/BO131001131V1_0/bo131001131v1_0.pdf

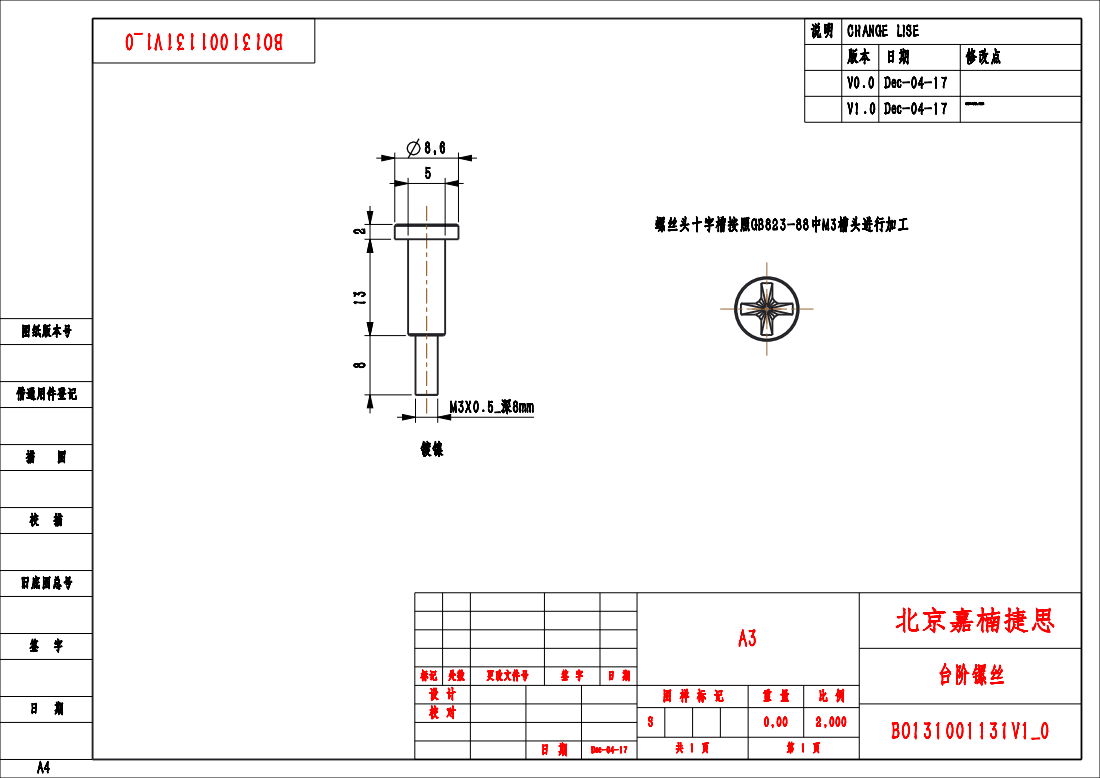
[picture p50: page 1]
图纸版本号; 借通用件登记; 旧底图总号; 北京嘉楠捷思; 更改文件号; 台阶镙丝; Dec-04-17; 修改点; 螺丝头十字槽按照GB823-88中M3槽头进行加工

说明 CHANGE LISE
V0.0 Dec-04-17
V1.0 Dec-04-17 沿用V0.0版本，无修改
