EHash/Open-Hardware-Canaan-A851-A3210M/A851_FC/V1_1/SCH/fc.PDF

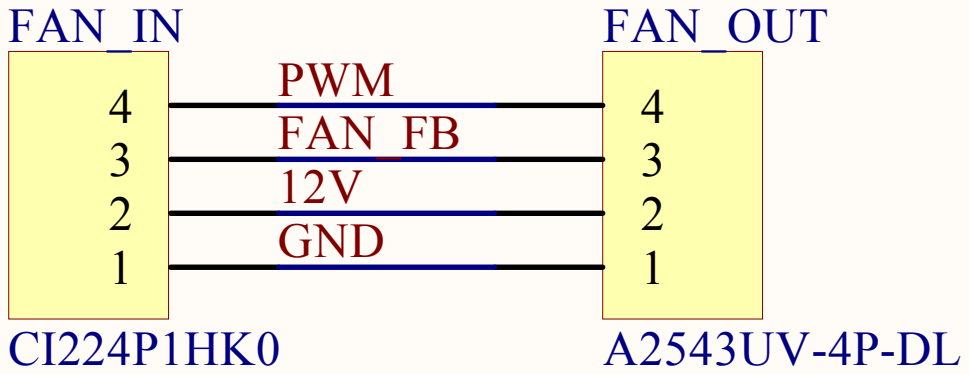
[picture p51: page 1]
