EHash/Open-Hardware-Canaan-A851-A3210M/(list of files, drawings)

Other design files:
A851_FC/V1_1/SCH/FC.SchDoc
A851_HASH/SCH/A3210.SchDoc
A851_HASH/SCH/CONNECTOR.SchDoc
A851_HASH/SCH/total.SchDoc
A851_MM/SCH/MM851_SCH_V1_0_190311.DSN
A851_PMU/ISL8120/SCH/Left_board/PMU851_ISL8120_L_SCH_V1_0_1_190311.DSN
A851_PMU/ISL8120/SCH/Right_board/PMU851_ISL8120_R_SCH_V1_0_1_190311.DSN
