EHash/Open-Hardware-Canaan-A851-A3210M/(commit log)

2019-03-29 Add more design files
    [A3210.SchDoc, CONNECTOR.SchDoc, FC.SchDoc, MM851_SCH_V1_0_190311.DSN, PMU851_ISL8120_L_SCH_V1_0_1_190311.DSN, PMU851_ISL8120_R_SCH_V1_0_1_190311.DSN, PMU851_IS_L_V1_0_180330.brd, PMU851_IS_R_V1_0_180330.brd]
2019-03-29 Add BOM
    1、统一器件类型名称
    2、统一器件封装名称
    3、统一删除BOM中PCB、测试点螺丝孔等项目
    4、统一NOTE中内容
    5、删除备注中无关内容
    [FC7_V1.1_BOM.xls, HASH851-x26_V1.0.2_BOM.xls, MM851_V1.0.2_BOM.xls, PMU851_ISL8120_L_V1.0.4_BOM.xls, PMU851_ISL8120_R_V1.0.4_BOM.xls]
2019-05-07 Add structural drawing
    [bah0101v2_0.stp, bah0102v2_0_asm.stp, bah0103v2_0.stp, bah0104v1_1.stp, bah0104v2_0.stp, bah0202v3_1.stp, bah0203v1_0.stp, bah0301v1_0.stp]
